ossehaas/Robot-Evolution-Lab/runs/exp2_dog/30_level_body/replay.md

# Replays of the capped plans (step 50)

Share of dogs that climbed: nominal dog (1) / randomized dogs (16). pitch err = largest pitch error of the randomized dogs [deg]. '.' = no plan.

| rise / tread | max 5 | max 10 | max 15 | free |
|---|---|---|---|---|
| 2 / 25 | . | . | . | 0% / 0% (err 90) |
| 2 / 20 | . | . | . | 0% / 0% (err 91) |
| 2 / 15 | . | . | . | 0% / 0% (err 90) |
| 2 / 12 | . | . | . | 0% / 0% (err 84) |
| 2 / 9 | . | . | . | 0% / 0% (err 87) |
| 3 / 25 | . | . | . | 0% / 0% (err 90) |
| 3 / 20 | . | . | . | 0% / 0% (err 88) |
| 3 / 15 | . | . | . | 0% / 0% (err 85) |
| 3 / 12 | . | . | . | 0% / 0% (err 85) |
| 3 / 9 | . | . | . | 0% / 0% (err 84) |
| 4 / 25 | . | . | . | 0% / 0% (err 85) |
| 4 / 20 | . | . | . | 0% / 0% (err 83) |
| 4 / 15 | . | . | . | 0% / 0% (err 93) |
| 4 / 12 | . | . | . | 0% / 0% (err 80) |
| 4 / 9 | . | . | . | 0% / 0% (err 79) |
| 5 / 25 | . | . | . | 0% / 0% (err 95) |
| 5 / 20 | . | . | . | 0% / 0% (err 94) |
| 5 / 15 | . | . | . | 0% / 0% (err 81) |

Mean over the stairs each has a plan for, randomized: max 5: 0%, max 10: 0%, max 15: 0%, free: 0%
