ossehaas/Robot-Evolution-Lab/runs/exp2_dog/30_level_body/replay_open.md

# Replays of the capped plans (step 50)

Share of dogs that climbed without a fall: nominal dog (1) / randomized dogs (16). '.' = no plan.

## open, balance margin 1.5 cm

| rise / tread | max 5 | max 10 | max 15 | free |
|---|---|---|---|---|
| 2 / 25 | 0% / 44% | 0% / 38% | 0% / 31% | 0% / 44% |
| 2 / 20 | 0% / 50% | 0% / 50% | 0% / 38% | 0% / 88% |
| 2 / 15 | 0% / 19% | 0% / 6% | 0% / 12% | 0% / 19% |
| 2 / 12 | 0% / 19% | 0% / 75% | 0% / 75% | 0% / 75% |
| 2 / 9 | 0% / 62% | 0% / 75% | 0% / 81% | 0% / 81% |
| 3 / 25 | 0% / 38% | 0% / 50% | 0% / 56% | 0% / 38% |
| 3 / 20 | 0% / 0% | 0% / 0% | 0% / 6% | 0% / 0% |
| 3 / 15 | 0% / 0% | 0% / 19% | 0% / 19% | 0% / 12% |
| 3 / 12 | 0% / 12% | 0% / 94% | 0% / 75% | 0% / 88% |
| 3 / 9 | 100% / 88% | 0% / 81% | 0% / 62% | 0% / 81% |
| 4 / 25 | 0% / 75% | 0% / 44% | 0% / 56% | 0% / 44% |
| 4 / 20 | 100% / 94% | 0% / 38% | 0% / 75% | 0% / 62% |
| 4 / 15 | . | 0% / 81% | 0% / 69% | 0% / 81% |
| 4 / 12 | . | 0% / 94% | 0% / 81% | 0% / 81% |
| 4 / 9 | . | . | 0% / 50% | 0% / 94% |
| 5 / 25 | 0% / 31% | 0% / 6% | 0% / 38% | 0% / 12% |
| 5 / 20 | 0% / 81% | 0% / 50% | 0% / 50% | 0% / 50% |
| 5 / 15 | . | . | . | 0% / 56% |

Randomized dogs that climbed, mean over the 14 stairs all four have a plan for: max 5 44%, max 10 45%, max 15 48%, free 50%

## open, balance margin 3.0 cm

| rise / tread | max 5 | max 10 | max 15 | free |
|---|---|---|---|---|
| 2 / 25 | 0% / 19% | 0% / 12% | 0% / 6% | 0% / 12% |
| 2 / 15 | 0% / 62% | 0% / 19% | 0% / 81% | 0% / 81% |
| 2 / 12 | 0% / 44% | 0% / 56% | 0% / 69% | 0% / 69% |
| 2 / 9 | 0% / 50% | 0% / 94% | 0% / 88% | 0% / 88% |
| 3 / 25 | 0% / 44% | 0% / 31% | 0% / 25% | 0% / 38% |
| 3 / 15 | . | 0% / 56% | 0% / 62% | 0% / 38% |
| 3 / 12 | 0% / 25% | 0% / 75% | 0% / 69% | 0% / 69% |
| 4 / 25 | 0% / 31% | 0% / 56% | 0% / 38% | 0% / 19% |

Randomized dogs that climbed, mean over the 7 stairs all four have a plan for: max 5 39%, max 10 49%, max 15 54%, free 54%

## feedback, balance margin 3.0 cm

| rise / tread | max 5 | max 10 | max 15 | free |
|---|---|---|---|---|
| 2 / 25 | 0% / 0% | 0% / 0% | 0% / 0% | 0% / 0% |
| 2 / 15 | 0% / 0% | 0% / 0% | 0% / 0% | 0% / 0% |
| 2 / 12 | 0% / 0% | 0% / 0% | 0% / 0% | 0% / 0% |
| 2 / 9 | 0% / 0% | 0% / 0% | 0% / 0% | 0% / 0% |
| 3 / 25 | 0% / 0% | 0% / 0% | 0% / 0% | 0% / 0% |
| 3 / 15 | . | 0% / 0% | 0% / 0% | 0% / 0% |
| 3 / 12 | 0% / 0% | 0% / 0% | 0% / 0% | 0% / 0% |
| 4 / 25 | 0% / 0% | 0% / 0% | 0% / 0% | 0% / 0% |

Randomized dogs that climbed, mean over the 7 stairs all four have a plan for: max 5 0%, max 10 0%, max 15 0%, free 0%
