ossehaas/Robot-Evolution-Lab/prototypes/puppy/images/puppy_before_after.png

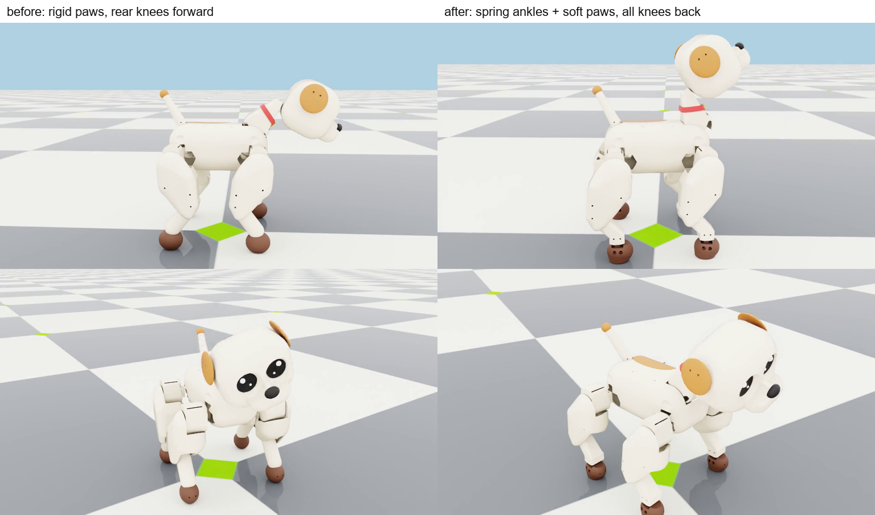
prototypes/puppy/images/puppy_before_after.png
