ossehaas/Robot-Evolution-Lab/prototypes/puppy/images/puppy_exploded.png

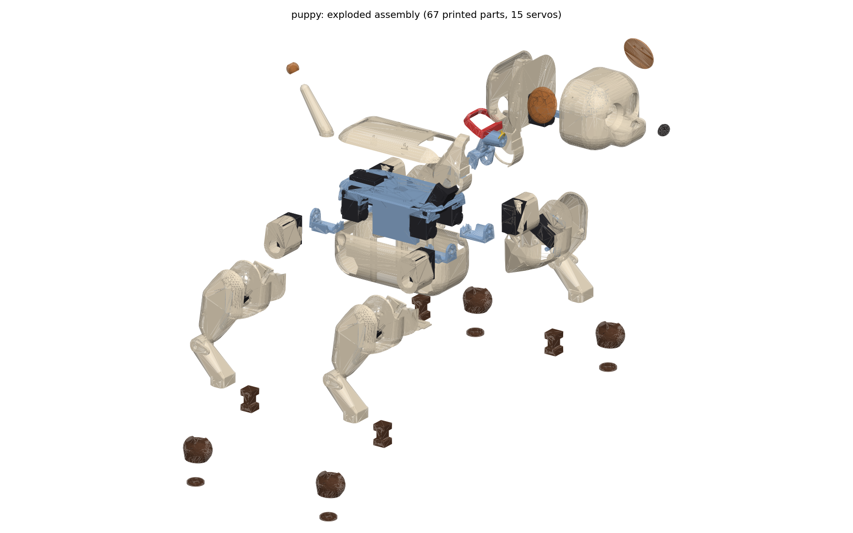
prototypes/puppy/images/puppy_exploded.png
