ossehaas/Robot-Evolution-Lab/prototypes/puppy/images/puppy_side.png

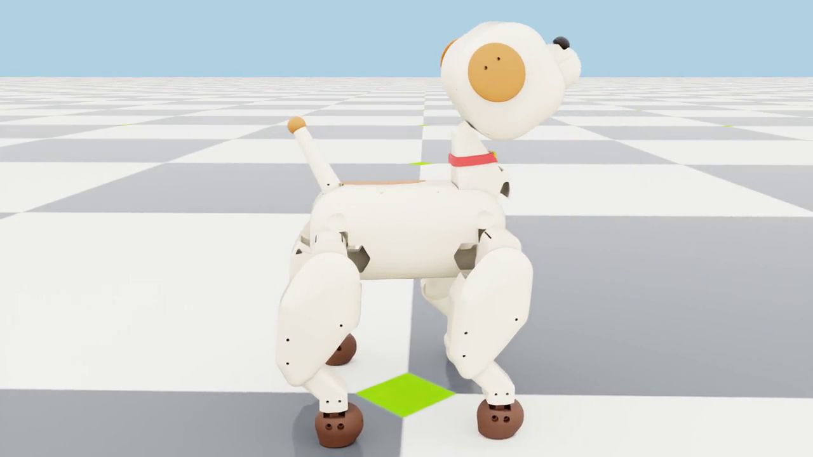
prototypes/puppy/images/puppy_side.png
