ossehaas/Robot-Evolution-Lab/prototypes/puppy/preview.png

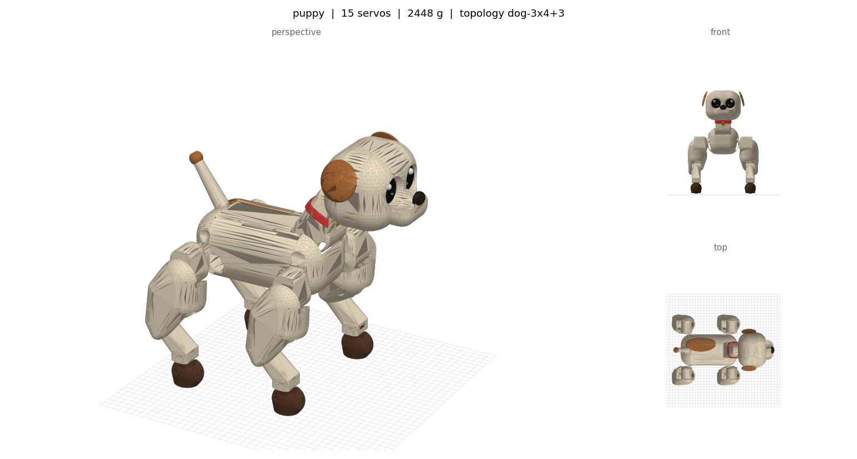
prototypes/puppy/preview.png
