ossehaas/Robot-Evolution-Lab/prototypes/puppy/print/BOM.md

# Bill of materials: puppy

Total mass (simulated): **2448 g**, of which printed parts ~1185 g.
Servos: 15 x Feetech STS3215 (12 V); rest height of the chassis centre: 191 mm.

## Printed parts

| Part | Material | Mass (g) | Size on the bed (mm) | File | Notes |
|---|---|---|---|---|---|
| head | PLA | 109.1 | 125 x 105 x 101 | `stl/head.stl` | face + snout, eye openings; print standing on the back rim (face up) |
| head_back | PLA | 35.1 | 115 x 95 x 19 | `stl/head_back.stl` | back of the head; print on its rim |
| head_mount | PLA | 32.9 | 119 x 99 x 4 | `stl/head_mount.stl` | plate between head and head back: carries the tilt servo and the eye frame; print flat |
| eye_frame | PLA | 12.9 | 108 x 44 x 65 | `stl/eye_frame.stl` | holds the two round displays; print on the front face |
| nose | PLA | 1.8 | 24 x 18 x 11 | `stl/nose.stl` | black PLA, print on the flat back, glue into its pocket |
| ear_L | TPU | 7.6 | 52 x 55 x 7 | `stl/ear_L.stl` | TPU 95A, print on the flat back |
| ear_R | TPU | 7.6 | 52 x 55 x 7 | `stl/ear_R.stl` | TPU 95A, print on the flat back |
| neck_yoke | PLA | 16.7 | 45 x 68 x 56 | `stl/neck_yoke.stl` | U-bracket on both neck horns + stem to the head-tilt horn; print on the stem plate |
| collar | TPU | 6.2 | 44 x 59 x 9 | `stl/collar.stl` | TPU ring, stretch over the neck into its groove |
| collar_tag | PLA | 0.5 | 14 x 16 x 8 | `stl/collar_tag.stl` | yellow PLA tag, glue to the collar |
| tail | PLA | 10.1 | 58 x 22 x 71 | `stl/tail.stl` | print standing on the base disc |
| tail_tip | PLA | 2.0 | 19 x 19 x 14 | `stl/tail_tip.stl` | print on the flat, glue onto the tail peg |
| neck_L | PLA | 11.9 | 55 x 94 x 27 | `stl/neck_L.stl` | neck shell half; print on the split face |
| neck_R | PLA | 11.2 | 55 x 90 x 27 | `stl/neck_R.stl` | neck shell half; print on the split face |
| deck | PLA | 107.0 | 187 x 98 x 73 | `stl/deck.stl` | structural core: servo saddles, battery bay, tail shelf; print upside down (top face on the bed) |
| neck_mount | PLA | 3.0 | 31 x 48 x 16 | `stl/neck_mount.stl` | holds the neck servo on the deck; print on its base |
| cap | PLA | 46.1 | 188 x 100 x 19 | `stl/cap.stl` | the back; print on its rim (no supports, the roof bridges) |
| bowl | PLA | 121.5 | 200 x 110 x 76 | `stl/bowl.stl` | belly and flanks; print upside down on its rim |
| belly_hatch | PLA | 9.6 | 96 x 37 x 4 | `stl/belly_hatch.stl` | battery door; print flat, outside down |
| yoke_front_L | PLA | 7.9 | 45 x 33 x 27 | `stl/yoke_front_L.stl` | U-bracket on both abduction horns; print standing on the bridge |
| shoulder_front_L | PLA | 27.8 | 38 x 58 x 48 | `stl/shoulder_front_L.stl` | pad + hip bracket + tongue; print on the flat outboard rim, no supports |
| thigh_front_L | PLA | 26.6 | 80 x 110 x 35 | `stl/thigh_front_L.stl` | structural thigh: hip hub, knee servo pocket, knee fork; print on the flat outboard face |
| thigh_cover_out_front_L | PLA | 24.4 | 77 x 123 x 19 | `stl/thigh_cover_out_front_L.stl` | outer thigh cover over crank and pushrod; print on its rim |
| thigh_cover_in_front_L | PLA | 14.9 | 67 x 70 x 14 | `stl/thigh_cover_in_front_L.stl` | inner thigh cover over the knee servo connectors; print on its rim |
| crank_front_L | PLA | 2.2 | 34 x 21 x 4 | `stl/crank_front_L.stl` | knee crank on the knee servo horn |
| pushrod_front_L | PLA | 2.9 | 20 x 61 x 5 | `stl/pushrod_front_L.stl` | knee pushrod, 683ZZ bearing pressed into each eye |
| knee_spacer_front_L | PLA | 0.2 | 6 x 6 x 8 | `stl/knee_spacer_front_L.stl` | spacer tube on the knee axle |
| shin_front_L | PLA | 23.2 | 65 x 68 x 31 | `stl/shin_front_L.stl` | shin with knee boss and lever; print on the flat lever face |
| ankle_spring_front_L | TPU | 11.7 | 20 x 34 x 20 | `stl/ankle_spring_front_L.stl` | TPU 95A, 100 % infill (solid); print lying on its side; blade 7.78 x 14.3 mm = 1.50 N*m/rad (tune: README) |
| paw_front_L | TPU | 13.7 | 47 x 38 x 33 | `stl/paw_front_L.stl` | TPU 95A, 3 walls, 15 % infill; print standing on its rim (sole opening down) |
| sole_front_L | TPU | 2.5 | 26 x 26 x 8 | `stl/sole_front_L.stl` | TPU 95A, 100 % infill (solid); print flat, arms on the bed; arms 4.23 mm = 10.0 N/mm; snaps into the paw |
| yoke_front_R | PLA | 7.9 | 45 x 33 x 27 | `stl/yoke_front_R.stl` | U-bracket on both abduction horns; print standing on the bridge |
| shoulder_front_R | PLA | 27.8 | 38 x 58 x 48 | `stl/shoulder_front_R.stl` | pad + hip bracket + tongue; print on the flat outboard rim, no supports |
| thigh_front_R | PLA | 26.6 | 80 x 110 x 35 | `stl/thigh_front_R.stl` | structural thigh: hip hub, knee servo pocket, knee fork; print on the flat outboard face |
| thigh_cover_out_front_R | PLA | 24.4 | 77 x 123 x 19 | `stl/thigh_cover_out_front_R.stl` | outer thigh cover over crank and pushrod; print on its rim |
| thigh_cover_in_front_R | PLA | 14.9 | 67 x 70 x 14 | `stl/thigh_cover_in_front_R.stl` | inner thigh cover over the knee servo connectors; print on its rim |
| crank_front_R | PLA | 2.2 | 34 x 21 x 4 | `stl/crank_front_R.stl` | knee crank on the knee servo horn |
| pushrod_front_R | PLA | 2.9 | 20 x 61 x 5 | `stl/pushrod_front_R.stl` | knee pushrod, 683ZZ bearing pressed into each eye |
| knee_spacer_front_R | PLA | 0.2 | 6 x 6 x 8 | `stl/knee_spacer_front_R.stl` | spacer tube on the knee axle |
| shin_front_R | PLA | 23.2 | 65 x 68 x 31 | `stl/shin_front_R.stl` | shin with knee boss and lever; print on the flat lever face |
| ankle_spring_front_R | TPU | 11.7 | 20 x 34 x 20 | `stl/ankle_spring_front_R.stl` | TPU 95A, 100 % infill (solid); print lying on its side; blade 7.78 x 14.3 mm = 1.50 N*m/rad (tune: README) |
| paw_front_R | TPU | 13.7 | 47 x 38 x 33 | `stl/paw_front_R.stl` | TPU 95A, 3 walls, 15 % infill; print standing on its rim (sole opening down) |
| sole_front_R | TPU | 2.5 | 26 x 26 x 8 | `stl/sole_front_R.stl` | TPU 95A, 100 % infill (solid); print flat, arms on the bed; arms 4.23 mm = 10.0 N/mm; snaps into the paw |
| yoke_rear_L | PLA | 7.9 | 45 x 33 x 27 | `stl/yoke_rear_L.stl` | U-bracket on both abduction horns; print standing on the bridge |
| shoulder_rear_L | PLA | 27.8 | 38 x 58 x 48 | `stl/shoulder_rear_L.stl` | pad + hip bracket + tongue; print on the flat outboard rim, no supports |
| thigh_rear_L | PLA | 26.6 | 80 x 110 x 35 | `stl/thigh_rear_L.stl` | structural thigh: hip hub, knee servo pocket, knee fork; print on the flat outboard face |
| thigh_cover_out_rear_L | PLA | 24.4 | 77 x 123 x 19 | `stl/thigh_cover_out_rear_L.stl` | outer thigh cover over crank and pushrod; print on its rim |
| thigh_cover_in_rear_L | PLA | 14.9 | 67 x 70 x 14 | `stl/thigh_cover_in_rear_L.stl` | inner thigh cover over the knee servo connectors; print on its rim |
| crank_rear_L | PLA | 2.2 | 34 x 21 x 4 | `stl/crank_rear_L.stl` | knee crank on the knee servo horn |
| pushrod_rear_L | PLA | 2.9 | 20 x 61 x 5 | `stl/pushrod_rear_L.stl` | knee pushrod, 683ZZ bearing pressed into each eye |
| knee_spacer_rear_L | PLA | 0.2 | 6 x 6 x 8 | `stl/knee_spacer_rear_L.stl` | spacer tube on the knee axle |
| shin_rear_L | PLA | 23.2 | 65 x 68 x 31 | `stl/shin_rear_L.stl` | shin with knee boss and lever; print on the flat lever face |
| ankle_spring_rear_L | TPU | 11.7 | 20 x 34 x 20 | `stl/ankle_spring_rear_L.stl` | TPU 95A, 100 % infill (solid); print lying on its side; blade 7.78 x 14.3 mm = 1.50 N*m/rad (tune: README) |
| paw_rear_L | TPU | 13.7 | 47 x 38 x 33 | `stl/paw_rear_L.stl` | TPU 95A, 3 walls, 15 % infill; print standing on its rim (sole opening down) |
| sole_rear_L | TPU | 2.5 | 26 x 26 x 8 | `stl/sole_rear_L.stl` | TPU 95A, 100 % infill (solid); print flat, arms on the bed; arms 4.23 mm = 10.0 N/mm; snaps into the paw |
| yoke_rear_R | PLA | 7.9 | 45 x 33 x 27 | `stl/yoke_rear_R.stl` | U-bracket on both abduction horns; print standing on the bridge |
| shoulder_rear_R | PLA | 27.8 | 38 x 58 x 48 | `stl/shoulder_rear_R.stl` | pad + hip bracket + tongue; print on the flat outboard rim, no supports |
| thigh_rear_R | PLA | 26.6 | 80 x 110 x 35 | `stl/thigh_rear_R.stl` | structural thigh: hip hub, knee servo pocket, knee fork; print on the flat outboard face |
| thigh_cover_out_rear_R | PLA | 24.4 | 77 x 123 x 19 | `stl/thigh_cover_out_rear_R.stl` | outer thigh cover over crank and pushrod; print on its rim |
| thigh_cover_in_rear_R | PLA | 14.9 | 67 x 70 x 14 | `stl/thigh_cover_in_rear_R.stl` | inner thigh cover over the knee servo connectors; print on its rim |
| crank_rear_R | PLA | 2.2 | 34 x 21 x 4 | `stl/crank_rear_R.stl` | knee crank on the knee servo horn |
| pushrod_rear_R | PLA | 2.9 | 20 x 61 x 5 | `stl/pushrod_rear_R.stl` | knee pushrod, 683ZZ bearing pressed into each eye |
| knee_spacer_rear_R | PLA | 0.2 | 6 x 6 x 8 | `stl/knee_spacer_rear_R.stl` | spacer tube on the knee axle |
| shin_rear_R | PLA | 23.2 | 65 x 68 x 31 | `stl/shin_rear_R.stl` | shin with knee boss and lever; print on the flat lever face |
| ankle_spring_rear_R | TPU | 11.7 | 20 x 34 x 20 | `stl/ankle_spring_rear_R.stl` | TPU 95A, 100 % infill (solid); print lying on its side; blade 7.78 x 14.3 mm = 1.50 N*m/rad (tune: README) |
| paw_rear_R | TPU | 13.7 | 47 x 38 x 33 | `stl/paw_rear_R.stl` | TPU 95A, 3 walls, 15 % infill; print standing on its rim (sole opening down) |
| sole_rear_R | TPU | 2.5 | 26 x 26 x 8 | `stl/sole_rear_R.stl` | TPU 95A, 100 % infill (solid); print flat, arms on the bed; arms 4.23 mm = 10.0 N/mm; snaps into the paw |

Filament: PLA ~1052 g, TPU ~133 g (plus ~15 % for purge and brims).

## Purchased parts

| Item | Qty |
|---|---|
| Feetech STS3215 (12 V) serial bus servo (with horn + idler horn; see servo_map.json for ids) | 15 |
| Bus servo adapter (Feetech FE-URT-1 or Waveshare) | 1 |
| ESP32-S3 SuperMini | 1 |
| MPU6050 IMU | 1 |
| LiPo 3S 1500 mAh (12 V servos), XT30 plug | 1 |
| 5 V 3 A buck converter | 1 |
| GC9A01 1.28 in round display (eye) | 2 |
| Bus servo extension leads 200-300 mm (5264 3-pin), daisy chains + head and tail | 6 |
| Mini rocker switch KCD11 (10 x 15 mm cutout), 10 A | 1 |
| Inline blade fuse holder + 7.5 A fuse | 1 |
| USB-C panel-mount extension (for the ESP32), 2 x M3 mounting holes 28 mm apart | 1 |
| Hook-and-loop strap 20 mm (battery) | 1 |
| Silicone wire 18 AWG red/black, 0.5 m each (battery, switch, fuse, bus power) | 1 |
| Dupont jumper wires 20 cm (displays share SCK/MOSI/DC/RST, own CS; IMU on I2C) | 30 |
| 683ZZ ball bearing (3 x 7 x 3 mm) | 16 |
| M2.5 nylon standoff + screw set | 8 |
| M2x8 screw + nut (display / board) | 4 |
| M2x8 self-tapping screw (pan head) | 68 |
| M3 heat-set insert (M3 x 5 x 4.0 mm) | 39 |
| M3 heat-set insert, short (M3 x 3 x 4.2 mm) | 8 |
| M3 knurled thumb screw (M3x10) | 1 |
| M3 nyloc nut | 16 |
| M3 washer | 16 |
| M3x10 countersunk screw | 4 |
| M3x12 countersunk screw | 4 |
| M3x20 countersunk screw | 8 |
| M3x20 socket head screw | 4 |
| M3x30 socket head screw | 20 |
| M3x45 socket head screw | 4 |
| M3x6 socket head screw | 80 |
| M3x8 button head screw | 8 |
| M3x8 socket head screw | 10 |

### Where the screws, inserts and bearings go

| Item | Used for |
|---|---|
| 683ZZ ball bearing (3 x 7 x 3 mm) | 2x pushrod eyes (L0); 2x knee boss (L0); 2x pushrod eyes (R0); 2x knee boss (R0); 2x pushrod eyes (L1); 2x knee boss (L1); 2x pushrod eyes (R1); 2x knee boss (R1) |
| M2.5 nylon standoff + screw set | 8x boards on the deck |
| M2x8 screw + nut (display / board) | 4x displays to eye frame (or hot glue) |
| M2x8 self-tapping screw (pan head) | 4x tilt servo to head mount; 4x neck servo to neck mount; 16x abduction servos to deck saddles; 4x tail servo to deck shelf; 4x hip servo to shoulder bracket (L0); 4x knee servo to thigh (L0); 2x inner thigh cover to knee servo (L0); 4x hip servo to shoulder bracket (R0); 4x knee servo to thigh (R0); 2x inner thigh cover to knee servo (R0); 4x hip servo to shoulder bracket (L1); 4x knee servo to thigh (L1); 2x inner thigh cover to knee servo (L1); 4x hip servo to shoulder bracket (R1); 4x knee servo to thigh (R1); 2x inner thigh cover to knee servo (R1) |
| M3 heat-set insert (M3 x 5 x 4.0 mm) | 4x face columns; 2x eye frame legs; 2x neck yoke (shell screws); 4x cap columns; 1x hatch thumb screw; 2x deck (neck mount); 2x yoke flange (shoulder screws) (L0); 2x ankle spring socket (inboard cheek) (L0); 2x outer thigh cover (L0); 2x yoke flange (shoulder screws) (R0); 2x ankle spring socket (inboard cheek) (R0); 2x outer thigh cover (R0); 2x yoke flange (shoulder screws) (L1); 2x ankle spring socket (inboard cheek) (L1); 2x outer thigh cover (L1); 2x yoke flange (shoulder screws) (R1); 2x ankle spring socket (inboard cheek) (R1); 2x outer thigh cover (R1) |
| M3 heat-set insert, short (M3 x 3 x 4.2 mm) | 1x crank pin (L0); 1x knee lever pin (L0); 1x crank pin (R0); 1x knee lever pin (R0); 1x crank pin (L1); 1x knee lever pin (L1); 1x crank pin (R1); 1x knee lever pin (R1) |
| M3 knurled thumb screw (M3x10) | 1x belly hatch |
| M3 nyloc nut | 4x ears; 1x knee axle (L0); 2x ankle spring to paw (in the inboard hex recesses) (L0); 1x knee axle (R0); 2x ankle spring to paw (in the inboard hex recesses) (R0); 1x knee axle (L1); 2x ankle spring to paw (in the inboard hex recesses) (L1); 1x knee axle (R1); 2x ankle spring to paw (in the inboard hex recesses) (R1) |
| M3 washer | 4x pushrod pins (L0); 4x pushrod pins (R0); 4x pushrod pins (L1); 4x pushrod pins (R1) |
| M3x10 countersunk screw | 2x eye frame to head mount; 2x neck shell halves to the yoke (under the collar) |
| M3x12 countersunk screw | 4x ears |
| M3x20 countersunk screw | 2x outer thigh cover (L0); 2x outer thigh cover (R0); 2x outer thigh cover (L1); 2x outer thigh cover (R1) |
| M3x20 socket head screw | 4x belly: bowl + deck + cap (long screwdriver, >= 80 mm) |
| M3x30 socket head screw | 4x head back + mount + face; 2x ankle spring to shin (from outboard) (L0); 2x ankle spring to paw (through the paw) (L0); 2x ankle spring to shin (from outboard) (R0); 2x ankle spring to paw (through the paw) (R0); 2x ankle spring to shin (from outboard) (L1); 2x ankle spring to paw (through the paw) (L1); 2x ankle spring to shin (from outboard) (R1); 2x ankle spring to paw (through the paw) (R1) |
| M3x45 socket head screw | 1x knee axle (L0); 1x knee axle (R0); 1x knee axle (L1); 1x knee axle (R1) |
| M3x6 socket head screw | 8x neck yoke to both neck-servo horns; 4x neck yoke to the tilt horn; 4x tail to tail horn; 8x yoke to both abduction horns (L0); 4x thigh hub to hip horn (L0); 4x crank to knee horn (L0); 8x yoke to both abduction horns (R0); 4x thigh hub to hip horn (R0); 4x crank to knee horn (R0); 8x yoke to both abduction horns (L1); 4x thigh hub to hip horn (L1); 4x crank to knee horn (L1); 8x yoke to both abduction horns (R1); 4x thigh hub to hip horn (R1); 4x crank to knee horn (R1) |
| M3x8 button head screw | 2x pushrod pins (L0); 2x pushrod pins (R0); 2x pushrod pins (L1); 2x pushrod pins (R1) |
| M3x8 socket head screw | 2x neck mount to deck; 2x shoulder tongue to yoke (L0); 2x shoulder tongue to yoke (R0); 2x shoulder tongue to yoke (L1); 2x shoulder tongue to yoke (R1) |

## Notes

- Every STL is already laid flat in its print orientation (the face that goes on the bed is at z = 0); all parts print without supports. Check the first layer of the large shells in your slicer.
- PLA: 0.2 mm layers, 3 perimeters, 5 top/bottom layers, 15 % gyroid. The part masses in the table assume exactly that.
- TPU 95A (Polymaker PolyFlex TPU95; ankle springs, sole discs, paws, ears, collar) prints in its own jobs through Elegoo's TPU adapter (it cannot share a job with the CANVAS PLA): 225 C nozzle, 35-45 C textured PEI, fan on, 20-30 mm/s (Polymaker: 210-230 C, bed 25-60 C, 30-50 mm/s), 0.2 mm layers, short slow retraction (~1 mm: long feed path), filament dried (70 C, 8 h).
- Ankle springs and sole discs are springs: print them SOLID (100 % infill, 4 walls) exactly as laid out (springs on their side, soles arms-down); their stiffness was computed for solid TPU. Paws, ears and collar: 3 walls, 15 % infill.
- Servo case screws: M2 self-tapping into the 1.6 mm case holes (the screws that come with the servo fit if they are >= 8 mm long). Horn screws: M3 into the aluminium horns' 2.5 mm holes (tap M3 if they are not threaded).
- Heat-set inserts go in after printing (soldering iron at ~220 C). Holes are 4.0 mm for M3 x 5 x 4.0 inserts.
- Knee pushrods: press a 683ZZ bearing (3 x 7 x 3) into each eye; crank and lever pins are M3 button head screws into short heat-set inserts. Set the servo zero so that crank and lever are parallel at the rest pose.
- `servo_map.json` lists the bus id, joint, direction sign and limits of every servo for the firmware.
