ossehaas/Robot-Evolution-Lab/prototypes/puppy/images/puppy_parts.png

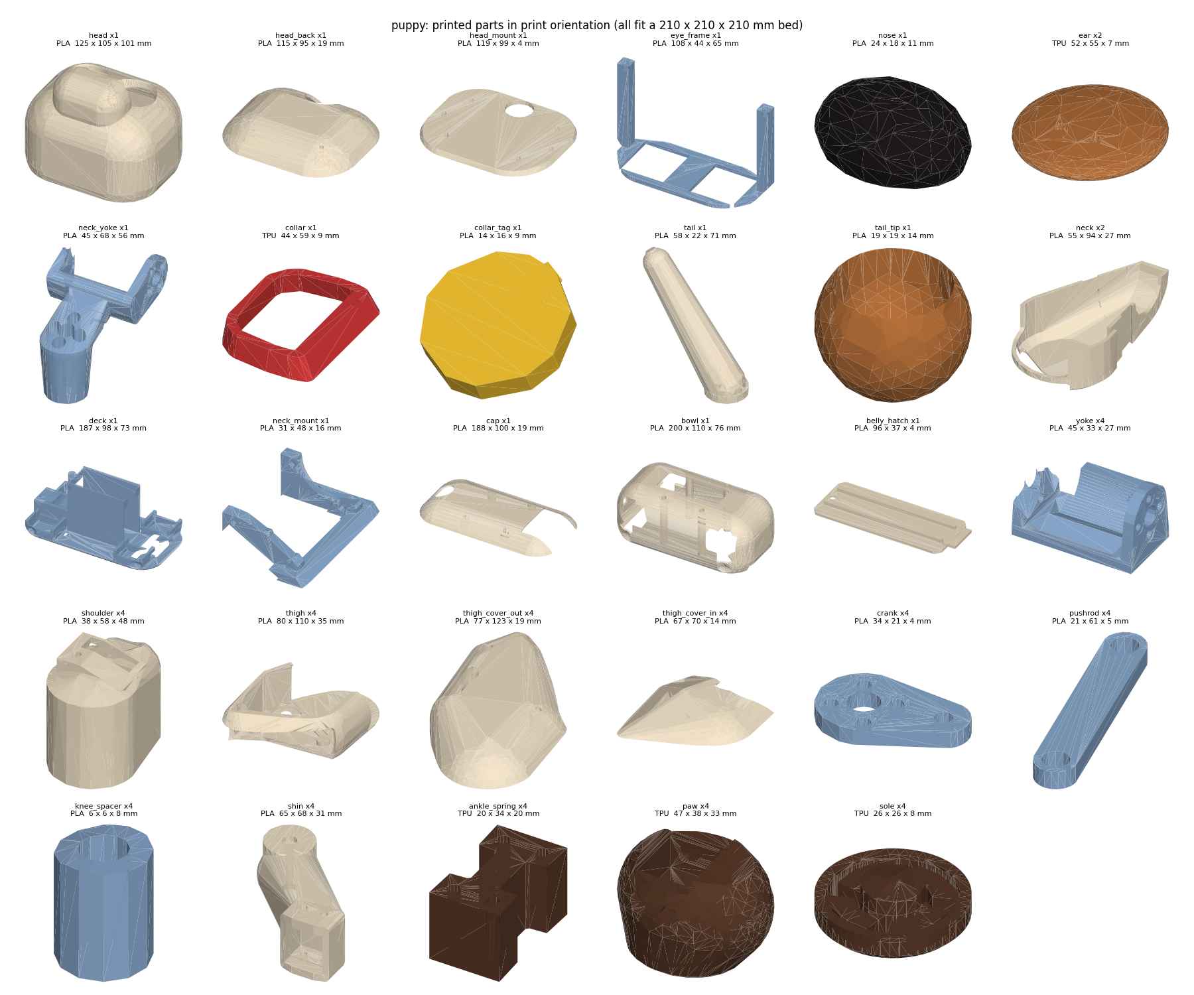
prototypes/puppy/images/puppy_parts.png
