ossehaas/Robot-Evolution-Lab/prototypes/puppy/print/stl/deck.stl

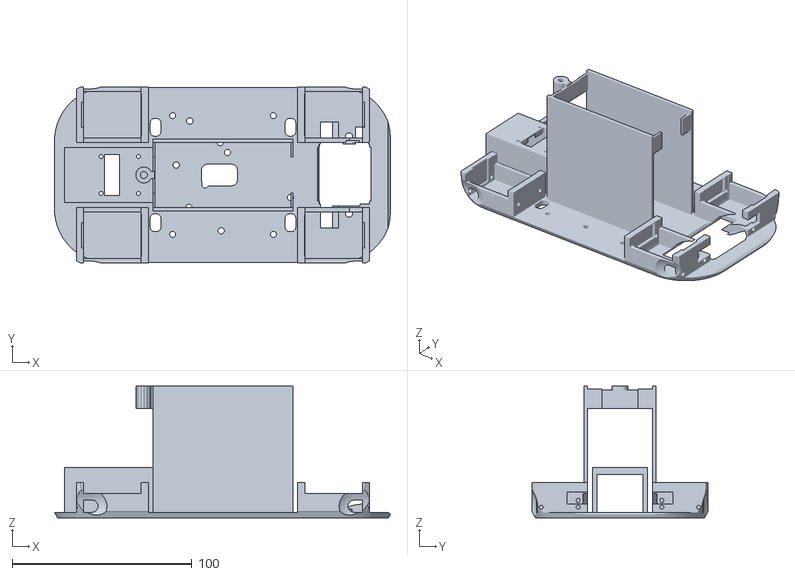
[picture p8: CAD file, 2026-10-25]
prototypes/puppy/print/stl/deck.stl
186.8 x 97.8 x 73.1
