ossehaas/Robot-Evolution-Lab/prototypes/puppy/urdf/meshes/head_color0.stl

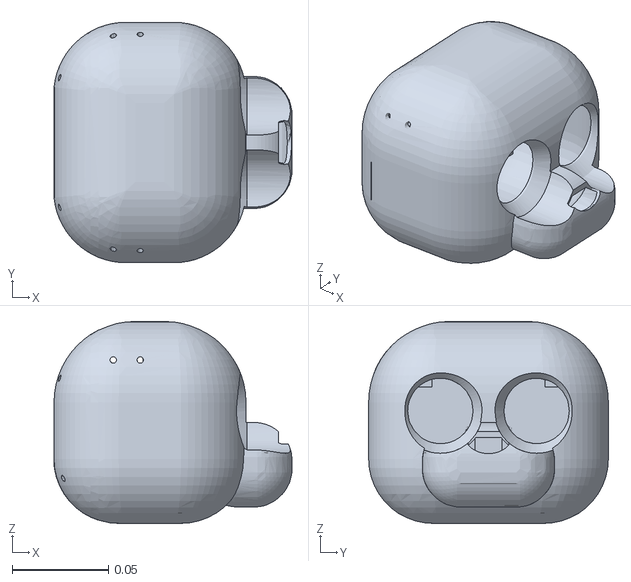
[picture p9: CAD file, 2026-10-25]
prototypes/puppy/urdf/meshes/head_color0.stl
0.124 x 0.125 x 0.105
