ossehaas/Robot-Evolution-Lab/prototypes/puppy/print/stl/yoke_rear_R.stl

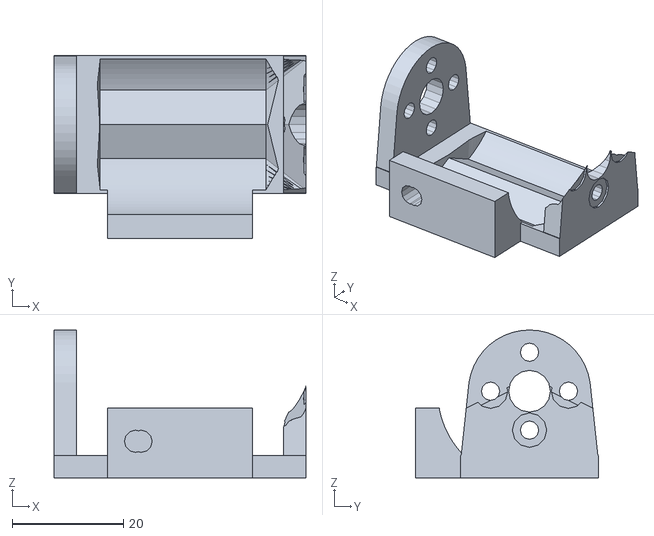
[picture p10: CAD file, 2026-10-25]
prototypes/puppy/print/stl/yoke_rear_R.stl
45.3 x 32.9 x 26.6
