ossehaas/Robot-Evolution-Lab/prototypes/puppy/urdf/meshes/L0_s0_color0.stl

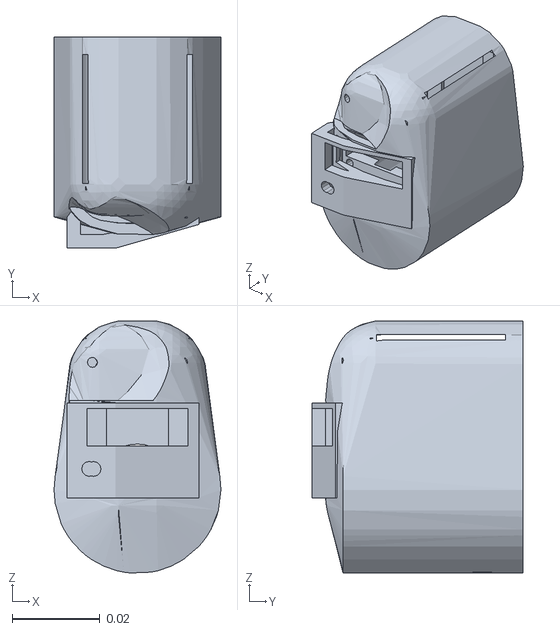
[picture p11: CAD file, 2026-10-25]
prototypes/puppy/urdf/meshes/L0_s0_color0.stl
0.038 x 0.0481 x 0.0574
