ossehaas/Robot-Evolution-Lab/prototypes/puppy/urdf/meshes/tail_color0.stl

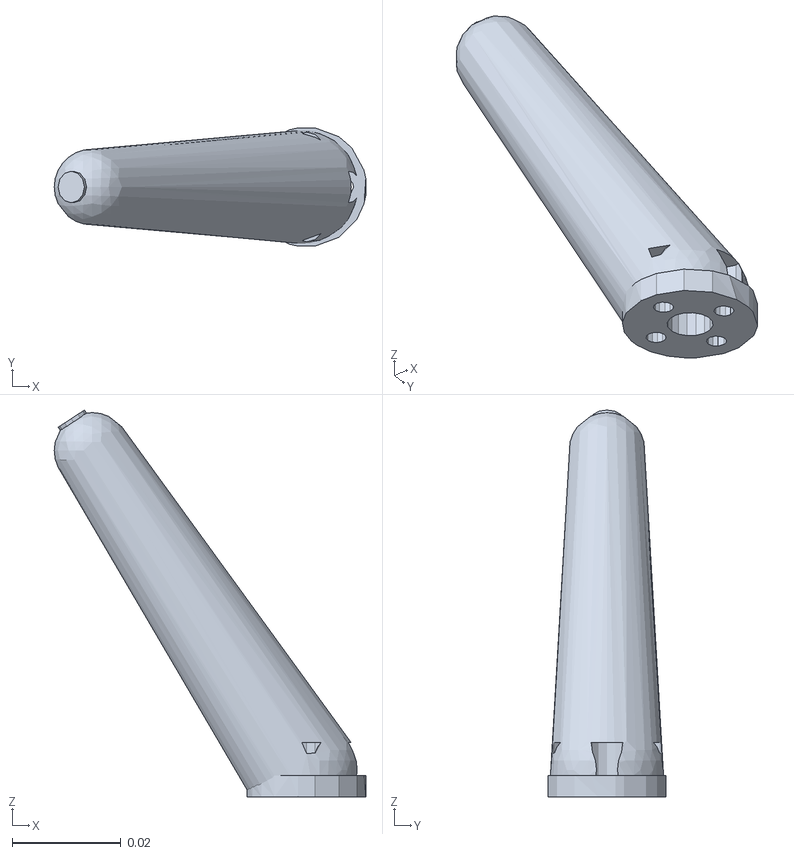
[picture p12: CAD file, 2026-10-25]
prototypes/puppy/urdf/meshes/tail_color0.stl
0.0574 x 0.0218 x 0.0713
