ossehaas/Robot-Evolution-Lab/prototypes/puppy/print/stl/shoulder_rear_R.stl

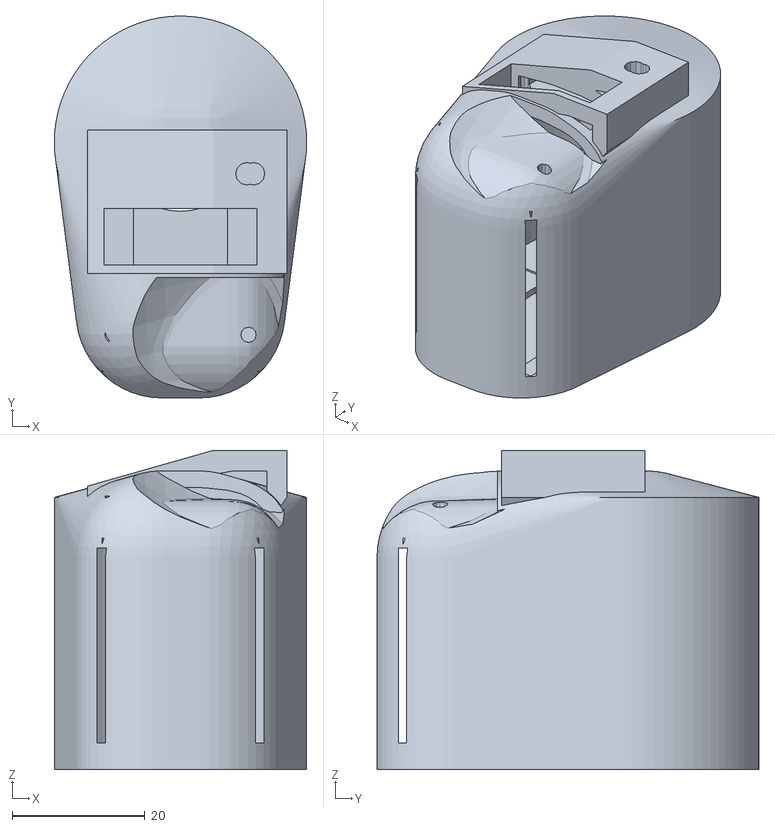
[picture p13: CAD file, 2026-10-25]
prototypes/puppy/print/stl/shoulder_rear_R.stl
38.0 x 57.5 x 48.1
