ossehaas/Robot-Evolution-Lab/prototypes/puppy/urdf/meshes/R0_s2_color2.stl

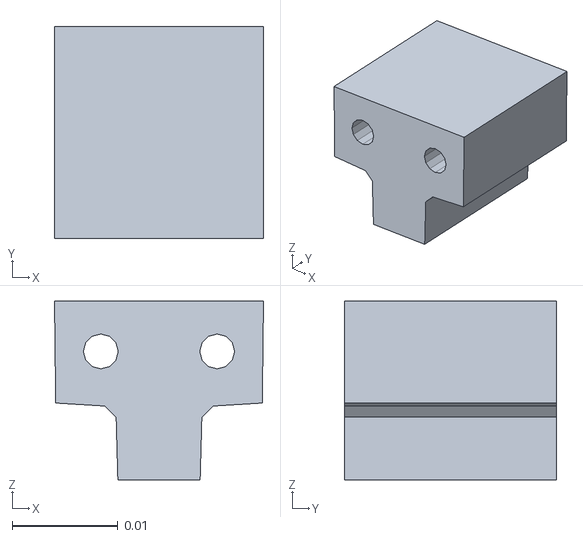
[picture p14: CAD file, 2026-10-25]
prototypes/puppy/urdf/meshes/R0_s2_color2.stl
0.0198 x 0.02 x 0.0169
