ossehaas/Robot-Evolution-Lab/prototypes/puppy/print/stl/knee_spacer_rear_R.stl

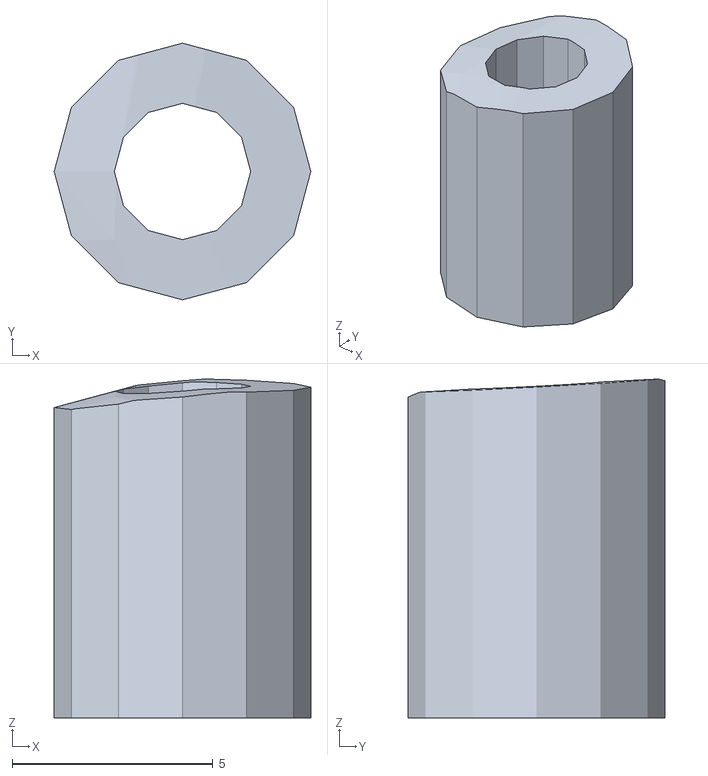
[picture p15: CAD file, 2026-10-25]
prototypes/puppy/print/stl/knee_spacer_rear_R.stl
6.40 x 6.40 x 8.45
