ossehaas/Robot-Evolution-Lab/prototypes/puppy/urdf/meshes/R0_s1_color0.stl

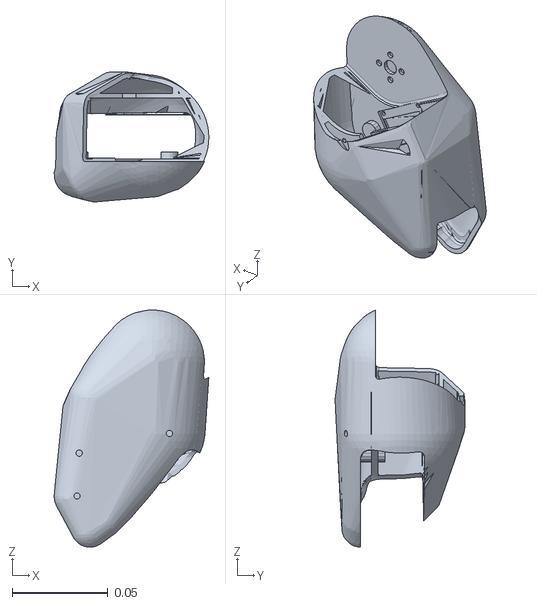
[picture p16: CAD file, 2026-10-25]
prototypes/puppy/urdf/meshes/R0_s1_color0.stl
0.0807 x 0.0677 x 0.124
