ossehaas/Robot-Evolution-Lab/prototypes/puppy/print/stl/thigh_front_R.stl

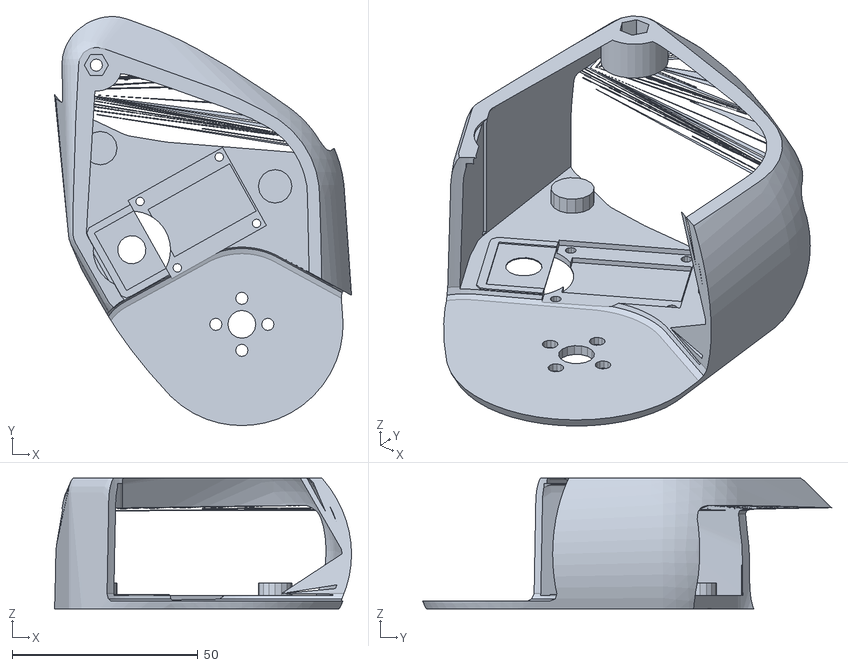
[picture p17: CAD file, 2026-10-25]
prototypes/puppy/print/stl/thigh_front_R.stl
80.0 x 110.1 x 35.2
