ossehaas/Robot-Evolution-Lab/prototypes/puppy/urdf/meshes/tail_color1.stl

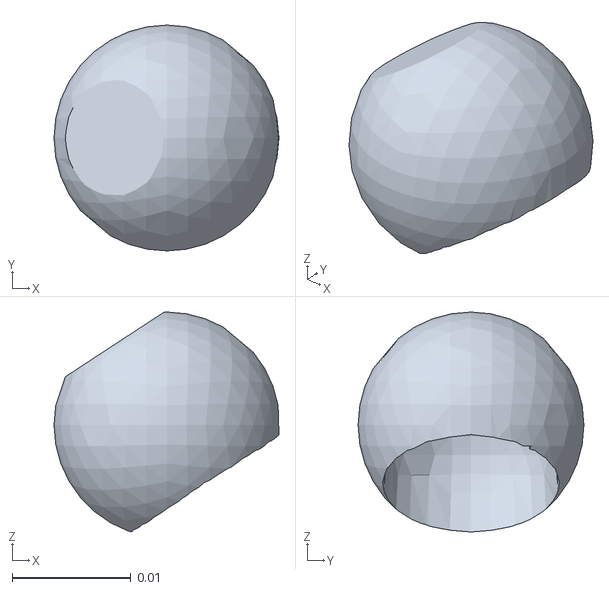
[picture p18: CAD file, 2026-10-25]
prototypes/puppy/urdf/meshes/tail_color1.stl
0.0189 x 0.019 x 0.0185
