ossehaas/Robot-Evolution-Lab/prototypes/puppy/print/stl/paw_rear_L.stl

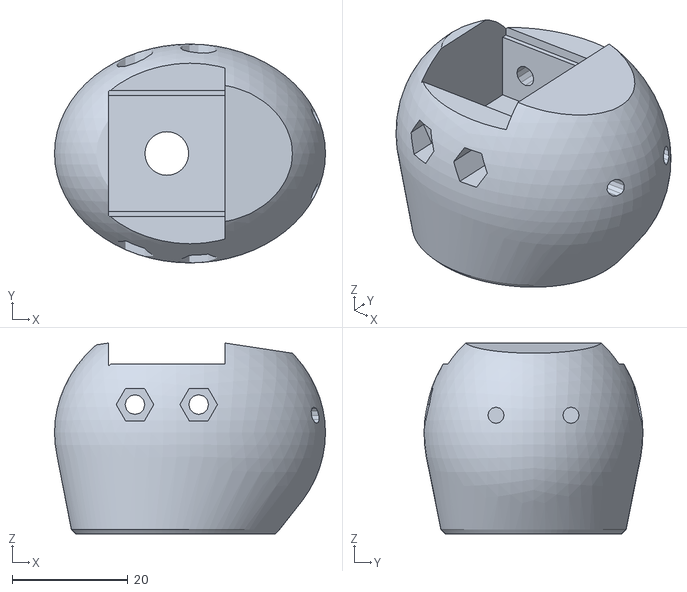
[picture p19: CAD file, 2026-10-25]
prototypes/puppy/print/stl/paw_rear_L.stl
46.8 x 37.8 x 33.0
