ossehaas/Robot-Evolution-Lab/prototypes/puppy/urdf/meshes/neck_color0.stl

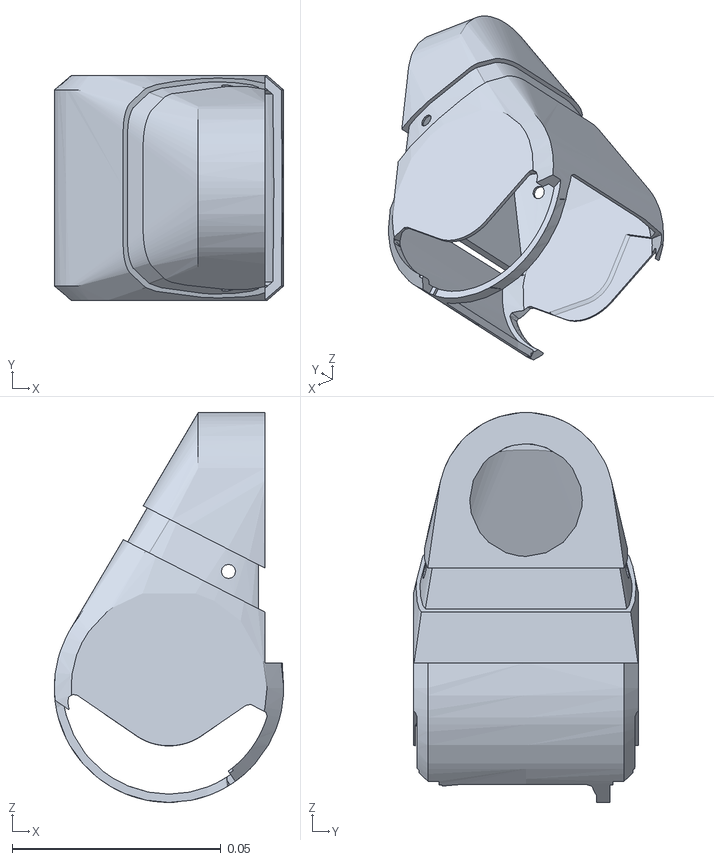
[picture p20: CAD file, 2026-10-25]
prototypes/puppy/urdf/meshes/neck_color0.stl
0.055 x 0.054 x 0.0935
