ossehaas/Robot-Evolution-Lab/prototypes/puppy/urdf/meshes/L0_s2_color0.stl

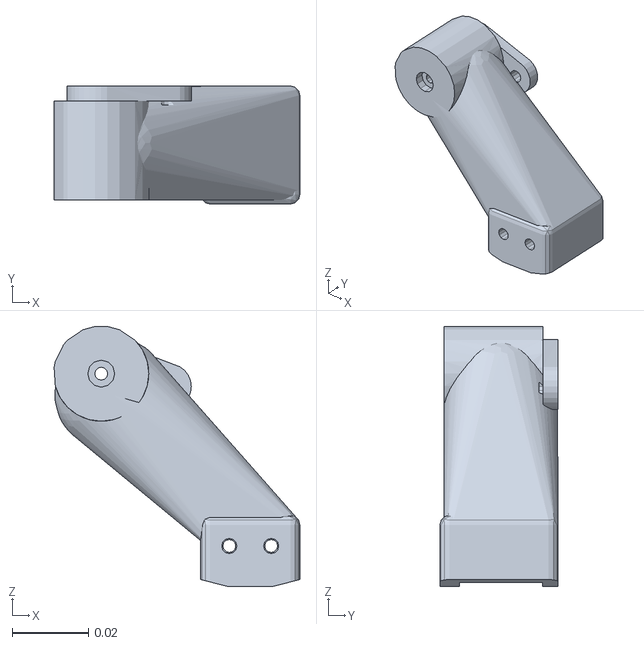
[picture p21: CAD file, 2026-10-25]
prototypes/puppy/urdf/meshes/L0_s2_color0.stl
0.0646 x 0.0311 x 0.0683
