ossehaas/Robot-Evolution-Lab/prototypes/puppy/print/stl/thigh_cover_out_front_L.stl

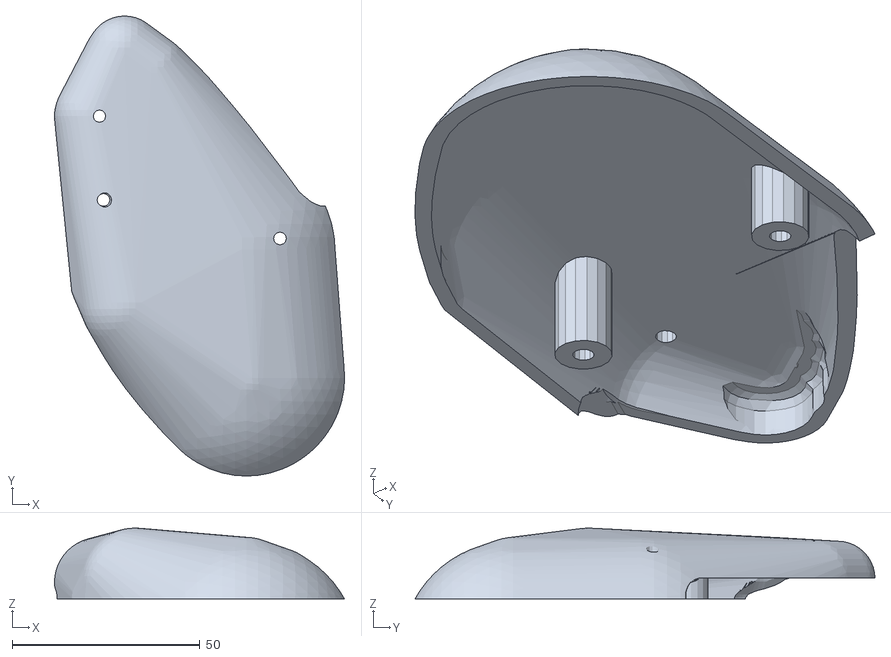
[picture p22: CAD file, 2026-10-25]
prototypes/puppy/print/stl/thigh_cover_out_front_L.stl
77.3 x 122.6 x 18.9
