ossehaas/Robot-Evolution-Lab/prototypes/puppy/print/stl/ankle_spring_rear_R.stl

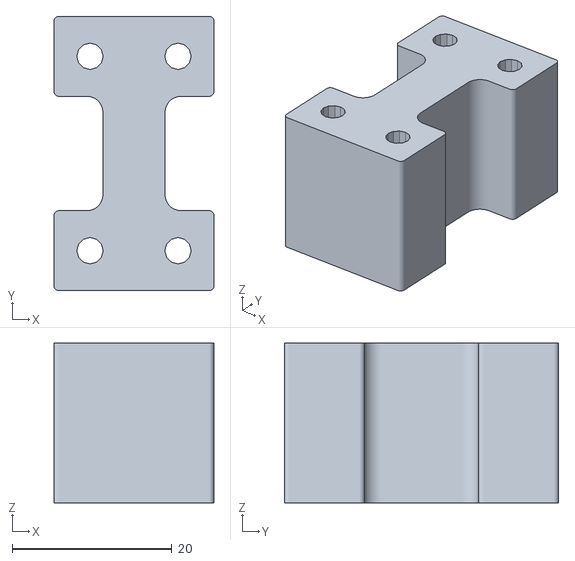
[picture p23: CAD file, 2026-10-25]
prototypes/puppy/print/stl/ankle_spring_rear_R.stl
20.0 x 34.3 x 20.0
