ossehaas/Robot-Evolution-Lab/prototypes/puppy/urdf/meshes/L1_s3_color2.stl

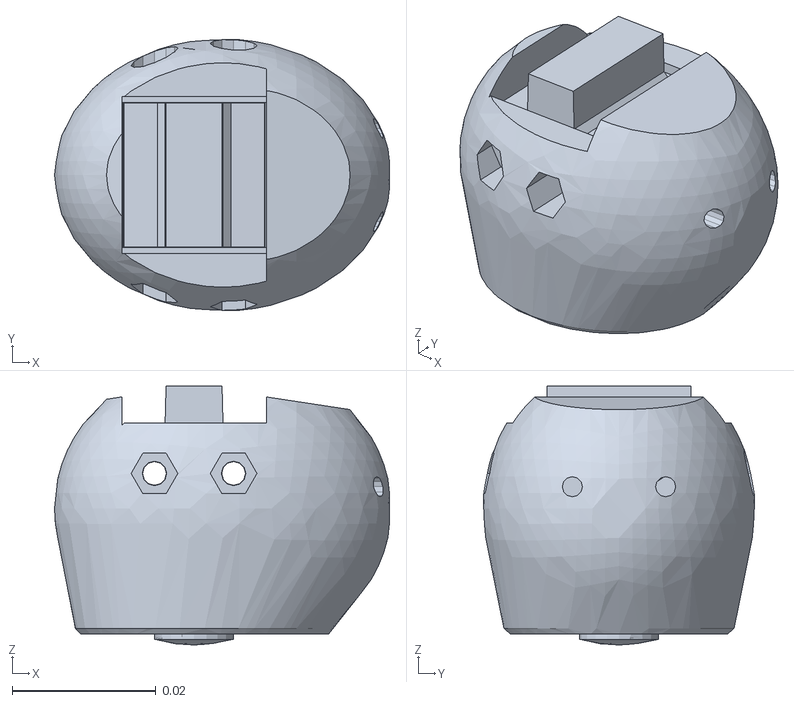
[picture p24: CAD file, 2026-10-25]
prototypes/puppy/urdf/meshes/L1_s3_color2.stl
0.0466 x 0.0376 x 0.036
