ossehaas/Robot-Evolution-Lab/prototypes/puppy/print/stl/tail_tip.stl

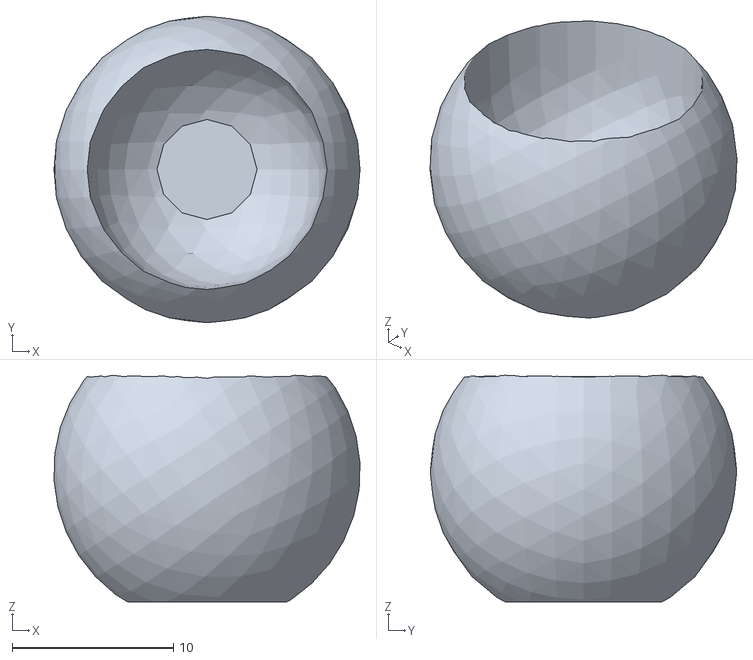
[picture p25: CAD file, 2026-10-25]
prototypes/puppy/print/stl/tail_tip.stl
19.0 x 19.0 x 14.0
