ossehaas/Robot-Evolution-Lab/prototypes/puppy/print/stl/pushrod_front_R.stl

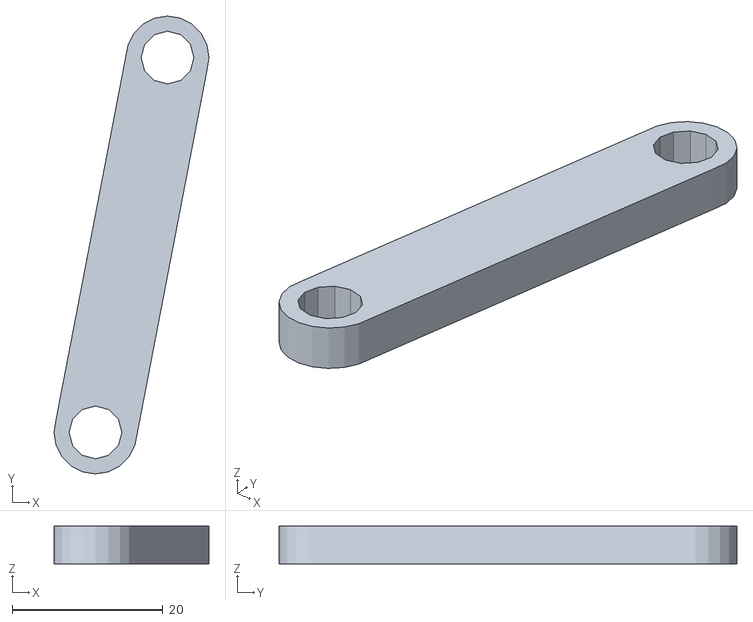
[picture p26: CAD file, 2026-10-25]
prototypes/puppy/print/stl/pushrod_front_R.stl
20.5 x 60.7 x 5.00
