ossehaas/Robot-Evolution-Lab/prototypes/puppy/urdf/meshes/chassis_color0.stl

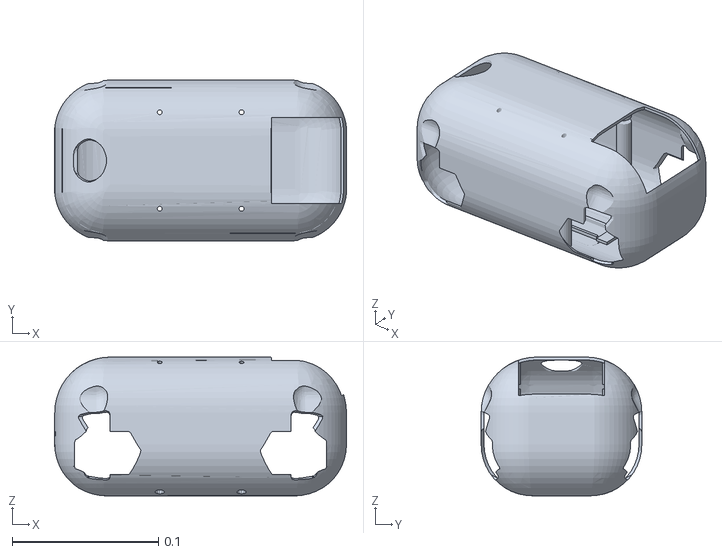
[picture p27: CAD file, 2026-10-25]
prototypes/puppy/urdf/meshes/chassis_color0.stl
0.2 x 0.11 x 0.095
