ossehaas/Robot-Evolution-Lab/prototypes/puppy/print/stl/ear_L.stl

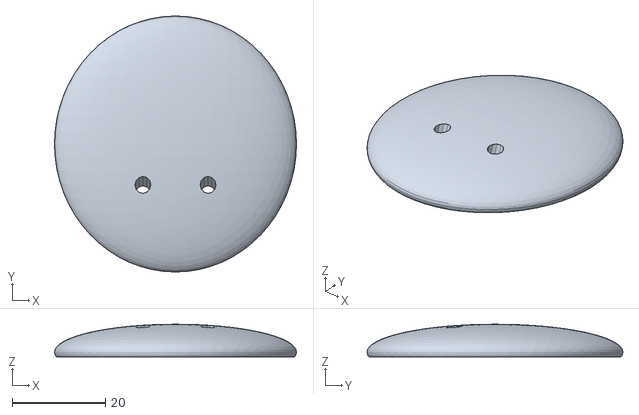
[picture p28: CAD file, 2026-10-25]
prototypes/puppy/print/stl/ear_L.stl
52.0 x 55.0 x 7.00
