ossehaas/Robot-Evolution-Lab/prototypes/puppy/urdf/meshes/head_color5.stl

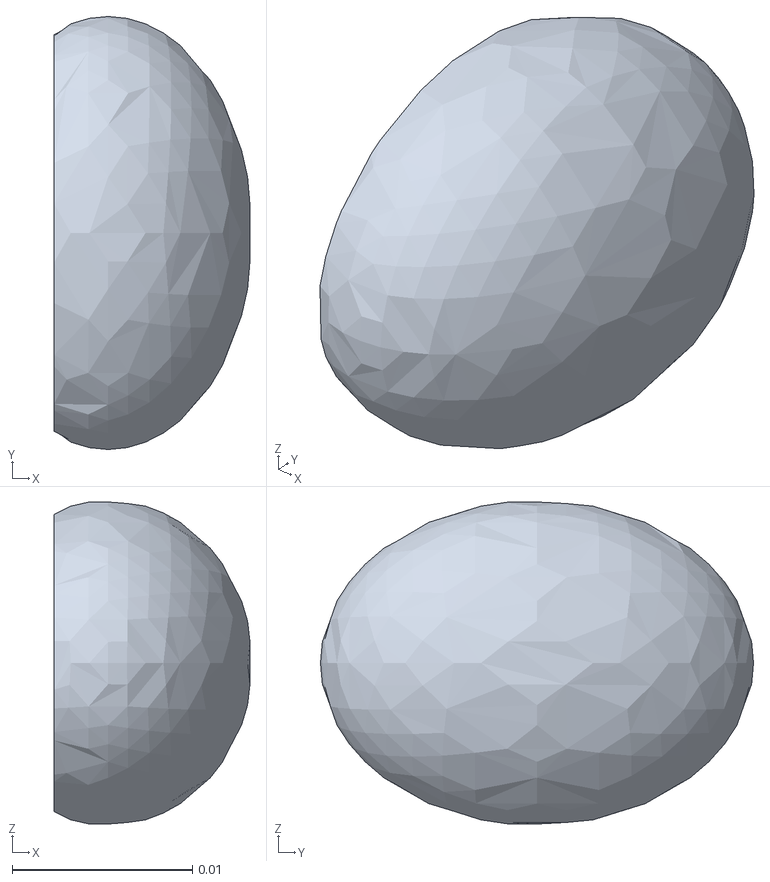
[picture p29: CAD file, 2026-10-25]
prototypes/puppy/urdf/meshes/head_color5.stl
0.0109 x 0.024 x 0.0178
