ossehaas/Robot-Evolution-Lab/prototypes/puppy/print/stl/collar_tag.stl

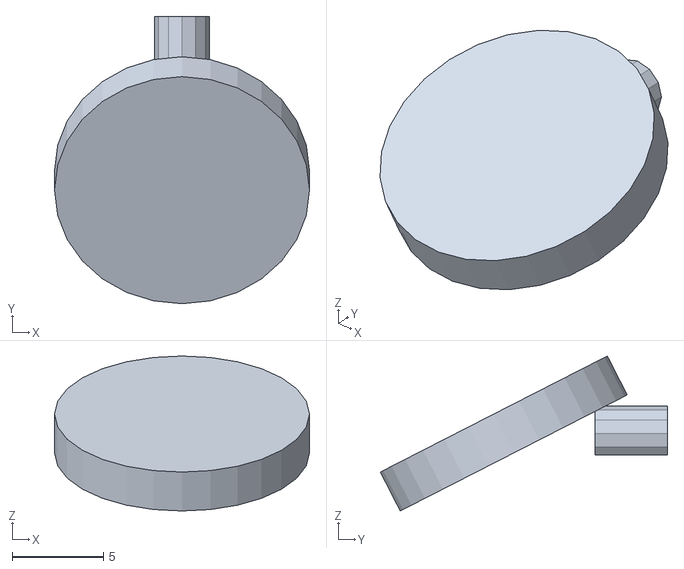
[picture p30: CAD file, 2026-10-25]
prototypes/puppy/print/stl/collar_tag.stl
14.0 x 15.8 x 8.51
