ossehaas/Robot-Evolution-Lab/prototypes/puppy/urdf/meshes/head_color7.stl

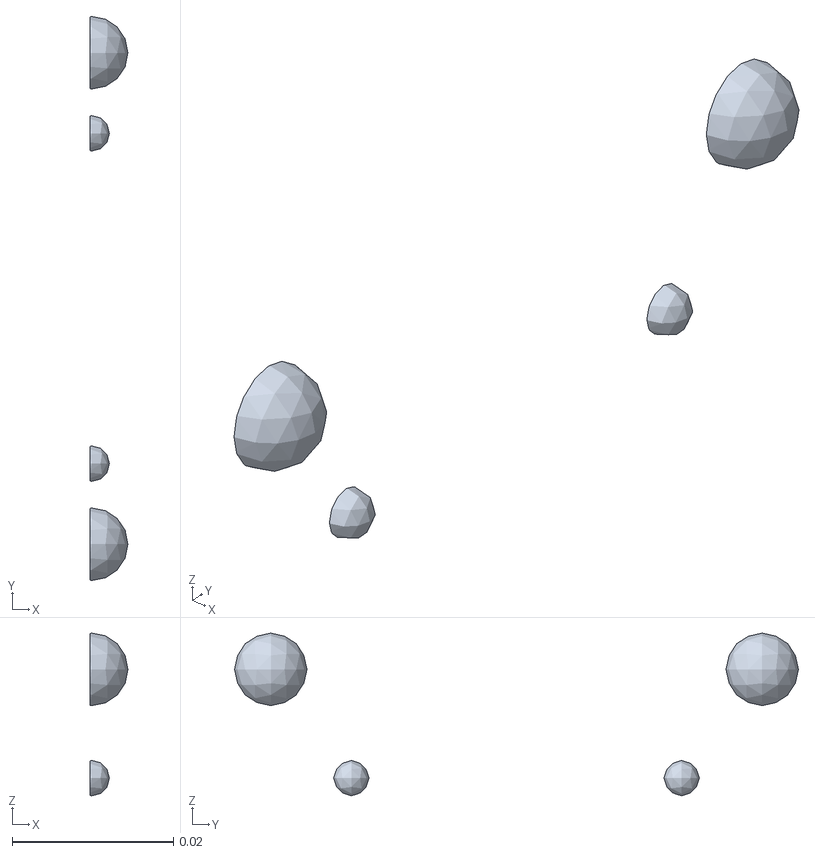
[picture p31: CAD file, 2026-10-25]
prototypes/puppy/urdf/meshes/head_color7.stl
0.0047 x 0.07 x 0.0202
