ossehaas/Robot-Evolution-Lab/prototypes/puppy/urdf/meshes/neck_color4.stl

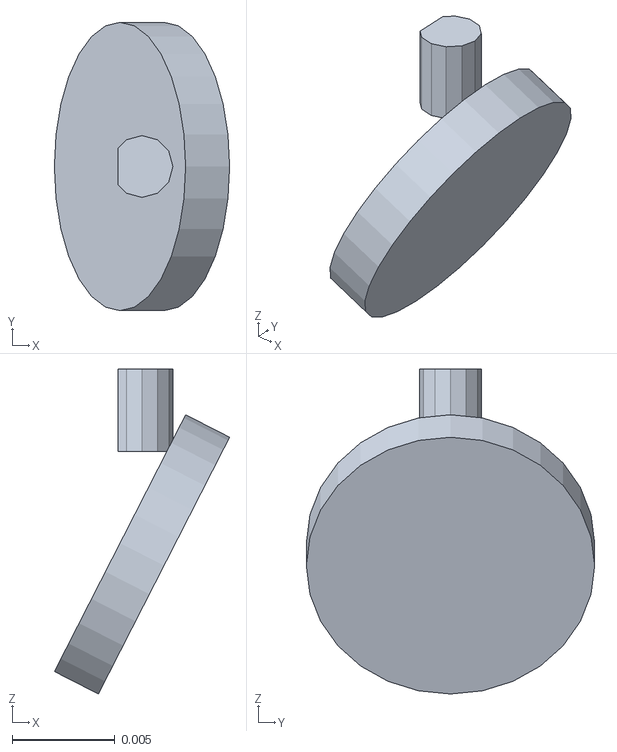
[picture p32: CAD file, 2026-10-25]
prototypes/puppy/urdf/meshes/neck_color4.stl
0.00851 x 0.014 x 0.0158
