ossehaas/Robot-Evolution-Lab/prototypes/puppy/print/stl/cap.stl

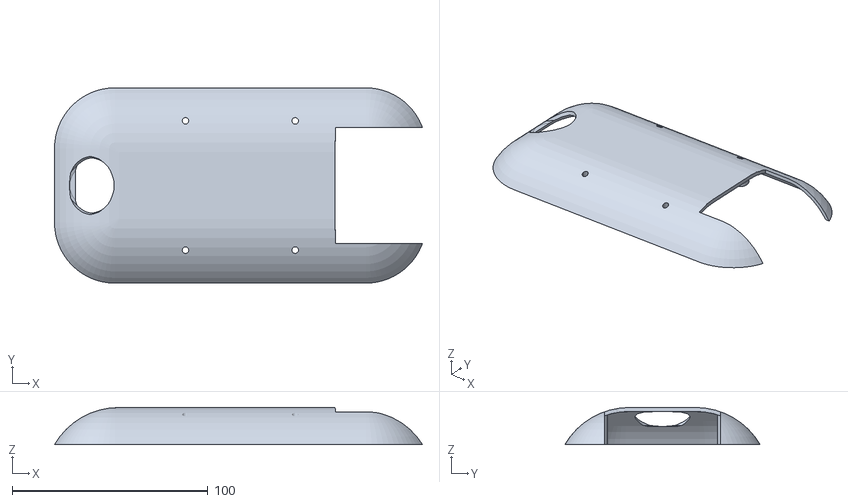
[picture p33: CAD file, 2026-10-25]
prototypes/puppy/print/stl/cap.stl
187.8 x 99.7 x 18.9
