ossehaas/Robot-Evolution-Lab/prototypes/puppy/print/stl/sole_front_L.stl

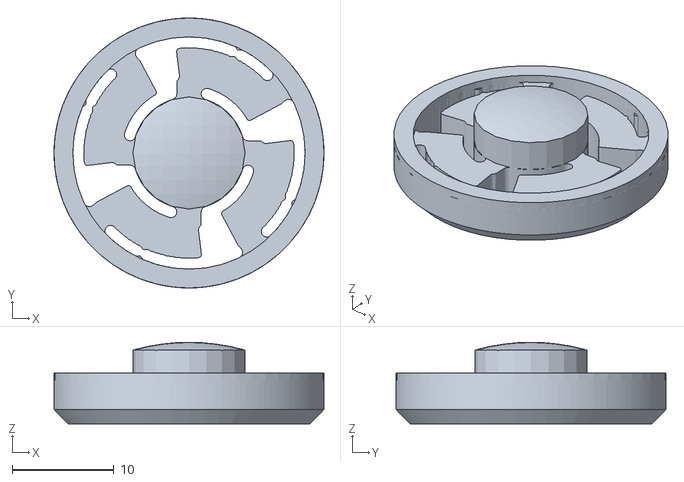
[picture p34: CAD file, 2026-10-25]
prototypes/puppy/print/stl/sole_front_L.stl
26.5 x 26.5 x 8.00
