ossehaas/Robot-Evolution-Lab/prototypes/puppy/urdf/meshes/neck_color3.stl

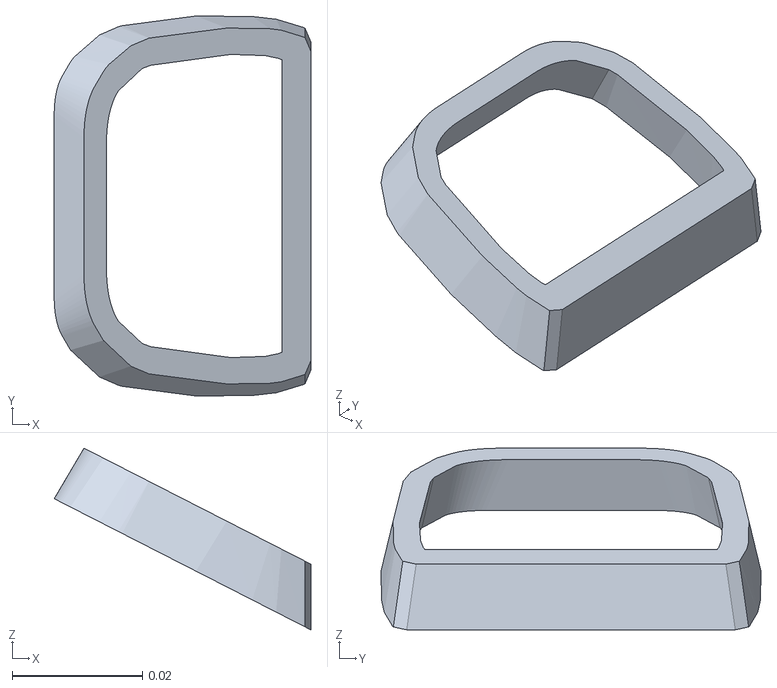
[picture p35: CAD file, 2026-10-25]
prototypes/puppy/urdf/meshes/neck_color3.stl
0.0395 x 0.0584 x 0.0279
