ossehaas/Robot-Evolution-Lab/prototypes/puppy/print/stl/crank_rear_R.stl

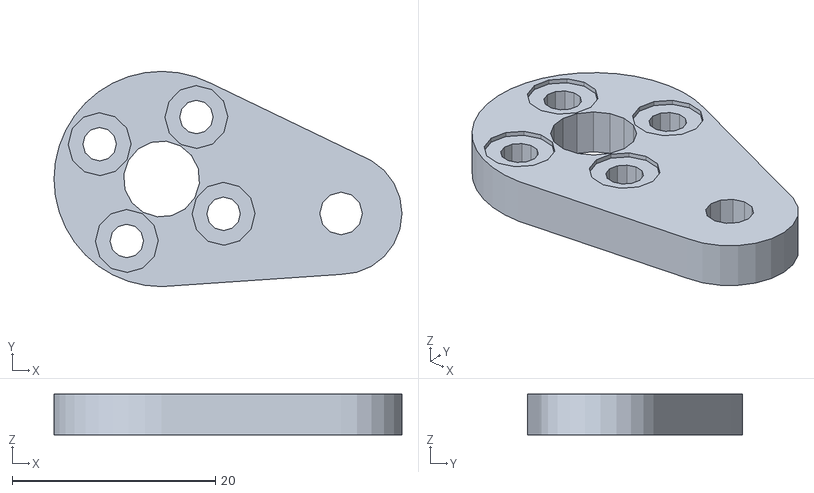
[picture p36: CAD file, 2026-10-25]
prototypes/puppy/print/stl/crank_rear_R.stl
34.3 x 21.2 x 4.00
