ossehaas/Robot-Evolution-Lab/prototypes/puppy/urdf/meshes/head_color1.stl

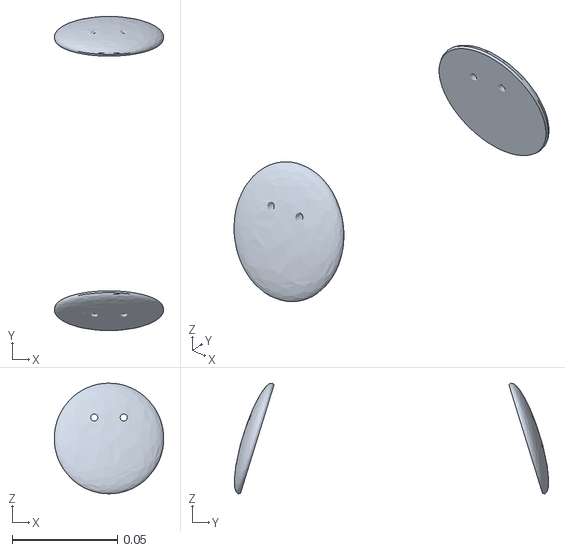
[picture p37: CAD file, 2026-10-25]
prototypes/puppy/urdf/meshes/head_color1.stl
0.052 x 0.149 x 0.0525
