ossehaas/Robot-Evolution-Lab/prototypes/puppy/print/stl/thigh_cover_in_front_R.stl

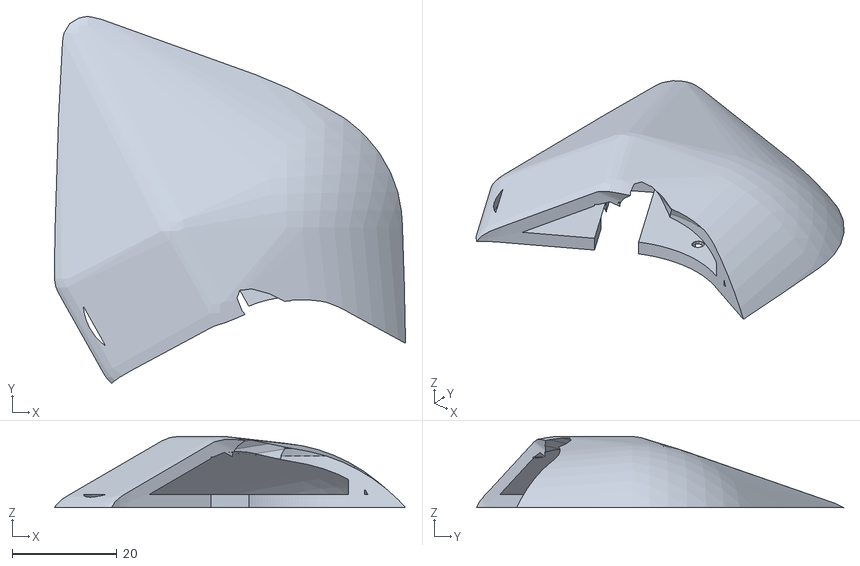
[picture p38: CAD file, 2026-10-25]
prototypes/puppy/print/stl/thigh_cover_in_front_R.stl
67.0 x 70.0 x 13.6
