ossehaas/Robot-Evolution-Lab/prototypes/puppy/print/stl/shin_rear_R.stl

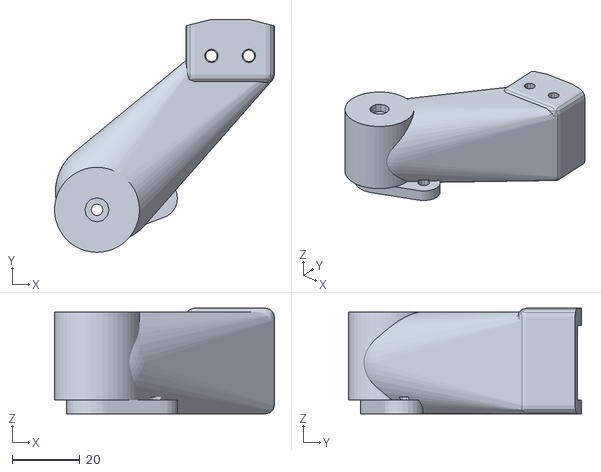
[picture p39: CAD file, 2026-10-25]
prototypes/puppy/print/stl/shin_rear_R.stl
64.7 x 68.4 x 31.1
