ossehaas/Robot-Evolution-Lab/prototypes/puppy/urdf/meshes/head_color6.stl

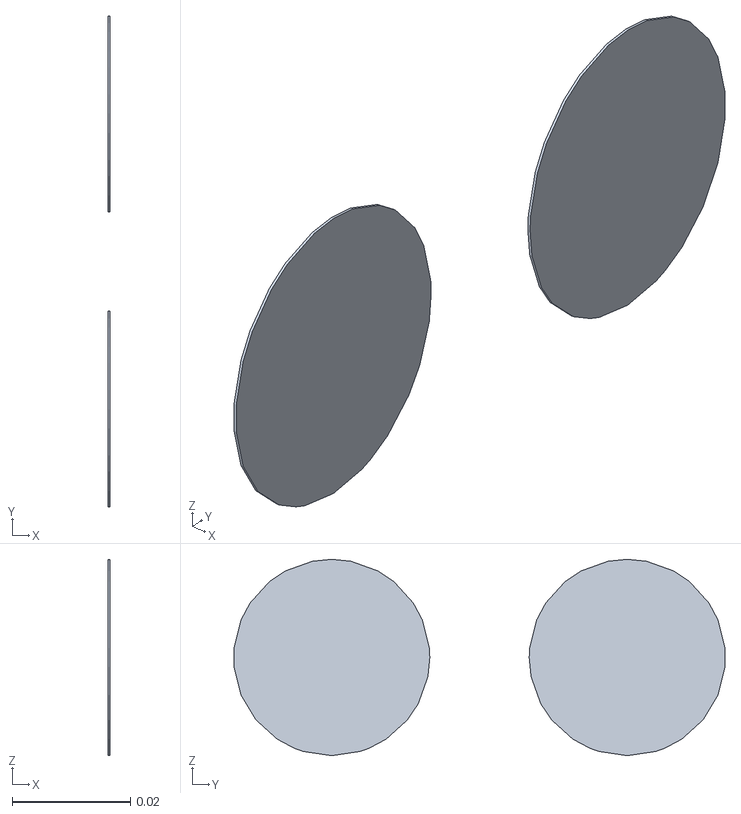
[picture p40: CAD file, 2026-10-25]
prototypes/puppy/urdf/meshes/head_color6.stl
0.0003 x 0.083 x 0.0332
