ossehaas/Robot-Evolution-Lab/prototypes/puppy/print/stl/nose.stl

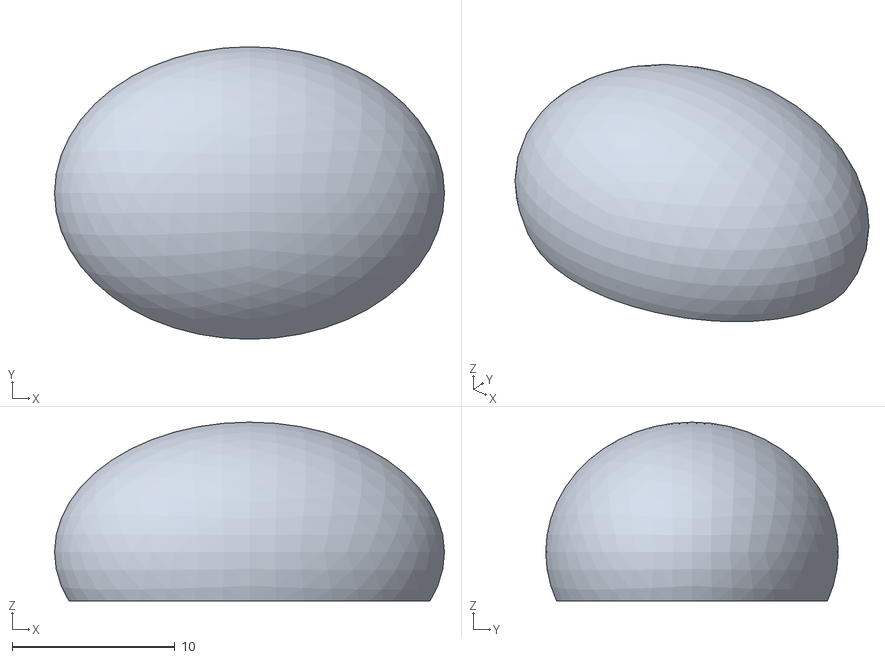
[picture p41: CAD file, 2026-10-25]
prototypes/puppy/print/stl/nose.stl
24.0 x 18.0 x 11.0
