ossehaas/Robot-Evolution-Lab/prototypes/puppy/urdf/meshes/chassis_color1.stl

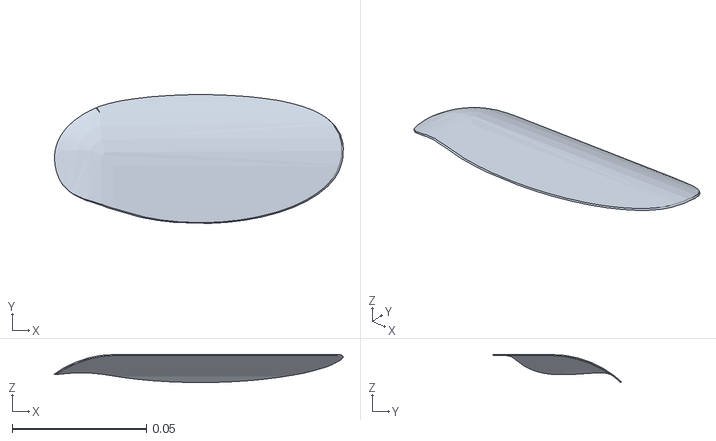
[picture p42: CAD file, 2026-10-25]
prototypes/puppy/urdf/meshes/chassis_color1.stl
0.107 x 0.0479 x 0.0104
