ossehaas/Robot-Evolution-Lab/prototypes/puppy/print/stl/neck_mount.stl

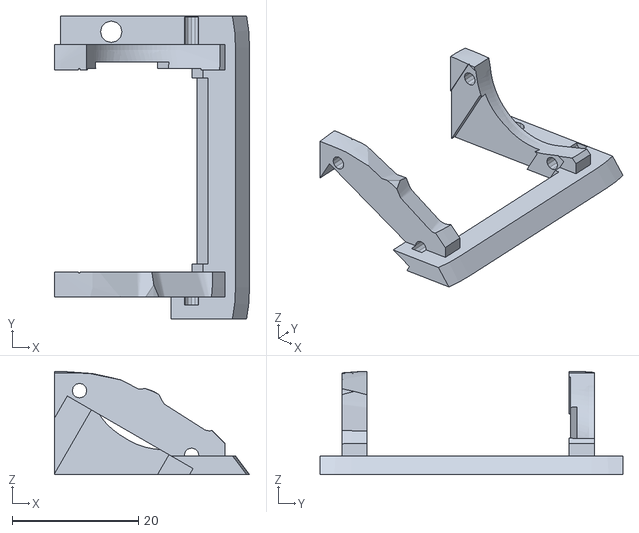
[picture p43: CAD file, 2026-10-25]
prototypes/puppy/print/stl/neck_mount.stl
30.9 x 48.0 x 16.4
