ossehaas/Robot-Evolution-Lab/prototypes/puppy/print/stl/collar.stl

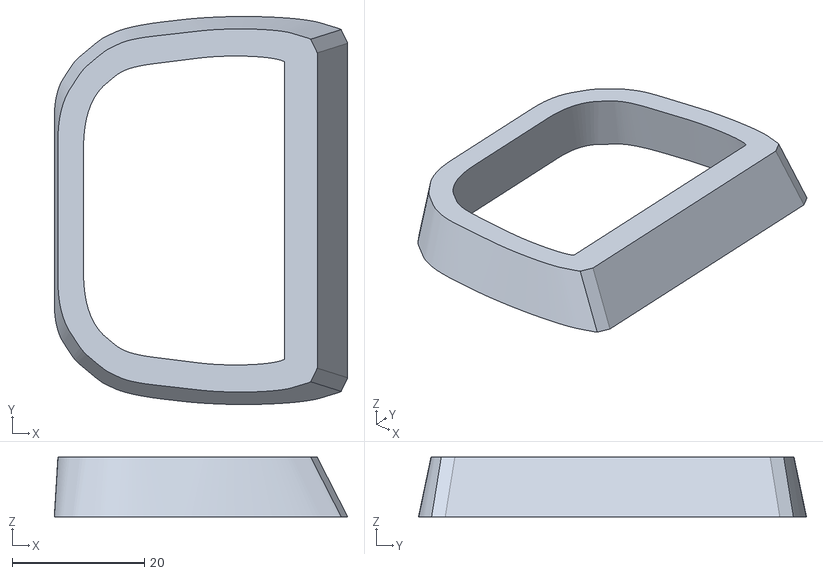
[picture p44: CAD file, 2026-10-25]
prototypes/puppy/print/stl/collar.stl
44.3 x 58.6 x 9.00
