ossehaas/Robot-Evolution-Lab/prototypes/puppy/print/stl/eye_frame.stl

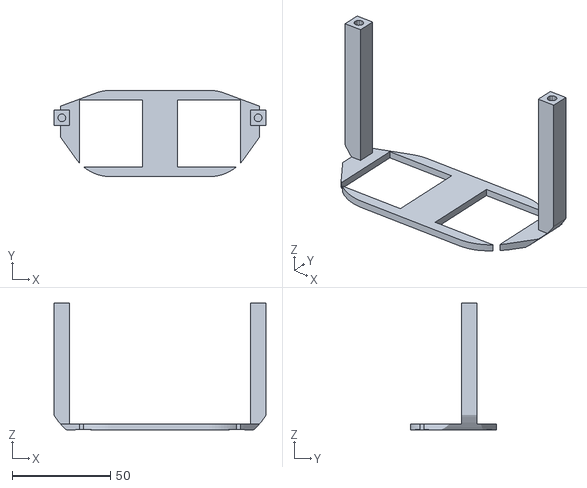
[picture p45: CAD file, 2026-10-25]
prototypes/puppy/print/stl/eye_frame.stl
108.0 x 44.0 x 64.6
