ossehaas/Robot-Evolution-Lab/prototypes/puppy/print/stl/head_mount.stl

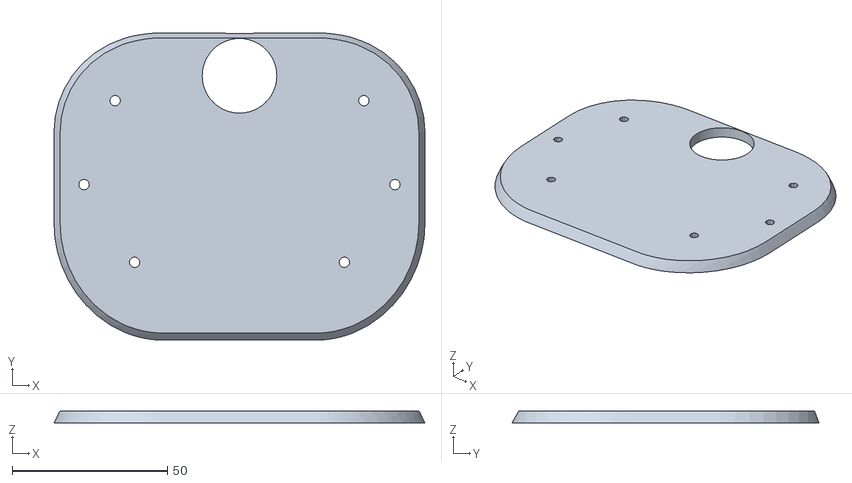
[picture p46: CAD file, 2026-10-25]
prototypes/puppy/print/stl/head_mount.stl
119.3 x 98.8 x 4.00
