ossehaas/Robot-Evolution-Lab/prototypes/puppy/print/stl/bowl.stl

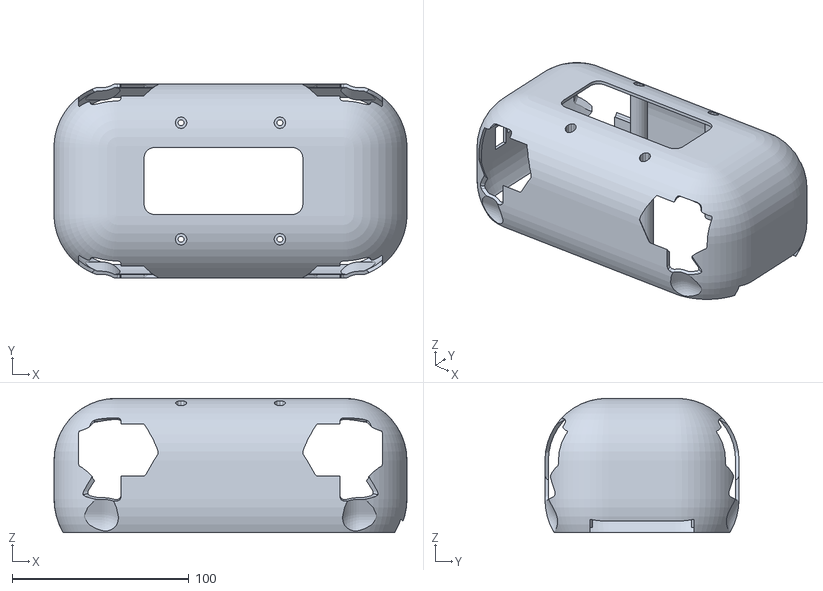
[picture p47: CAD file, 2026-10-25]
prototypes/puppy/print/stl/bowl.stl
200.0 x 110.0 x 76.1
