ossehaas/Robot-Evolution-Lab/prototypes/puppy/print/stl/neck_L.stl

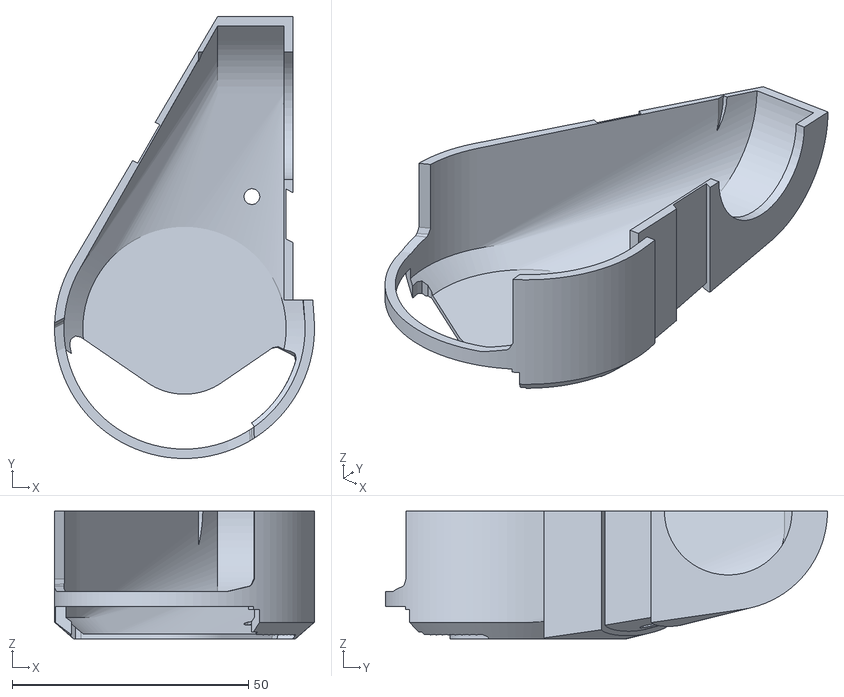
[picture p48: CAD file, 2026-10-25]
prototypes/puppy/print/stl/neck_L.stl
55.0 x 93.5 x 27.0
