ossehaas/Robot-Evolution-Lab/prototypes/puppy/print/stl/neck_yoke.stl

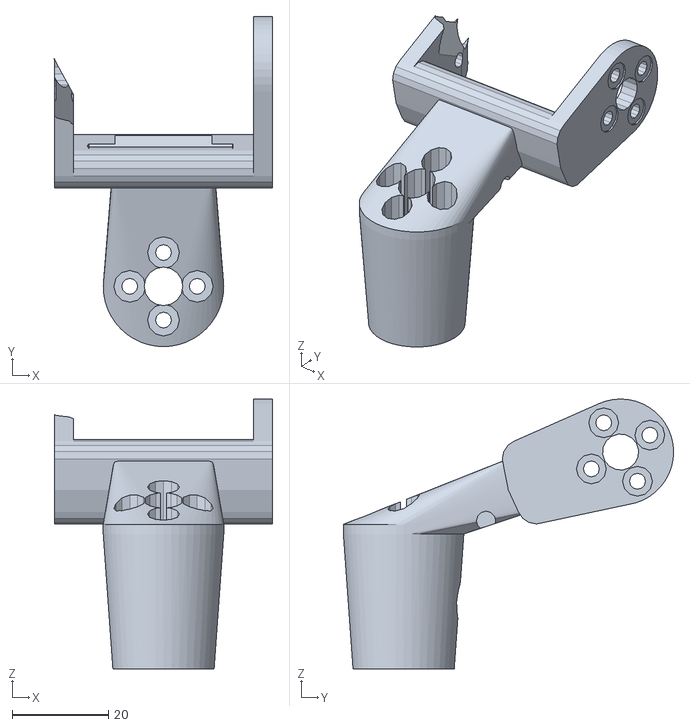
[picture p49: CAD file, 2026-10-25]
prototypes/puppy/print/stl/neck_yoke.stl
45.3 x 68.5 x 56.0
