ossehaas/Robot-Evolution-Lab/prototypes/puppy/print/stl/belly_hatch.stl

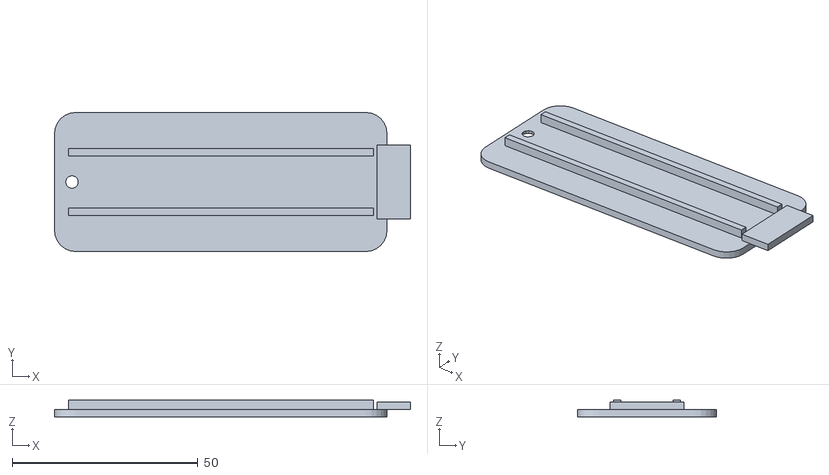
[picture p50: CAD file, 2026-10-25]
prototypes/puppy/print/stl/belly_hatch.stl
95.7 x 37.4 x 4.50
