ossehaas/Robot-Evolution-Lab/prototypes/puppy/print/stl/head_back.stl

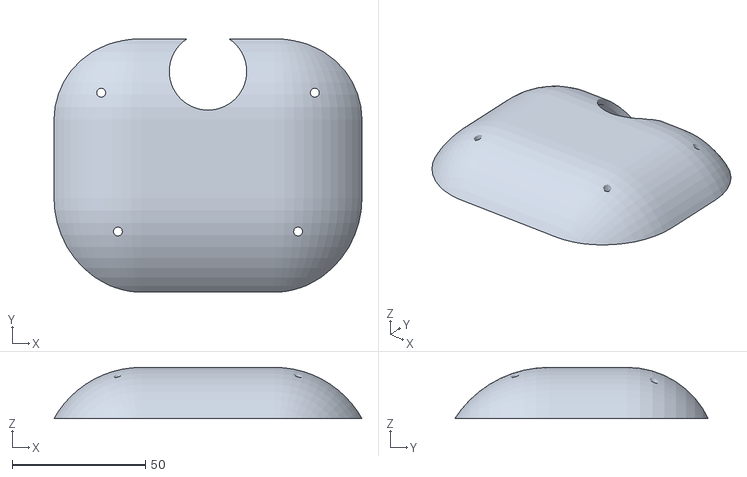
[picture p51: CAD file, 2026-10-25]
prototypes/puppy/print/stl/head_back.stl
115.4 x 95.0 x 19.2
