ossehaas/Robot-Evolution-Lab/prototypes/puppy/print/stl/neck_R.stl

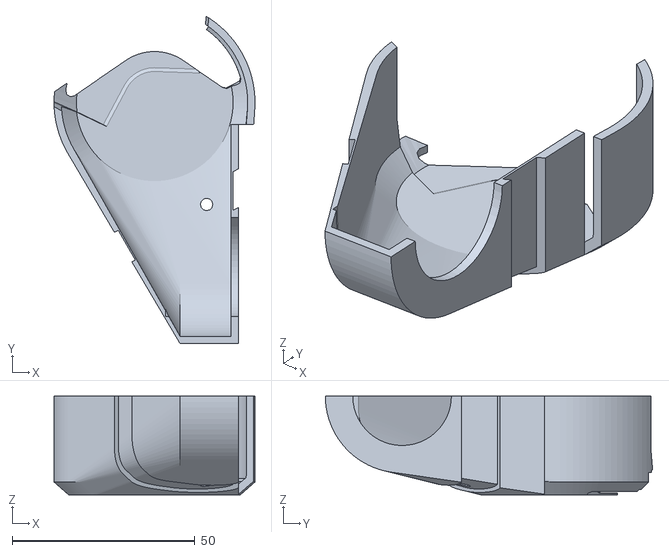
[picture p52: CAD file, 2026-10-25]
prototypes/puppy/print/stl/neck_R.stl
55.0 x 89.6 x 27.0
