ossehaas/Robot-Evolution-Lab/prototypes/puppy/print/stl/tail.stl

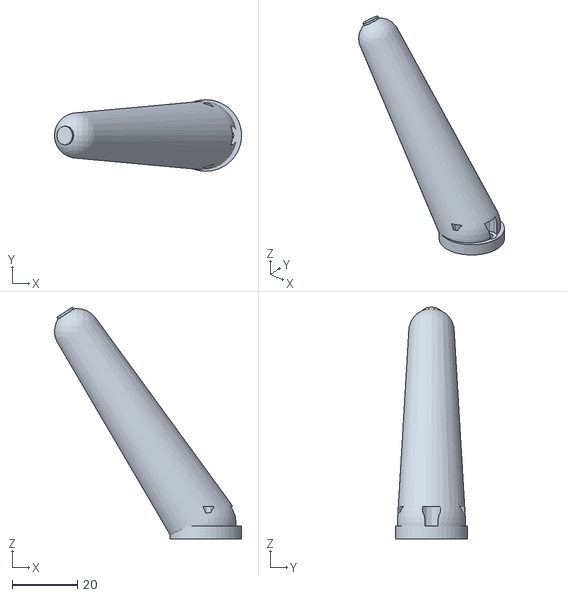
[picture p53: CAD file, 2026-10-25]
prototypes/puppy/print/stl/tail.stl
57.5 x 22.0 x 71.3
