ossehaas/Robot-Evolution-Lab/prototypes/puppy/print/stl/head.stl

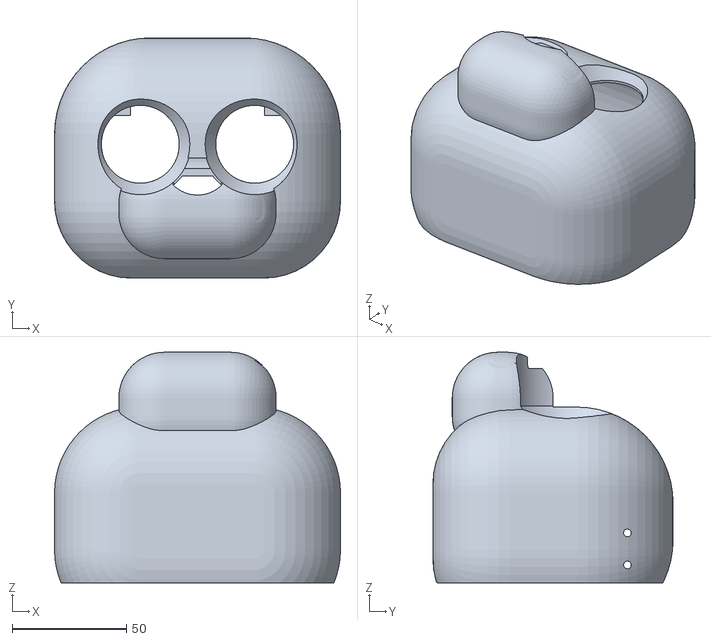
[picture p54: CAD file, 2026-10-25]
prototypes/puppy/print/stl/head.stl
125.0 x 105.0 x 100.8
