ossehaas/Robot-Evolution-Lab/(list of files, cad)

Other CAD files:
prototypes/puppy/print/stl/yoke_rear_L.stl
prototypes/puppy/print/stl/yoke_front_L.stl
prototypes/puppy/urdf/meshes/L0_s1_color0.stl
prototypes/puppy/print/stl/ankle_spring_rear_L.stl
prototypes/puppy/urdf/meshes/L0_s2_color2.stl
prototypes/puppy/print/stl/knee_spacer_front_L.stl
prototypes/puppy/urdf/meshes/R1_s0_color0.stl
prototypes/puppy/urdf/meshes/R0_s0_color0.stl
prototypes/puppy/print/stl/paw_front_R.stl
prototypes/puppy/urdf/meshes/L1_s0_color0.stl
prototypes/puppy/print/stl/knee_spacer_front_R.stl
prototypes/puppy/print/stl/paw_front_L.stl
prototypes/puppy/urdf/meshes/L1_s2_color2.stl
prototypes/puppy/print/stl/ankle_spring_front_L.stl
prototypes/puppy/urdf/meshes/R0_s2_color0.stl
prototypes/puppy/print/stl/thigh_rear_R.stl
prototypes/puppy/urdf/meshes/R1_s1_color0.stl
prototypes/puppy/urdf/meshes/L1_s1_color0.stl
prototypes/puppy/print/stl/sole_front_R.stl
prototypes/puppy/print/stl/knee_spacer_rear_L.stl
prototypes/puppy/urdf/meshes/R0_s3_color2.stl
prototypes/puppy/urdf/meshes/L0_s3_color2.stl
prototypes/puppy/print/stl/thigh_cover_in_rear_R.stl
prototypes/puppy/urdf/meshes/R1_s3_color2.stl
prototypes/puppy/urdf/meshes/L1_s2_color0.stl
prototypes/puppy/print/stl/thigh_cover_out_rear_R.stl
prototypes/puppy/urdf/meshes/R1_s2_color0.stl
prototypes/puppy/print/stl/shin_rear_L.stl
prototypes/puppy/print/stl/thigh_cover_in_front_L.stl
prototypes/puppy/print/stl/paw_rear_R.stl
prototypes/puppy/print/stl/pushrod_rear_R.stl
prototypes/puppy/print/stl/shoulder_front_L.stl
prototypes/puppy/print/stl/crank_front_L.stl
prototypes/puppy/print/stl/sole_rear_R.stl
prototypes/puppy/print/stl/thigh_cover_in_rear_L.stl
prototypes/puppy/print/stl/pushrod_front_L.stl
prototypes/puppy/print/stl/thigh_front_L.stl
prototypes/puppy/print/stl/yoke_front_R.stl
prototypes/puppy/print/stl/ear_R.stl
prototypes/puppy/print/stl/shoulder_front_R.stl
prototypes/puppy/print/stl/crank_rear_L.stl
prototypes/puppy/print/stl/thigh_rear_L.stl
prototypes/puppy/print/stl/shoulder_rear_L.stl
prototypes/puppy/print/stl/thigh_cover_out_rear_L.stl
prototypes/puppy/print/stl/pushrod_rear_L.stl
prototypes/puppy/print/stl/crank_front_R.stl
prototypes/puppy/print/stl/shin_front_R.stl
prototypes/puppy/print/stl/thigh_cover_out_front_R.stl
prototypes/puppy/print/stl/shin_front_L.stl
