ossehaas/Robot-Evolution-Lab/runs/exp2_dog/19_stairs_proof/results.md

# Physically possible, then learned (step 41)

## The proof: is there a slow, statically stable crawl? (tools/dog/stairs_plan.py)

x = a plan exists (proven possible: every pose checked for reach within 95 % of the joint range, collisions, balance >= 1.5 cm inside the support, torque <= 80 %); w = found only by the wider search; F = only with the full joint range and 5 mm swing clearance; . = no plan; - = not tried (a lower rise had no plan)

up:

| rise | tread 25 cm | tread 20 cm | tread 15 cm | tread 12 cm | tread 9 cm |
|---|---|---|---|---|---|
| 1 cm | x | x | x | x | x |
| 2 cm | x | x | x | x | x |
| 3 cm | x | x | x | x | x |
| 4 cm | x | x | x | x | x |
| 5 cm | x | x | w | x | x |
| 6 cm | F | . | . | . | . |
| 7 cm | . | - | - | - | - |

down:

| rise | tread 25 cm | tread 20 cm | tread 15 cm | tread 12 cm | tread 9 cm |
|---|---|---|---|---|---|
| 1 cm | x | x | x | x | x |
| 2 cm | x | x | x | x | x |
| 3 cm | x | x | x | x | x |
| 4 cm | x | x | x | x | . |
| 5 cm | x | x | . | . | - |
| 6 cm | . | . | - | - | - |

## The proof in physics: plan replay, nominal

| plan | climbed | fell | largest height / pitch error | seconds |
|---|---|---|---|---|
| down_r1_t9 | 100 % | 0 % | 1.0 cm / 6.5 deg | 59.8 |
| down_r2_t9 | 100 % | 0 % | 1.0 cm / 8.3 deg | 59.8 |
| down_r3_t9 | 0 % | 100 % | 14.8 cm / 89.1 deg | 55.1 |
| down_r1_t12 | 0 % | 100 % | 3.7 cm / 73.1 deg | 73.7 |
| down_r2_t12 | 0 % | 100 % | 6.7 cm / 78.7 deg | 74.2 |
| down_r3_t12 | 0 % | 100 % | 11.9 cm / 103.5 deg | 69.3 |
| down_r4_t12 | 0 % | 100 % | 8.2 cm / 83.2 deg | 65.0 |
| down_r1_t15 | 0 % | 100 % | 3.9 cm / 79.7 deg | 99.1 |
| down_r2_t15 | 0 % | 100 % | 8.8 cm / 94.9 deg | 82.7 |
| down_r3_t15 | 0 % | 100 % | 14.8 cm / 99.6 deg | 91.7 |
| down_r4_t15 | 100 % | 0 % | 1.1 cm / 15.9 deg | 79.0 |
| down_r1_t20 | 0 % | 100 % | 9.1 cm / 69.2 deg | 115.7 |
| down_r2_t20 | 0 % | 100 % | 7.8 cm / 100.0 deg | 116.0 |
| down_r3_t20 | 0 % | 100 % | 8.2 cm / 84.4 deg | 108.8 |
| down_r4_t20 | 0 % | 100 % | 15.1 cm / 100.0 deg | 109.8 |
| down_r5_t20 | 0 % | 100 % | 21.9 cm / 101.5 deg | 106.5 |
| down_r1_t25 | 0 % | 100 % | 6.0 cm / 81.7 deg | 140.9 |
| down_r2_t25 | 0 % | 100 % | 2.7 cm / 98.3 deg | 141.1 |
| down_r3_t25 | 0 % | 100 % | 10.5 cm / 84.9 deg | 144.6 |
| down_r4_t25 | 0 % | 100 % | 16.9 cm / 104.3 deg | 140.6 |
| down_r5_t25 | 0 % | 100 % | 11.5 cm / 90.0 deg | 137.4 |
| up_r1_t9 | 0 % | 0 % | 3.4 cm / 13.2 deg | 65.2 |
| up_r2_t9 | 0 % | 100 % | 13.6 cm / 86.2 deg | 65.4 |
| up_r3_t9 | 0 % | 100 % | 20.4 cm / 50.0 deg | 68.7 |
| up_r4_t9 | 0 % | 100 % | 25.1 cm / 70.3 deg | 60.7 |
| up_r5_t9 | 0 % | 100 % | 26.6 cm / 70.5 deg | 64.7 |
| up_r1_t12 | 0 % | 100 % | 9.9 cm / 87.9 deg | 73.6 |
| up_r2_t12 | 0 % | 100 % | 16.3 cm / 66.1 deg | 74.0 |
| up_r3_t12 | 0 % | 100 % | 10.0 cm / 74.4 deg | 74.3 |
| up_r4_t12 | 0 % | 100 % | 26.5 cm / 59.0 deg | 77.7 |
| up_r5_t12 | 0 % | 100 % | 31.3 cm / 76.6 deg | 76.7 |
| up_r1_t15 | 0 % | 100 % | 10.2 cm / 78.2 deg | 90.5 |
| up_r2_t15 | 0 % | 100 % | 12.1 cm / 78.8 deg | 90.4 |
| up_r3_t15 | 0 % | 100 % | 13.7 cm / 67.2 deg | 93.6 |
| up_r4_t15 | 0 % | 100 % | 14.9 cm / 74.6 deg | 91.7 |
| up_r5_t15 | 0 % | 100 % | 25.9 cm / 85.7 deg | 90.7 |
| up_r1_t20 | 0 % | 100 % | 6.4 cm / 77.9 deg | 109.9 |
| up_r2_t20 | 0 % | 100 % | 11.1 cm / 74.5 deg | 110.1 |
| up_r3_t20 | 0 % | 100 % | 20.3 cm / 80.8 deg | 110.6 |
| up_r4_t20 | 0 % | 100 % | 26.4 cm / 84.9 deg | 111.4 |
| up_r5_t20 | 0 % | 100 % | 30.9 cm / 77.7 deg | 109.1 |
| up_r1_t25 | 0 % | 100 % | 8.6 cm / 99.9 deg | 140.8 |
| up_r2_t25 | 0 % | 100 % | 10.2 cm / 73.5 deg | 138.5 |
| up_r3_t25 | 0 % | 100 % | 14.6 cm / 76.7 deg | 136.1 |
| up_r4_t25 | 0 % | 100 % | 26.3 cm / 90.0 deg | 142.1 |
| up_r5_t25 | 0 % | 100 % | 30.9 cm / 89.4 deg | 137.1 |

## The proof in physics: plan replay, randomized (4 dogs per plan)

| plan | climbed | fell | largest height / pitch error | seconds |
|---|---|---|---|---|
| down_r1_t9 | 0 % | 100 % | 6.3 cm / 89.9 deg | 59.8 |
| down_r2_t9 | 0 % | 100 % | 9.7 cm / 100.0 deg | 59.8 |
| down_r3_t9 | 25 % | 75 % | 16.5 cm / 105.0 deg | 55.1 |
| down_r1_t12 | 50 % | 50 % | 3.8 cm / 94.9 deg | 73.7 |
| down_r2_t12 | 0 % | 100 % | 10.6 cm / 78.6 deg | 74.2 |
| down_r3_t12 | 0 % | 100 % | 14.6 cm / 98.3 deg | 69.3 |
| down_r4_t12 | 0 % | 100 % | 17.7 cm / 104.9 deg | 65.0 |
| down_r1_t15 | 0 % | 100 % | 7.2 cm / 94.9 deg | 99.1 |
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
| up_r2_t15 | 0 % | 100 % | 15.2 cm / 80.6 deg | 90.4 |
| up_r3_t15 | 0 % | 100 % | 20.2 cm / 79.8 deg | 93.6 |
| up_r4_t15 | 0 % | 100 % | 26.5 cm / 77.5 deg | 91.7 |
| up_r5_t15 | 0 % | 100 % | 31.3 cm / 78.4 deg | 90.7 |
| up_r1_t20 | 0 % | 100 % | 9.4 cm / 77.4 deg | 109.9 |
| up_r2_t20 | 0 % | 100 % | 14.4 cm / 74.6 deg | 110.1 |
| up_r3_t20 | 0 % | 100 % | 20.3 cm / 83.1 deg | 110.6 |
| up_r4_t20 | 0 % | 100 % | 26.4 cm / 87.0 deg | 111.4 |
| up_r5_t20 | 0 % | 100 % | 30.6 cm / 63.2 deg | 109.1 |
| up_r1_t25 | 0 % | 100 % | 7.9 cm / 66.3 deg | 140.8 |
| up_r2_t25 | 0 % | 100 % | 15.0 cm / 93.5 deg | 138.5 |
| up_r3_t25 | 0 % | 100 % | 19.4 cm / 53.4 deg | 136.1 |
| up_r4_t25 | 0 % | 100 % | 26.3 cm / 90.0 deg | 142.1 |
| up_r5_t25 | 0 % | 100 % | 30.9 cm / 92.2 deg | 137.1 |

## What the dogs do: stairs goal test (clean = reached without any fall, 40 runs per cell)

Limits: highest rise [cm] up to which every rise is done clean by >= 90 %; mean clean share over all cells.

| dog | up, treads 25 / 20 / 15 / 12 / 9 | down, treads 25 / 20 / 15 / 12 / 9 | mean clean |
|---|---|---|---|
| bc_s2 | 2 / 2 / 2 / 3 / 2 | 2 / 2 / 2 / 1 / 1 | 0.292 |
| free_s2 | 5 / 4 / 4 / 3 / 2 | 3 / 3 / 2 / 1 / 1 | 0.378 |
| cont_s1 | 5 / 4 / 4 / 3 / 2 | 3 / 2 / 2 / 1 / 1 | 0.373 |
| rsi_s1 | 5 / 3 / 4 / 3 / 3 | 2 / 2 / 2 / 1 / 1 | 0.366 |
| rsi_s2 | 4 / 4 / 4 / 4 / 3 | 2 / 2 / 2 / 1 / 1 | 0.370 |
| rsi_terms_s1 | 4 / 2 / 3 / 3 / 2 | 2 / 2 / 2 / 1 / 1 | 0.328 |
| rsi_terms_s2 | 4 / 4 / 4 / 3 / 2 | 3 / 2 / 2 / 1 / 1 | 0.327 |

Clean share where a plan exists (physically possible) vs where none was found:

| dog | up, possible | up, no plan | down, possible | down, no plan |
|---|---|---|---|---|
| bc_s2 | 76 % (25) | 0 % (25) | 49 % (21) | 0 % (29) |
| free_s2 | 84 % (25) | 4 % (25) | 73 % (21) | 2 % (29) |
| cont_s1 | 85 % (25) | 3 % (25) | 70 % (21) | 2 % (29) |
| rsi_s1 | 85 % (25) | 3 % (25) | 67 % (21) | 2 % (29) |
| rsi_s2 | 85 % (25) | 5 % (25) | 67 % (21) | 1 % (29) |
| rsi_terms_s1 | 80 % (25) | 3 % (25) | 56 % (21) | 1 % (29) |
| rsi_terms_s2 | 82 % (25) | 3 % (25) | 54 % (21) | 0 % (29) |

Per cell, clean % (up / down), for the possible cells:

up:

| dog | r1 t9 | r2 t9 | r3 t9 | r4 t9 | r5 t9 | r1 t12 | r2 t12 | r3 t12 | r4 t12 | r5 t12 | r1 t15 | r2 t15 | r3 t15 | r4 t15 | r5 t15 | r1 t20 | r2 t20 | r3 t20 | r4 t20 | r5 t20 | r1 t25 | r2 t25 | r3 t25 | r4 t25 | r5 t25 |
|---|---|---|---|---|---|---|---|---|---|---|---|---|---|---|---|---|---|---|---|---|---|---|---|---|---|
| bc_s2 | 100 | 100 | 68 | 22 | 0 | 100 | 98 | 95 | 60 | 5 | 100 | 98 | 88 | 75 | 57 | 100 | 100 | 82 | 60 | 62 | 100 | 100 | 78 | 72 | 68 |
| free_s2 | 100 | 100 | 85 | 5 | 0 | 100 | 100 | 100 | 80 | 0 | 100 | 100 | 100 | 98 | 68 | 100 | 100 | 100 | 100 | 78 | 100 | 100 | 100 | 98 | 98 |
| cont_s1 | 100 | 100 | 90 | 2 | 0 | 100 | 100 | 100 | 80 | 0 | 100 | 100 | 100 | 100 | 72 | 100 | 100 | 100 | 100 | 80 | 100 | 100 | 98 | 98 | 100 |
| rsi_s1 | 100 | 100 | 95 | 0 | 0 | 100 | 100 | 100 | 90 | 0 | 100 | 100 | 100 | 100 | 65 | 100 | 100 | 100 | 90 | 90 | 100 | 100 | 100 | 100 | 98 |
| rsi_s2 | 100 | 100 | 95 | 8 | 0 | 100 | 100 | 98 | 98 | 0 | 100 | 100 | 100 | 98 | 60 | 100 | 100 | 100 | 95 | 88 | 100 | 100 | 100 | 100 | 90 |
| rsi_terms_s1 | 100 | 100 | 88 | 0 | 0 | 100 | 100 | 95 | 70 | 0 | 100 | 100 | 100 | 85 | 52 | 100 | 100 | 88 | 85 | 72 | 100 | 100 | 95 | 92 | 90 |
| rsi_terms_s2 | 100 | 100 | 88 | 2 | 0 | 100 | 100 | 92 | 75 | 2 | 100 | 100 | 92 | 92 | 55 | 100 | 100 | 100 | 98 | 72 | 100 | 100 | 100 | 100 | 75 |

down:

| dog | r1 t9 | r2 t9 | r3 t9 | r1 t12 | r2 t12 | r3 t12 | r4 t12 | r1 t15 | r2 t15 | r3 t15 | r4 t15 | r1 t20 | r2 t20 | r3 t20 | r4 t20 | r5 t20 | r1 t25 | r2 t25 | r3 t25 | r4 t25 | r5 t25 |
|---|---|---|---|---|---|---|---|---|---|---|---|---|---|---|---|---|---|---|---|---|---|
| bc_s2 | 100 | 5 | 0 | 100 | 38 | 2 | 0 | 100 | 95 | 12 | 0 | 100 | 100 | 38 | 12 | 0 | 100 | 100 | 88 | 28 | 10 |
| free_s2 | 100 | 38 | 18 | 100 | 82 | 52 | 8 | 100 | 100 | 70 | 40 | 100 | 98 | 92 | 52 | 35 | 100 | 100 | 98 | 75 | 75 |
| cont_s1 | 100 | 45 | 20 | 100 | 82 | 38 | 10 | 100 | 100 | 38 | 35 | 100 | 100 | 80 | 65 | 30 | 100 | 100 | 98 | 70 | 68 |
| rsi_s1 | 100 | 22 | 8 | 100 | 88 | 35 | 2 | 100 | 100 | 40 | 28 | 100 | 100 | 85 | 57 | 18 | 100 | 100 | 90 | 68 | 60 |
| rsi_s2 | 100 | 45 | 18 | 100 | 57 | 40 | 5 | 100 | 92 | 55 | 30 | 100 | 100 | 70 | 60 | 15 | 100 | 100 | 90 | 78 | 55 |
| rsi_terms_s1 | 100 | 10 | 5 | 100 | 60 | 5 | 0 | 100 | 98 | 20 | 5 | 100 | 98 | 60 | 28 | 8 | 100 | 100 | 90 | 55 | 40 |
| rsi_terms_s2 | 100 | 18 | 0 | 100 | 57 | 10 | 5 | 100 | 98 | 12 | 0 | 100 | 100 | 70 | 15 | 0 | 100 | 100 | 92 | 40 | 22 |

## Nothing forgotten? Walking (falls, walk score), shoves, getting up

| dog | forward | course | stairs straight | power |
|---|---|---|---|---|
| free_s2 | 1.0 % (0.46) | 0.7 % (0.43) | 1.8 % (0.45) | 12.9 W |
| cont_s1 | 1.3 % (0.45) | 1.0 % (0.44) | 1.6 % (0.44) | 12.7 W |
| rsi_s1 | 0.9 % (0.45) | 0.6 % (0.43) | 2.5 % (0.44) | 12.8 W |
| rsi_s2 | 1.0 % (0.44) | 0.6 % (0.43) | 1.7 % (0.44) | 12.6 W |
| rsi_terms_s1 | 0.4 % (0.45) | 0.3 % (0.43) | 1.6 % (0.44) | 12.6 W |
| rsi_terms_s2 | 1.1 % (0.45) | 0.6 % (0.43) | 1.3 % (0.44) | 12.8 W |

One shove while walking (stays up / gets up / stays down):

| dog | 0.3 m/s | 0.5 m/s | 0.7 m/s | 0.9 m/s | 1.1 m/s | 1.3 m/s | 1.5 m/s |
|---|---|---|---|---|---|---|---|
| free_s2 | 99 / 1 / 0 % | 77 / 23 / 0 % | 69 / 31 / 0 % | 64 / 36 / 0 % | 39 / 61 / 0 % | 20 / 80 / 0 % | 2 / 97 / 1 % |
| cont_s1 | 99 / 1 / 0 % | 83 / 17 / 0 % | 76 / 24 / 0 % | 57 / 42 / 0 % | 42 / 58 / 0 % | 13 / 83 / 4 % | 0 / 94 / 6 % |
| rsi_s1 | 99 / 1 / 0 % | 82 / 18 / 0 % | 66 / 34 / 0 % | 52 / 48 / 0 % | 37 / 62 / 1 % | 10 / 84 / 6 % | 0 / 93 / 7 % |
| rsi_s2 | 100 / 0 / 0 % | 82 / 18 / 0 % | 70 / 30 / 0 % | 64 / 36 / 0 % | 34 / 66 / 0 % | 7 / 93 / 0 % | 0 / 94 / 6 % |
| rsi_terms_s1 | 99 / 1 / 0 % | 73 / 27 / 0 % | 62 / 38 / 0 % | 53 / 47 / 0 % | 34 / 62 / 3 % | 4 / 90 / 6 % | 0 / 92 / 8 % |
| rsi_terms_s2 | 99 / 1 / 0 % | 69 / 31 / 0 % | 60 / 40 / 0 % | 67 / 33 / 0 % | 36 / 64 / 0 % | 10 / 88 / 1 % | 0 / 92 / 8 % |

Getting up within 8 s:

| dog | standing | dropped upright | on its side | on its back |
|---|---|---|---|---|
| free_s2 | 100 % | 100 % | 100 % | 100 % |
| cont_s1 | 100 % | 100 % | 100 % | 100 % |
| rsi_s1 | 100 % | 100 % | 100 % | 100 % |
| rsi_s2 | 100 % | 100 % | 100 % | 100 % |
| rsi_terms_s1 | 100 % | 100 % | 100 % | 100 % |
| rsi_terms_s2 | 100 % | 100 % | 100 % | 100 % |

Best per variant (mean clean share): {"rsi": ["rsi_s2", 0.37], "rsi_terms": ["rsi_terms_s1", 0.328], "cont": ["cont_s1", 0.373], "start free_s2": 0.378}

Videos: `videos/compare_down_r3_t9.mp4`, `videos/compare_down_r4_t15.mp4`, `videos/compare_up_r5_t15.mp4`, `videos/compare_up_r5_t9.mp4`, `videos/replay_down_r4_t15.mp4`, `videos/replay_up_r3_t15.mp4`, `videos/replay_up_r4_t9.mp4`, `videos/replay_up_r5_t15.mp4`
