ossehaas/Robot-Evolution-Lab/runs/exp2_dog/28_part_tests/paw_geometry.md

Paw geometry, runs\exp2_dog\26_ring_base\genome_ring.json: 2.45 kg, sole 10.0 N/mm, ankle 1.5 N*m/rad, limit 23 deg; a trotting paw carries 12.0 N

Tilt [deg] where the housing touches the floor, at sole compression 0 / 0.6 / 1.2 / 1.8 mm (- = the base is already down):

| variant | toe down | heel down | side | arm strain at 18 N | at the stop |
|---|---|---|---|---|---|
| now (P 1.5) | 4.8 / 2.9 / 1.0 / - | 5.8 / 3.5 / 1.1 / - | 6.1 / 3.6 / 1.2 / - | 14% | 12% (15 N) |
| P 3 | 10.1 / 7.9 / 5.8 / 3.9 | 12.6 / 9.7 / 7.1 / 4.6 | 13.1 / 10.2 / 7.4 / 4.8 | 14% | 23% (30 N) |
| P 4.5 | 15.8 / 13.4 / 11.2 / 9.0 | 20.1 / 17.1 / 14.0 / 11.2 | 21.0 / 17.9 / 14.7 / 11.6 | 14% | 35% (45 N) |
| bevel | 6.9 / 4.0 / 1.3 / - | 6.9 / 4.0 / 1.3 / - | 6.9 / 4.0 / 1.3 / - | 14% | 12% (15 N) |
| P 3 + bevel | 15.4 / 11.8 / 8.5 / 5.4 | 15.4 / 11.8 / 8.5 / 5.4 | 15.4 / 11.8 / 8.5 / 5.4 | 14% | 23% (30 N) |
| P 4.5 + bevel | 24.7 / 21.1 / 17.3 / 13.5 | 24.7 / 21.1 / 17.3 / 13.5 | 24.7 / 21.1 / 17.3 / 13.5 | 14% | 35% (45 N) |
| simulator's colliders, now | 5.1 / 3.1 / 1.0 / - | 6.2 / 3.7 / 1.3 / - | 6.4 / 3.9 / 1.3 / - | 14% | 12% (15 N) |

Shin rotation [deg, + = toe up] with the paw dx mm ahead of its rest place, body level:

| leg | -60 | -40 | -20 | 20 | 40 | 60 |
|---|---|---|---|---|---|---|
| front | -30.4 | -18.2 | -8.3 | 6.5 | 10.9 | 12.2 |
| rear | -30.4 | -18.2 | -8.3 | 6.5 | 10.9 | 12.2 |

Share of a trotting paw's load on the base edge (static estimate, sole at 1.2 mm), front leg:

| variant | -60 | -40 | -20 | 20 | 40 | 60 |
|---|---|---|---|---|---|---|
| now (P 1.5) | 100% | 100% | 85% | 75% | 100% | 100% |
| P 3 | 100% | 100% | 29% | 0% | 53% | 71% |
| P 4.5 | 100% | 82% | 0% | 0% | 0% | 0% |
| bevel | 100% | 100% | 82% | 72% | 100% | 100% |
| P 3 + bevel | 100% | 100% | 0% | 0% | 33% | 51% |
| P 4.5 + bevel | 100% | 10% | 0% | 0% | 0% | 0% |
| simulator's colliders, now | 100% | 100% | 85% | 72% | 100% | 100% |
