ossehaas/Robot-Evolution-Lab/runs/exp2_dog/28_part_tests/stand.md

Stance (the shin sweeps +11 -> -18 deg under load), at 6 / 12 / 18 N: work through the ankle [mJ], ankle vault [mm], share of the normal force on the housing, x travel [mm]

| design | work | vault | on the housing | x |
|---|---|---|---|---|
| old ball | 9 / 17 / 28 | 0.7 / 0.9 / 1.0 | 0% / 0% / 0% | 18 / 19 / 21 |
| now | 23 / 38 / 53 | 1.8 / 1.4 / 1.2 | 62% / 54% / 48% | 11 / 7 / 5 |
| P 3 | 16 / 23 / 27 | 0.7 / 0.9 / 1.1 | 28% / 29% / 30% | 14 / 12 / 11 |
| P 4.5 | 12 / 23 / 29 | 0.7 / 0.8 / 0.8 | 9% / 11% / 15% | 17 / 17 / 16 |
| P 3 + bevel | 11 / 16 / 17 | 0.5 / 0.6 / 0.9 | 17% / 25% / 30% | 17 / 15 / 14 |
| P 4.5 + bevel | 13 / 27 / 34 | 1.2 / 1.0 / 0.7 | 0% / 5% / 12% | 18 / 21 / 20 |

Pulled over the floor at 12 N, shin tilt -20 / -10 / 0 / 10 / 20 deg: peak pull (force / load), friction while sliding, share on the housing

| design | peak pull | friction | on the housing |
|---|---|---|---|
| old ball | 0.97 / 0.96 / 0.97 / 0.97 / 1.00 | 0.85 / 0.85 / 0.85 / 0.85 / 0.85 | 0% / 0% / 0% / 0% / 0% |
| now | 1.00 / 1.70 / 1.46 / 0.87 / 0.96 | 0.86 / 0.83 / 0.85 / 0.85 / 0.85 | 12% / 51% / 100% / 100% / 100% |
| P 3 | 1.01 / 1.07 / 0.90 / 0.87 / 0.93 | 0.85 / 0.85 / 0.85 / 0.85 / 0.85 | 0% / 14% / 91% / 100% / 100% |
| P 4.5 | 0.96 / 1.01 / 0.93 / 0.91 / 0.92 | 0.85 / 0.85 / 0.85 / 0.85 / 0.85 | 0% / 0% / 49% / 100% / 100% |
| P 3 + bevel | 0.96 / 0.97 / 1.03 / 1.77 / 2.22 | 0.85 / 0.85 / 0.85 / 0.85 / 1.08 | 0% / 8% / 100% / 100% / 100% |
| P 4.5 + bevel | 0.97 / 1.01 / 0.92 / 1.00 / 2.28 | 0.85 / 0.85 / 0.85 / 0.85 / 1.11 | 0% / 0% / 44% / 100% / 100% |

Peak pull at shin tilt 0, load 6 / 12 / 18 N (above the friction: the paw tips and its edge digs in):

| design | peak pull |
|---|---|
| old ball | 1.05 / 0.97 / 0.95 |
| now | 2.10 / 1.46 / 0.86 |
| P 3 | 1.03 / 0.90 / 0.91 |
| P 4.5 | 1.03 / 0.93 / 0.89 |
| P 3 + bevel | 1.03 / 1.03 / 0.89 |
| P 4.5 + bevel | 1.03 / 0.92 / 0.94 |

Step edge (4 cm riser, 18 cases: 5 / 15 / 30 mm below the edge, shin -10 / 0 / 10 deg, pushed with 6 / 12 N, lift at most 30 N):

| design | got over | lift per N of push: mean over the climb, median case | peak, median case | peak, worst case | not over |
|---|---|---|---|---|---|
| old ball | 18 of 18 | 0.15 | 0.54 | 1.06 | - |
| now | 18 of 18 | 0.29 | 1.08 | 1.30 | - |
| P 3 | 18 of 18 | 0.30 | 1.06 | 1.21 | - |
| P 4.5 | 18 of 18 | 0.31 | 1.04 | 1.17 | - |
| P 3 + bevel | 18 of 18 | 0.29 | 1.15 | 1.36 | - |
| P 4.5 + bevel | 18 of 18 | 0.26 | 1.13 | 1.38 | - |

The same climb in two phases, sole 30 mm below the edge, shin 0, pushed with 6 / 12 N: lift per N of push while the paw is against the vertical face (sole 4-10 mm above its start), and the peak over the last 6 mm (what passes the edge last)

| design | against the face | last 6 mm |
|---|---|---|
| old ball | 0.91 / 0.90 | -0.01 / -0.02 |
| now | 0.40 / 0.39 | 1.06 / 1.13 |
| P 3 | 0.40 / 0.39 | 1.06 / 1.03 |
| P 4.5 | 0.40 / 0.39 | 1.08 / 1.08 |
| P 3 + bevel | 0.40 / 0.39 | 1.25 / 1.19 |
| P 4.5 + bevel | 0.40 / 0.39 | 1.27 / 1.29 |

Drop 3 / 6 cm with 0.6 kg: peak force over 15 ms [N], peak on the housing, lowest point of the z slider (0 = sole just touching) [mm], rebound [mm]

| design | peak | on the housing | lowest | rebound |
|---|---|---|---|---|
| old ball | 40 / 46 | 0 / 0 | -2.5 / -1.8 | 2.0 / 1.3 |
| now | 39 / 49 | 46 / 16 | -1.5 / -1.5 | 0.9 / 0.9 |
| P 3 | 40 / 46 | 0 / 0 | -2.5 / -1.8 | 2.0 / 1.3 |
| P 4.5 | 40 / 46 | 0 / 0 | -2.5 / -1.8 | 2.0 / 1.3 |
| P 3 + bevel | 40 / 46 | 0 / 0 | -2.5 / -1.8 | 2.0 / 1.3 |
| P 4.5 + bevel | 40 / 46 | 0 / 0 | -2.5 / -1.8 | 2.0 / 1.3 |
