ossehaas/Robot-Evolution-Lab/runs/exp2_dog/28_part_tests/smoke/stand.md

Stance (the shin sweeps +11 -> -18 deg under load), at 6 / 12 / 18 N: work through the ankle [mJ], ankle vault [mm], share of the normal force on the housing, x travel [mm]

| design | work | vault | on the housing | x |
|---|---|---|---|---|
| now | 23 / 38 / 53 | 1.8 / 1.4 / 1.2 | 62% / 54% / 48% | 11 / 7 / 5 |

Pulled over the floor at 12 N, shin tilt -20 / -10 / 0 / 10 / 20 deg: grip (peak force / load), friction while sliding, share on the housing

| design | grip | friction | on the housing |
|---|---|---|---|
| now | 1.00 / 1.70 / 1.46 / 0.87 / 0.96 | 0.86 / 0.83 / 0.85 / 0.85 / 0.85 | 12% / 51% / 100% / 100% / 100% |

Grip at shin tilt 0, load 6 / 12 / 18 N:

| design | grip |
|---|---|
| now | 2.10 / 1.46 / 0.86 |

Step edge (4 cm riser, 18 cases: 5 / 15 / 30 mm below the edge, shin -10 / 0 / 10 deg, pushed with 6 / 12 N, lift at most 30 N):

| design | got over | lift force per N of push, median | worst | not over |
|---|---|---|---|---|
| now | 18 of 18 | 1.08 | 1.30 | - |

Drop 3 / 6 cm with 0.6 kg: peak force over 15 ms [N], peak on the housing, lowest point of the z slider (0 = sole just touching) [mm], rebound [mm]

| design | peak | on the housing | lowest | rebound |
|---|---|---|---|---|
| now | 39 / 49 | 46 / 16 | -1.5 / -1.5 | 0.9 / 0.9 |
