ossehaas/Robot-Evolution-Lab/runs/exp2_dog/20_balance_and_style/results.md

# Balance first, then the descent (step 42)

## Why the dogs refuse to go down (reward terms per second, per phase of the first descent)

free_s2: reached the bottom r2 t25 100 %, r3 t9 0 %, r3 t12 35 %, r4 t12 3 %, r4 t15 23 %

| term | landing | edge | stairs | refusing |
|---|---|---|---|---|
| track_lin | +3.60 | +2.03 | +2.28 | +0.20 |
| track_ang | +1.04 | +0.72 | +1.04 | +0.70 |
| progress | +0.70 | +0.38 | +1.35 | +0.01 |
| stand_still | -0.12 | +0.00 | +0.00 | +0.00 |
| upright | -0.02 | -0.05 | -0.13 | -0.02 |
| trot | +2.97 | +3.00 | +3.00 | +3.00 |
| leg_clash | -0.00 | -0.01 | -0.01 | -0.04 |
| energy | -0.15 | -0.15 | -0.16 | -0.17 |
| roll_pitch_rate | -0.04 | -0.04 | -0.07 | -0.02 |
| base_height | +0.22 | +0.22 | +0.17 | +0.22 |
| abduction_pose | -0.09 | -0.08 | -0.13 | -0.05 |
| feet_air_time | +0.24 | +0.24 | +0.02 | +0.25 |
| vertical | -0.01 | -0.01 | -0.01 | -0.01 |
| foot_clearance | +1.03 | +1.03 | +0.92 | +0.98 |
| action_rate | -0.07 | -0.07 | -0.10 | -0.09 |
| joint_limit | +0.00 | +0.00 | -0.00 | +0.00 |
| action_limit | +0.00 | +0.00 | -0.00 | +0.00 |
| gu_upright | +0.00 | +0.00 | +0.00 | +0.00 |
| gu_height | +0.00 | +0.00 | +0.00 | +0.00 |
| gu_rise | +0.00 | +0.00 | -0.00 | +0.00 |
| fall | +0.00 | +0.00 | -0.01 | +0.00 |
| sg_goal | +0.00 | +0.00 | +0.00 | +0.00 |
| sg_hard | +0.00 | +0.00 | +0.00 | +0.00 |
| undesired_contact | +0.00 | +0.00 | -0.00 | +0.00 |
| flight | +0.00 | -0.00 | -0.00 | +0.00 |
| seconds | 1451.1 | 2635.2 | 858.2 | 82.7 |

rsi_s2: reached the bottom r2 t25 100 %, r3 t9 2 %, r3 t12 20 %, r4 t12 5 %, r4 t15 18 %

| term | landing | edge | stairs | refusing |
|---|---|---|---|---|
| track_lin | +3.73 | +2.33 | +2.32 | +0.33 |
| progress | +0.66 | +0.35 | +1.33 | +0.02 |
| track_ang | +0.93 | +0.66 | +1.03 | +0.71 |
| stand_still | -0.10 | +0.00 | +0.00 | +0.00 |
| feet_air_time | +0.29 | +0.23 | -0.04 | +0.35 |
| upright | -0.02 | -0.06 | -0.14 | -0.02 |
| trot | +2.97 | +3.00 | +3.00 | +3.00 |
| foot_clearance | +1.06 | +1.05 | +0.93 | +0.98 |
| energy | -0.14 | -0.15 | -0.16 | -0.18 |
| roll_pitch_rate | -0.04 | -0.04 | -0.07 | -0.03 |
| vertical | -0.01 | -0.01 | -0.01 | -0.01 |
| abduction_pose | -0.08 | -0.08 | -0.10 | -0.06 |
| fall | -0.00 | +0.00 | -0.01 | +0.00 |
| action_rate | -0.07 | -0.07 | -0.10 | -0.10 |
| joint_limit | -0.00 | +0.00 | -0.00 | +0.00 |
| action_limit | +0.00 | +0.00 | -0.00 | +0.00 |
| gu_upright | +0.00 | +0.00 | +0.00 | +0.00 |
| gu_height | +0.00 | +0.00 | +0.00 | +0.00 |
| gu_rise | -0.00 | +0.00 | -0.00 | +0.00 |
| sg_goal | +0.00 | +0.00 | +0.00 | +0.00 |
| sg_hard | +0.00 | +0.00 | +0.00 | +0.00 |
| base_height | +0.22 | +0.22 | +0.17 | +0.22 |
| undesired_contact | +0.00 | +0.00 | -0.00 | +0.00 |
| leg_clash | -0.00 | -0.00 | -0.01 | -0.01 |
| flight | +0.00 | -0.00 | -0.00 | +0.00 |
| seconds | 1616.9 | 2567.8 | 869.7 | 75.7 |

cont_s1: reached the bottom r2 t25 100 %, r3 t9 3 %, r3 t12 30 %, r4 t12 3 %, r4 t15 18 %

| term | landing | edge | stairs | refusing |
|---|---|---|---|---|
| track_lin | +3.75 | +2.38 | +2.22 | +0.41 |
| progress | +0.89 | +0.31 | +1.46 | +0.01 |
| track_ang | +0.96 | +0.67 | +1.14 | +0.73 |
| stand_still | -0.14 | +0.00 | -0.00 | +0.00 |
| foot_clearance | +1.04 | +1.10 | +0.94 | +0.98 |
| upright | -0.02 | -0.06 | -0.13 | -0.02 |
| trot | +2.96 | +3.00 | +3.00 | +3.00 |
| base_height | +0.22 | +0.23 | +0.17 | +0.22 |
| action_rate | -0.07 | -0.07 | -0.11 | -0.10 |
| feet_air_time | +0.19 | +0.19 | +0.00 | +0.24 |
| energy | -0.14 | -0.14 | -0.17 | -0.18 |
| abduction_pose | -0.08 | -0.08 | -0.13 | -0.07 |
| leg_clash | -0.00 | -0.01 | -0.01 | -0.02 |
| roll_pitch_rate | -0.04 | -0.04 | -0.07 | -0.04 |
| vertical | -0.01 | -0.01 | -0.01 | -0.01 |
| joint_limit | -0.00 | -0.00 | -0.00 | +0.00 |
| action_limit | +0.00 | +0.00 | -0.00 | +0.00 |
| gu_upright | +0.00 | +0.00 | +0.00 | +0.00 |
| gu_height | +0.00 | +0.00 | +0.00 | +0.00 |
| gu_rise | +0.00 | +0.00 | -0.00 | +0.00 |
| fall | +0.00 | +0.00 | -0.01 | +0.00 |
| sg_goal | +0.00 | +0.00 | +0.00 | +0.00 |
| sg_hard | +0.00 | +0.00 | +0.00 | +0.00 |
| undesired_contact | +0.00 | -0.00 | -0.00 | +0.00 |
| flight | -0.00 | -0.00 | -0.00 | -0.00 |
| seconds | 1150.1 | 3064.8 | 780.4 | 77.9 |

desc_s1: reached the bottom r2 t25 100 %, r3 t9 0 %, r3 t12 25 %, r4 t12 0 %, r4 t15 10 %

| term | landing | edge | stairs | refusing |
|---|---|---|---|---|
| track_lin | +3.66 | +1.91 | +2.54 | +0.23 |
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
| sg_hard | +0.00 | +0.00 | +0.00 | +0.00 |
| undesired_contact | -0.00 | -0.00 | -0.00 | +0.00 |
| flight | -0.00 | -0.00 | -0.00 | +0.00 |
| seconds | 1349.6 | 3224.6 | 583.4 | 122.6 |

margin_s2: reached the bottom r2 t25 100 %, r3 t9 7 %, r3 t12 20 %, r4 t12 3 %, r4 t15 27 %

| term | landing | edge | stairs | refusing |
|---|---|---|---|---|
| track_lin | +3.46 | +2.53 | +2.26 | +0.57 |
| progress | +1.26 | +0.36 | +1.29 | +0.02 |
| sg_margin | -0.63 | +0.26 | -0.46 | +0.07 |
| track_ang | +1.26 | +0.69 | +1.04 | +0.77 |
| stand_still | -0.20 | +0.00 | +0.00 | +0.00 |
| foot_clearance | +0.94 | +1.10 | +0.97 | +1.08 |
| upright | -0.02 | -0.08 | -0.14 | -0.05 |
| trot | +2.94 | +3.00 | +3.00 | +3.00 |
| feet_air_time | +0.20 | +0.16 | -0.02 | +0.22 |
| action_rate | -0.08 | -0.06 | -0.10 | -0.09 |
| abduction_pose | -0.06 | -0.08 | -0.13 | -0.08 |
| energy | -0.15 | -0.14 | -0.16 | -0.17 |
| base_height | +0.22 | +0.23 | +0.17 | +0.23 |
| roll_pitch_rate | -0.05 | -0.04 | -0.06 | -0.04 |
| fall | +0.00 | -0.00 | +0.00 | +0.00 |
| leg_clash | -0.01 | -0.01 | -0.01 | -0.02 |
| joint_limit | +0.00 | -0.00 | -0.00 | +0.00 |
| action_limit | +0.00 | +0.00 | -0.00 | +0.00 |
| gu_upright | +0.00 | +0.00 | +0.00 | +0.00 |
| gu_height | +0.00 | +0.00 | +0.00 | +0.00 |
| gu_rise | +0.00 | +0.00 | +0.00 | +0.00 |
| sg_goal | +0.00 | +0.00 | +0.00 | +0.00 |
| sg_hard | +0.00 | +0.00 | +0.00 | +0.00 |
| undesired_contact | +0.00 | -0.00 | -0.00 | +0.00 |
| flight | -0.00 | -0.00 | -0.00 | +0.00 |
| vertical | -0.01 | -0.01 | -0.01 | -0.01 |
| seconds | 793.2 | 3246.7 | 978.8 | 68.0 |

## The tilting plateau: share standing for 12 s (fell / slid), per tilt and downhill direction

On paper (tools/dog/tilt_limits.py): the standing pose tips at 20 deg facing downhill, 28 nose up, 29 sideways; with the best posture (body back / crouched) beyond 45 deg, where the paws slide (mu 1.0).

free_s2 (servos holding the pose):

| tilt | nose down | diagonal | sideways | nose up |
|---|---|---|---|---|
| 0 deg | 100 % (0/0) | 100 % (0/0) | 100 % (0/0) | 100 % (0/0) |
| 5 deg | 100 % (0/0) | 100 % (0/0) | 100 % (0/0) | 100 % (0/0) |
| 10 deg | 100 % (0/0) | 100 % (0/0) | 100 % (0/0) | 100 % (0/0) |
| 15 deg | 60 % (40/0) | 100 % (0/0) | 100 % (0/0) | 100 % (0/0) |
| 20 deg | 0 % (100/0) | 50 % (50/0) | 100 % (0/0) | 70 % (30/0) |
| 25 deg | 0 % (100/0) | 0 % (100/0) | 60 % (40/0) | 0 % (100/0) |
| 30 deg | 0 % (100/0) | 0 % (100/0) | 0 % (100/0) | 0 % (100/0) |
| 35 deg | 0 % (100/0) | 0 % (100/0) | 0 % (100/0) | 0 % (100/0) |
| 40 deg | 0 % (100/0) | 0 % (100/0) | 0 % (100/0) | 0 % (100/0) |
| 45 deg | 0 % (100/0) | 0 % (100/0) | 0 % (100/0) | 0 % (100/0) |

Standing still on the flat: 0.00 W, summed joint speed 0.020 rad/s

bc_s2:

| tilt | nose down | diagonal | sideways | nose up |
|---|---|---|---|---|
| 0 deg | 0 % (0/100) | 10 % (0/90) | 10 % (0/90) | 10 % (0/90) |
| 5 deg | 0 % (0/100) | 60 % (0/40) | 30 % (0/70) | 0 % (0/100) |
| 10 deg | 40 % (0/60) | 30 % (0/70) | 0 % (0/100) | 0 % (0/100) |
| 15 deg | 30 % (0/70) | 30 % (0/70) | 10 % (0/90) | 0 % (0/100) |
| 20 deg | 0 % (60/40) | 0 % (0/100) | 0 % (0/100) | 0 % (0/100) |
| 25 deg | 0 % (100/0) | 0 % (100/0) | 0 % (70/30) | 0 % (100/0) |
| 30 deg | 0 % (100/0) | 0 % (100/0) | 0 % (100/0) | 0 % (100/0) |
| 35 deg | 0 % (100/0) | 0 % (100/0) | 0 % (100/0) | 0 % (100/0) |
| 40 deg | 0 % (100/0) | 0 % (100/0) | 0 % (100/0) | 0 % (100/0) |
| 45 deg | 0 % (100/0) | 0 % (100/0) | 0 % (100/0) | 0 % (100/0) |

Standing still on the flat: 1.93 W, summed joint speed 3.500 rad/s

free_s2:

| tilt | nose down | diagonal | sideways | nose up |
|---|---|---|---|---|
| 0 deg | 10 % (0/90) | 0 % (0/100) | 0 % (0/100) | 0 % (0/100) |
| 5 deg | 0 % (0/100) | 10 % (0/90) | 30 % (0/70) | 0 % (0/100) |
| 10 deg | 60 % (0/40) | 90 % (0/10) | 0 % (0/100) | 0 % (0/100) |
| 15 deg | 60 % (0/40) | 0 % (0/100) | 50 % (0/50) | 0 % (0/100) |
| 20 deg | 0 % (0/100) | 40 % (0/60) | 100 % (0/0) | 0 % (0/100) |
| 25 deg | 0 % (90/10) | 0 % (100/0) | 0 % (100/0) | 0 % (50/50) |
| 30 deg | 0 % (100/0) | 0 % (100/0) | 0 % (100/0) | 0 % (100/0) |
| 35 deg | 0 % (100/0) | 0 % (100/0) | 0 % (100/0) | 0 % (100/0) |
| 40 deg | 0 % (100/0) | 0 % (100/0) | 0 % (100/0) | 0 % (100/0) |
| 45 deg | 0 % (100/0) | 0 % (100/0) | 0 % (100/0) | 0 % (100/0) |

Standing still on the flat: 1.98 W, summed joint speed 3.760 rad/s

desc_s1:

| tilt | nose down | diagonal | sideways | nose up |
|---|---|---|---|---|
| 0 deg | 10 % (0/90) | 0 % (0/100) | 0 % (0/100) | 10 % (0/90) |
| 5 deg | 0 % (0/100) | 0 % (0/100) | 10 % (0/90) | 0 % (0/100) |
| 10 deg | 70 % (0/30) | 10 % (0/90) | 0 % (0/100) | 0 % (0/100) |
| 15 deg | 0 % (0/100) | 40 % (0/60) | 0 % (0/100) | 0 % (0/100) |
| 20 deg | 0 % (50/50) | 0 % (0/100) | 10 % (0/90) | 0 % (0/100) |
| 25 deg | 0 % (100/0) | 0 % (100/0) | 0 % (100/0) | 10 % (60/30) |
| 30 deg | 0 % (100/0) | 0 % (100/0) | 0 % (100/0) | 0 % (90/10) |
| 35 deg | 0 % (100/0) | 0 % (100/0) | 0 % (100/0) | 0 % (100/0) |
| 40 deg | 0 % (100/0) | 0 % (100/0) | 0 % (100/0) | 0 % (100/0) |
| 45 deg | 0 % (100/0) | 0 % (100/0) | 0 % (100/0) | 0 % (100/0) |

Standing still on the flat: 1.48 W, summed joint speed 3.434 rad/s

margin_s1:

| tilt | nose down | diagonal | sideways | nose up |
|---|---|---|---|---|
| 0 deg | 10 % (0/90) | 20 % (0/80) | 10 % (0/90) | 30 % (0/70) |
| 5 deg | 0 % (0/100) | 30 % (0/70) | 10 % (0/90) | 0 % (0/100) |
| 10 deg | 100 % (0/0) | 20 % (0/80) | 0 % (0/100) | 0 % (0/100) |
| 15 deg | 50 % (0/50) | 30 % (0/70) | 0 % (0/100) | 0 % (0/100) |
| 20 deg | 10 % (20/70) | 0 % (0/100) | 100 % (0/0) | 0 % (10/90) |
| 25 deg | 0 % (100/0) | 0 % (100/0) | 0 % (100/0) | 0 % (50/50) |
| 30 deg | 0 % (100/0) | 0 % (100/0) | 0 % (100/0) | 0 % (100/0) |
| 35 deg | 0 % (100/0) | 0 % (100/0) | 0 % (100/0) | 0 % (100/0) |
| 40 deg | 0 % (100/0) | 0 % (100/0) | 0 % (100/0) | 0 % (100/0) |
| 45 deg | 0 % (100/0) | 0 % (100/0) | 0 % (100/0) | 0 % (100/0) |

Standing still on the flat: 1.99 W, summed joint speed 3.594 rad/s

desc_s2:

| tilt | nose down | diagonal | sideways | nose up |
|---|---|---|---|---|
| 0 deg | 40 % (0/60) | 10 % (0/90) | 10 % (0/90) | 0 % (0/100) |
| 5 deg | 0 % (0/100) | 0 % (0/100) | 30 % (0/70) | 0 % (0/100) |
| 10 deg | 90 % (0/10) | 20 % (0/80) | 0 % (0/100) | 0 % (0/100) |
| 15 deg | 10 % (0/90) | 100 % (0/0) | 0 % (0/100) | 0 % (0/100) |
| 20 deg | 0 % (50/50) | 20 % (0/80) | 100 % (0/0) | 0 % (0/100) |
| 25 deg | 0 % (90/10) | 0 % (100/0) | 0 % (100/0) | 0 % (70/30) |
| 30 deg | 0 % (100/0) | 0 % (100/0) | 0 % (100/0) | 0 % (100/0) |
| 35 deg | 0 % (100/0) | 0 % (100/0) | 0 % (100/0) | 0 % (100/0) |
| 40 deg | 0 % (100/0) | 0 % (100/0) | 0 % (100/0) | 0 % (100/0) |
| 45 deg | 0 % (100/0) | 0 % (100/0) | 0 % (100/0) | 0 % (100/0) |

Standing still on the flat: 2.02 W, summed joint speed 3.667 rad/s

margin_s2:

| tilt | nose down | diagonal | sideways | nose up |
|---|---|---|---|---|
| 0 deg | 0 % (0/100) | 0 % (0/100) | 0 % (0/100) | 20 % (0/80) |
| 5 deg | 0 % (0/100) | 0 % (0/100) | 20 % (0/80) | 0 % (0/100) |
| 10 deg | 90 % (0/10) | 50 % (0/50) | 0 % (0/100) | 0 % (0/100) |
| 15 deg | 60 % (0/40) | 90 % (0/10) | 0 % (0/100) | 0 % (0/100) |
| 20 deg | 0 % (40/60) | 10 % (10/80) | 80 % (10/10) | 0 % (0/100) |
| 25 deg | 0 % (100/0) | 0 % (100/0) | 0 % (100/0) | 0 % (30/70) |
| 30 deg | 0 % (100/0) | 0 % (100/0) | 0 % (100/0) | 0 % (100/0) |
| 35 deg | 0 % (100/0) | 0 % (100/0) | 0 % (100/0) | 0 % (100/0) |
| 40 deg | 0 % (100/0) | 0 % (100/0) | 0 % (100/0) | 0 % (100/0) |
| 45 deg | 0 % (100/0) | 0 % (100/0) | 0 % (100/0) | 0 % (100/0) |

Standing still on the flat: 1.90 W, summed joint speed 3.531 rad/s

## Stair plans with a 3 cm balance margin, replayed open loop (nominal)

0 of 29 plans climbed by at least one dog: 

## Stair plans with a 3 cm balance margin, replayed open loop (randomized (4 dogs per plan))

8 of 29 plans climbed by at least one dog: down_r1_t12 (100 %), down_r1_t9 (25 %), down_r2_t9 (25 %), up_r1_t12 (50 %), up_r1_t20 (25 %), up_r1_t9 (50 %), up_r2_t15 (100 %), up_r3_t15 (75 %)

## Stairs goal test (clean = reached without any fall)

| dog | up, possible | down, possible | no plan (up / down) | limits up (treads 25-9) | limits down | mean clean |
|---|---|---|---|---|---|---|
| free_s2 | 84 % | 73 % | 4 / 2 % | 5 / 4 / 4 / 3 / 2 | 3 / 3 / 2 / 1 / 1 | 0.378 |
| cont_s1 | 85 % | 70 % | 3 / 2 % | 5 / 4 / 4 / 3 / 2 | 3 / 2 / 2 / 1 / 1 | 0.373 |
| rsi_s2 | 85 % | 67 % | 5 / 1 % | 4 / 4 / 4 / 4 / 3 | 2 / 2 / 2 / 1 / 1 | 0.370 |
| desc_s1 | 82 % | 63 % | 4 / 1 % | 4 / 3 / 3 / 3 / 3 | 3 / 2 / 2 / 1 / 1 | 0.351 |
| desc_s2 | 84 % | 64 % | 4 / 0 % | 5 / 4 / 3 / 3 / 3 | 3 / 2 / 2 / 1 / 1 | 0.354 |
| margin_s1 | 82 % | 73 % | 3 / 2 % | 4 / 3 / 4 / 3 / 2 | 3 / 2 / 2 / 1 / 1 | 0.370 |
| margin_s2 | 82 % | 69 % | 3 / 2 % | 4 / 4 / 4 / 3 / 2 | 2 / 2 / 2 / 1 / 1 | 0.365 |

Descents per cell (possible ones), clean %:

| dog | r1 t9 | r2 t9 | r3 t9 | r1 t12 | r2 t12 | r3 t12 | r4 t12 | r1 t15 | r2 t15 | r3 t15 | r4 t15 | r1 t20 | r2 t20 | r3 t20 | r4 t20 | r5 t20 | r1 t25 | r2 t25 | r3 t25 | r4 t25 | r5 t25 |
|---|---|---|---|---|---|---|---|---|---|---|---|---|---|---|---|---|---|---|---|---|---|
| free_s2 | 100 | 38 | 18 | 100 | 82 | 52 | 8 | 100 | 100 | 70 | 40 | 100 | 98 | 92 | 52 | 35 | 100 | 100 | 98 | 75 | 75 |
| cont_s1 | 100 | 45 | 20 | 100 | 82 | 38 | 10 | 100 | 100 | 38 | 35 | 100 | 100 | 80 | 65 | 30 | 100 | 100 | 98 | 70 | 68 |
| rsi_s2 | 100 | 45 | 18 | 100 | 57 | 40 | 5 | 100 | 92 | 55 | 30 | 100 | 100 | 70 | 60 | 15 | 100 | 100 | 90 | 78 | 55 |
| desc_s1 | 100 | 30 | 2 | 100 | 40 | 35 | 10 | 100 | 100 | 42 | 32 | 100 | 100 | 65 | 57 | 5 | 100 | 100 | 98 | 48 | 52 |
| desc_s2 | 100 | 20 | 0 | 100 | 75 | 25 | 0 | 100 | 100 | 40 | 15 | 100 | 100 | 90 | 48 | 8 | 100 | 100 | 100 | 57 | 57 |
| margin_s1 | 100 | 48 | 25 | 100 | 80 | 35 | 28 | 100 | 100 | 52 | 45 | 100 | 100 | 88 | 68 | 28 | 100 | 100 | 100 | 70 | 72 |
| margin_s2 | 100 | 38 | 20 | 100 | 45 | 42 | 8 | 100 | 95 | 35 | 57 | 100 | 100 | 65 | 65 | 42 | 100 | 100 | 90 | 68 | 75 |

## Nothing forgotten? Walking (falls, walk score)

| dog | forward | course | stairs straight | power |
|---|---|---|---|---|
| free_s2 | 1.0 % (0.46) | 0.7 % (0.43) | 1.8 % (0.45) | 12.9 W |
| cont_s1 | 1.3 % (0.45) | 1.0 % (0.44) | 1.6 % (0.44) | 12.7 W |
| rsi_s2 | 1.0 % (0.44) | 0.6 % (0.43) | 1.7 % (0.44) | 12.6 W |
| desc_s1 | 1.0 % (0.45) | 0.8 % (0.44) | 2.1 % (0.45) | 12.7 W |
| desc_s2 | 1.1 % (0.45) | 0.9 % (0.44) | 1.6 % (0.45) | 12.7 W |
| margin_s1 | 0.9 % (0.45) | 0.6 % (0.43) | 2.2 % (0.44) | 12.5 W |
| margin_s2 | 1.2 % (0.45) | 0.2 % (0.44) | 1.5 % (0.45) | 12.7 W |

One shove while walking (stays up / gets up / stays down):

| dog | 0.3 m/s | 0.5 m/s | 0.7 m/s | 0.9 m/s | 1.1 m/s | 1.3 m/s | 1.5 m/s |
|---|---|---|---|---|---|---|---|
| free_s2 | 99 / 1 / 0 % | 77 / 23 / 0 % | 69 / 31 / 0 % | 64 / 36 / 0 % | 39 / 61 / 0 % | 20 / 80 / 0 % | 2 / 97 / 1 % |
| cont_s1 | 99 / 1 / 0 % | 83 / 17 / 0 % | 76 / 24 / 0 % | 57 / 42 / 0 % | 42 / 58 / 0 % | 13 / 83 / 4 % | 0 / 94 / 6 % |
| rsi_s2 | 100 / 0 / 0 % | 82 / 18 / 0 % | 70 / 30 / 0 % | 64 / 36 / 0 % | 34 / 66 / 0 % | 7 / 93 / 0 % | 0 / 94 / 6 % |
| desc_s1 | 100 / 0 / 0 % | 83 / 17 / 0 % | 71 / 29 / 0 % | 60 / 40 / 0 % | 40 / 58 / 2 % | 8 / 85 / 7 % | 0 / 90 / 10 % |
| desc_s2 | 100 / 0 / 0 % | 77 / 23 / 0 % | 64 / 36 / 0 % | 54 / 46 / 0 % | 34 / 66 / 1 % | 4 / 93 / 3 % | 0 / 93 / 7 % |
| margin_s1 | 100 / 0 / 0 % | 81 / 19 / 0 % | 74 / 26 / 0 % | 57 / 43 / 0 % | 30 / 68 / 1 % | 6 / 91 / 3 % | 1 / 93 / 6 % |
| margin_s2 | 100 / 0 / 0 % | 79 / 21 / 0 % | 72 / 28 / 0 % | 58 / 42 / 0 % | 28 / 70 / 2 % | 10 / 86 / 5 % | 0 / 88 / 12 % |

Getting up within 8 s:

| dog | standing | dropped upright | on its side | on its back |
|---|---|---|---|---|
| free_s2 | 100 % | 100 % | 100 % | 100 % |
| cont_s1 | 100 % | 100 % | 100 % | 100 % |
| rsi_s2 | 100 % | 100 % | 100 % | 100 % |
| desc_s1 | 100 % | 100 % | 100 % | 100 % |
| desc_s2 | 100 % | 100 % | 100 % | 100 % |
| margin_s1 | 100 % | 100 % | 100 % | 100 % |
| margin_s2 | 100 % | 100 % | 100 % | 100 % |

Best per variant: {"desc": ["desc_s2", 0.354], "margin": ["margin_s1", 0.37], "start free_s2": 0.378}

Videos: `videos/compare_down_r3_t9.mp4`, `videos/compare_down_r4_t15.mp4`, `videos/compare_up_r4_t9.mp4`, `videos/compare_up_r5_t15.mp4`, `videos/replay_down_r3_t15.mp4`, `videos/replay_up_r4_t12.mp4`
