ossehaas/Robot-Evolution-Lab/runs/exp2_dog/21_base_skills/results.md

# Base skills B1 + B2: stand still, stay balanced on a tilt (step 43)

## Pass / fail (`.documentation/base-skills.md`)

B1 on the flat: still >= 90 % of the time after 2 s, still within 2 s, moves < 2 cm in 10 s. B2 on plates up to 15 deg (nose down, diagonal) / 20 deg (sideways, nose up): never falls, still >= 80 %; after a 0.3 m/s shove no fall and still again within 3 s.

| dog | B1 still (flat) | settle | moved | power | B1 | B2 worst still | B2 falls | after shove: falls / resettle | B2 |
|---|---|---|---|---|---|---|---|---|---|
| free_s2 | 0 % | never | 8.7 cm | 1.96 W | FAIL | 0 % | 10 % | 0 % / never | FAIL |
| amp_w6m_slow_s1 | 0 % | never | 8.7 cm | 3.29 W | FAIL | 0 % | 10 % | - | FAIL |
| still_s1 | 0 % | never | 9.5 cm | 1.87 W | FAIL | 0 % | 10 % | 0 % / never | FAIL |
| tilt_s1 | 0 % | never | 4.7 cm | 0.83 W | FAIL | 0 % | 40 % | 33 % / never | FAIL |
| still_s2 | 0 % | never | 8.9 cm | 1.86 W | FAIL | 0 % | 10 % | 0 % / never | FAIL |
| tilt_s2 | 0 % | never | 11.4 cm | 0.77 W | FAIL | 0 % | 30 % | 20 % / never | FAIL |

### free_s2, standing 12 s: fell % / still % (settle s)

| tilt | nose down | diagonal | sideways | nose up |
|---|---|---|---|---|
| 0 deg | 0 / 0 % (-) | 0 / 0 % (-) | 0 / 0 % (-) | 0 / 0 % (-) |
| 5 deg | 0 / 0 % (-) | 0 / 0 % (-) | 0 / 0 % (-) | 0 / 0 % (-) |
| 10 deg | 0 / 0 % (-) | 0 / 0 % (-) | 0 / 0 % (-) | 0 / 0 % (-) |
| 15 deg | 0 / 0 % (-) | 0 / 0 % (-) | 0 / 0 % (-) | 0 / 0 % (-) |
| 20 deg | 30 / 0 % (-) | 10 / 0 % (-) | 0 / 0 % (-) | 10 / 0 % (-) |
| 25 deg | 90 / 0 % (-) | 100 / - (-) | 100 / - (-) | 30 / 0 % (-) |
| 30 deg | 100 / - (-) | 100 / - (-) | 100 / - (-) | 100 / - (-) |
| 35 deg | 100 / - (-) | 100 / - (-) | 100 / - (-) | 100 / - (-) |
| 40 deg | 100 / - (-) | 100 / - (-) | 100 / - (-) | 100 / - (-) |
| 45 deg | 100 / - (-) | 100 / - (-) | 100 / - (-) | 100 / - (-) |

### free_s2, shoved 0.3 m/s at 6 s: fell % / still % (settle s) / after the shove: fell %, resettle s

| tilt | nose down | diagonal | sideways | nose up |
|---|---|---|---|---|
| 0 deg | 0 / 0 % (-) / 0 %, - | 0 / 0 % (-) / 0 %, - | 0 / 0 % (-) / 0 %, - | 0 / 0 % (-) / 0 %, - |
| 5 deg | 0 / 0 % (-) / 0 %, - | 0 / 0 % (-) / 0 %, - | 0 / 0 % (-) / 0 %, - | 0 / 0 % (-) / 0 %, - |
| 10 deg | 0 / 0 % (-) / 0 %, - | 0 / 0 % (-) / 0 %, - | 0 / 0 % (-) / 0 %, - | 0 / 0 % (-) / 0 %, - |
| 15 deg | 0 / 0 % (-) / 0 %, - | 0 / 0 % (-) / 0 %, - | 0 / 0 % (-) / 0 %, - | 0 / 0 % (-) / 0 %, - |
| 20 deg | 10 / 0 % (-) / 0 %, - | 10 / 0 % (-) / 0 %, - | 0 / 0 % (-) / 0 %, - | 10 / 0 % (-) / 0 %, - |
| 25 deg | 100 / - (-) / -, - | 100 / - (-) / -, - | 100 / - (-) / 100 %, - | 40 / 0 % (-) / 25 %, - |
| 30 deg | 100 / - (-) / -, - | 100 / - (-) / -, - | 100 / - (-) / -, - | 100 / - (-) / -, - |
| 35 deg | 100 / - (-) / -, - | 100 / - (-) / -, - | 100 / - (-) / -, - | 100 / - (-) / -, - |
| 40 deg | 100 / - (-) / -, - | 100 / - (-) / -, - | 100 / - (-) / -, - | 100 / - (-) / -, - |
| 45 deg | 100 / - (-) / -, - | 100 / - (-) / -, - | 100 / - (-) / -, - | 100 / - (-) / -, - |

### amp_w6m_slow_s1, standing 12 s: fell % / still % (settle s)

| tilt | nose down | diagonal | sideways | nose up |
|---|---|---|---|---|
| 0 deg | 0 / 0 % (-) | 0 / 0 % (-) | 0 / 0 % (-) | 0 / 0 % (-) |
| 5 deg | 0 / 0 % (-) | 0 / 0 % (-) | 0 / 0 % (-) | 0 / 0 % (-) |
| 10 deg | 0 / 0 % (-) | 0 / 0 % (-) | 0 / 0 % (-) | 0 / 0 % (-) |
| 15 deg | 0 / 0 % (-) | 0 / 0 % (-) | 0 / 0 % (-) | 0 / 0 % (-) |
| 20 deg | 0 / 0 % (-) | 0 / 0 % (-) | 10 / 0 % (-) | 0 / 0 % (-) |
| 25 deg | 10 / 0 % (-) | 20 / 0 % (-) | 30 / 0 % (-) | 60 / 0 % (-) |
| 30 deg | 70 / 0 % (-) | 50 / 0 % (-) | 50 / 0 % (-) | 80 / 0 % (-) |
| 35 deg | 100 / - (-) | 60 / 1 % (-) | 80 / 2 % (-) | 100 / - (-) |
| 40 deg | 100 / - (-) | 100 / - (-) | 100 / - (-) | 100 / - (-) |
| 45 deg | 100 / - (-) | 100 / - (-) | 100 / - (-) | 100 / - (-) |

### free_s2 (servos holding the pose), shoved 0.3 m/s at 6 s: fell % / still % (settle s) / after the shove: fell %, resettle s

| tilt | nose down | diagonal | sideways | nose up |
|---|---|---|---|---|
| 0 deg | 0 / 98 % (0.12) / 0 %, 0.22 | 0 / 98 % (0.12) / 0 %, 0.32 | 0 / 98 % (0.12) / 0 %, 0.22 | 0 / 98 % (0.12) / 0 %, 0.22 |
| 5 deg | 0 / 98 % (0.12) / 0 %, 0.22 | 0 / 98 % (0.12) / 0 %, 0.22 | 0 / 98 % (0.12) / 0 %, 0.34 | 0 / 98 % (0.12) / 0 %, 0.22 |
| 10 deg | 10 / 97 % (0.14) / 10 %, 0.36 | 0 / 98 % (0.14) / 0 %, 0.32 | 0 / 98 % (0.12) / 0 %, 0.28 | 0 / 98 % (0.12) / 0 %, 0.24 |
| 15 deg | 90 / 97 % (0.14) / 67 %, 0.42 | 30 / 98 % (0.16) / 30 %, 0.24 | 0 / 98 % (0.14) / 0 %, 0.3 | 0 / 97 % (0.18) / 0 %, 0.34 |
| 20 deg | 100 / - (-) / -, - | 70 / 98 % (0.48) / 50 %, 0.34 | 30 / 98 % (0.16) / 30 %, 0.28 | 40 / 98 % (0.56) / 40 %, 0.26 |
| 25 deg | 100 / - (-) / -, - | 100 / - (-) / -, - | 70 / 98 % (0.12) / 57 %, 0.1 | 100 / - (-) / -, - |
| 30 deg | 100 / - (-) / -, - | 100 / - (-) / -, - | 100 / - (-) / -, - | 100 / - (-) / -, - |
| 35 deg | 100 / - (-) / -, - | 100 / - (-) / -, - | 100 / - (-) / -, - | 100 / - (-) / -, - |
| 40 deg | 100 / - (-) / -, - | 100 / - (-) / -, - | 100 / - (-) / -, - | 100 / - (-) / -, - |
| 45 deg | 100 / - (-) / -, - | 100 / - (-) / -, - | 100 / - (-) / -, - | 100 / - (-) / -, - |

### still_s1, standing 12 s: fell % / still % (settle s)

| tilt | nose down | diagonal | sideways | nose up |
|---|---|---|---|---|
| 0 deg | 0 / 0 % (-) | 0 / 0 % (-) | 0 / 0 % (-) | 0 / 0 % (-) |
| 5 deg | 0 / 0 % (-) | 0 / 0 % (-) | 0 / 0 % (-) | 0 / 0 % (-) |
| 10 deg | 0 / 0 % (-) | 0 / 0 % (-) | 0 / 0 % (-) | 0 / 0 % (-) |
| 15 deg | 0 / 0 % (-) | 0 / 0 % (-) | 0 / 0 % (-) | 0 / 0 % (-) |
| 20 deg | 30 / 0 % (-) | 30 / 0 % (-) | 10 / 0 % (-) | 10 / 0 % (-) |
| 25 deg | 100 / - (-) | 100 / - (-) | 100 / - (-) | 70 / 0 % (-) |
| 30 deg | 100 / - (-) | 100 / - (-) | 100 / - (-) | 100 / - (-) |
| 35 deg | 100 / - (-) | 100 / - (-) | 100 / - (-) | 100 / - (-) |
| 40 deg | 100 / - (-) | 100 / - (-) | 100 / - (-) | 100 / - (-) |
| 45 deg | 100 / - (-) | 100 / - (-) | 100 / - (-) | 100 / - (-) |

### still_s1, shoved 0.3 m/s at 6 s: fell % / still % (settle s) / after the shove: fell %, resettle s

| tilt | nose down | diagonal | sideways | nose up |
|---|---|---|---|---|
| 0 deg | 0 / 0 % (-) / 0 %, - | 0 / 0 % (-) / 0 %, - | 0 / 0 % (-) / 0 %, - | 0 / 0 % (-) / 0 %, - |
| 5 deg | 0 / 0 % (-) / 0 %, - | 0 / 0 % (-) / 0 %, - | 0 / 0 % (-) / 0 %, - | 0 / 0 % (-) / 0 %, - |
| 10 deg | 0 / 0 % (-) / 0 %, - | 0 / 0 % (-) / 0 %, - | 0 / 0 % (-) / 0 %, - | 0 / 0 % (-) / 0 %, - |
| 15 deg | 0 / 0 % (-) / 0 %, - | 0 / 0 % (-) / 0 %, - | 0 / 0 % (-) / 0 %, - | 0 / 0 % (-) / 0 %, - |
| 20 deg | 0 / 0 % (-) / 0 %, - | 20 / 0 % (-) / 0 %, - | 0 / 0 % (-) / 0 %, - | 20 / 0 % (-) / 0 %, - |
| 25 deg | 100 / - (-) / -, - | 100 / - (-) / -, - | 100 / - (-) / -, - | 50 / 0 % (-) / 44 %, - |
| 30 deg | 100 / - (-) / -, - | 100 / - (-) / -, - | 100 / - (-) / -, - | 100 / - (-) / -, - |
| 35 deg | 100 / - (-) / -, - | 100 / - (-) / -, - | 100 / - (-) / -, - | 100 / - (-) / -, - |
| 40 deg | 100 / - (-) / -, - | 100 / - (-) / -, - | 100 / - (-) / -, - | 100 / - (-) / -, - |
| 45 deg | 100 / - (-) / -, - | 100 / - (-) / -, - | 100 / - (-) / -, - | 100 / - (-) / -, - |

### tilt_s1, standing 12 s: fell % / still % (settle s)

| tilt | nose down | diagonal | sideways | nose up |
|---|---|---|---|---|
| 0 deg | 0 / 0 % (-) | 0 / 0 % (-) | 0 / 0 % (-) | 0 / 0 % (-) |
| 5 deg | 0 / 0 % (-) | 0 / 0 % (-) | 0 / 0 % (-) | 0 / 0 % (-) |
| 10 deg | 0 / 0 % (-) | 0 / 0 % (-) | 0 / 0 % (-) | 0 / 0 % (-) |
| 15 deg | 0 / 0 % (-) | 0 / 0 % (-) | 0 / 0 % (-) | 0 / 0 % (-) |
| 20 deg | 10 / 0 % (-) | 0 / 0 % (-) | 40 / 0 % (-) | 10 / 0 % (-) |
| 25 deg | 100 / - (-) | 100 / - (-) | 100 / - (-) | 80 / 0 % (-) |
| 30 deg | 100 / - (-) | 100 / - (-) | 100 / - (-) | 100 / - (-) |
| 35 deg | 100 / - (-) | 100 / - (-) | 100 / - (-) | 100 / - (-) |
| 40 deg | 100 / - (-) | 100 / - (-) | 100 / - (-) | 100 / - (-) |
| 45 deg | 100 / - (-) | 100 / - (-) | 100 / - (-) | 100 / - (-) |

### tilt_s1, shoved 0.3 m/s at 6 s: fell % / still % (settle s) / after the shove: fell %, resettle s

| tilt | nose down | diagonal | sideways | nose up |
|---|---|---|---|---|
| 0 deg | 0 / 0 % (-) / 0 %, - | 0 / 0 % (-) / 0 %, - | 10 / 0 % (-) / 10 %, - | 0 / 0 % (-) / 0 %, - |
| 5 deg | 0 / 0 % (-) / 0 %, - | 0 / 0 % (-) / 0 %, - | 0 / 0 % (-) / 0 %, - | 0 / 0 % (-) / 0 %, - |
| 10 deg | 0 / 0 % (-) / 0 %, - | 0 / 0 % (-) / 0 %, - | 0 / 0 % (-) / 0 %, - | 0 / 0 % (-) / 0 %, - |
| 15 deg | 0 / 0 % (-) / 0 %, - | 0 / 0 % (-) / 0 %, - | 0 / 0 % (-) / 0 %, - | 0 / 0 % (-) / 0 %, - |
| 20 deg | 0 / 0 % (-) / 0 %, - | 20 / 0 % (-) / 20 %, - | 40 / 0 % (-) / 33 %, - | 10 / 0 % (-) / 0 %, - |
| 25 deg | 100 / - (-) / 100 %, - | 100 / - (-) / -, - | 100 / - (-) / -, - | 100 / - (-) / 100 %, - |
| 30 deg | 100 / - (-) / -, - | 100 / - (-) / -, - | 100 / - (-) / -, - | 100 / - (-) / -, - |
| 35 deg | 100 / - (-) / -, - | 100 / - (-) / -, - | 100 / - (-) / -, - | 100 / - (-) / -, - |
| 40 deg | 100 / - (-) / -, - | 100 / - (-) / -, - | 100 / - (-) / -, - | 100 / - (-) / -, - |
| 45 deg | 100 / - (-) / -, - | 100 / - (-) / -, - | 100 / - (-) / -, - | 100 / - (-) / -, - |

### still_s2, standing 12 s: fell % / still % (settle s)

| tilt | nose down | diagonal | sideways | nose up |
|---|---|---|---|---|
| 0 deg | 0 / 0 % (-) | 0 / 0 % (-) | 0 / 0 % (-) | 0 / 0 % (-) |
| 5 deg | 0 / 0 % (-) | 0 / 0 % (-) | 0 / 0 % (-) | 0 / 0 % (-) |
| 10 deg | 0 / 0 % (-) | 0 / 0 % (-) | 0 / 0 % (-) | 0 / 0 % (-) |
| 15 deg | 0 / 0 % (-) | 0 / 0 % (-) | 0 / 0 % (-) | 0 / 0 % (-) |
| 20 deg | 20 / 0 % (-) | 0 / 0 % (-) | 10 / 0 % (-) | 10 / 0 % (-) |
| 25 deg | 100 / - (-) | 90 / 0 % (-) | 70 / 0 % (-) | 80 / 0 % (-) |
| 30 deg | 100 / - (-) | 100 / - (-) | 100 / - (-) | 100 / - (-) |
| 35 deg | 100 / - (-) | 100 / - (-) | 100 / - (-) | 100 / - (-) |
| 40 deg | 100 / - (-) | 100 / - (-) | 100 / - (-) | 100 / - (-) |
| 45 deg | 100 / - (-) | 100 / - (-) | 100 / - (-) | 100 / - (-) |

### still_s2, shoved 0.3 m/s at 6 s: fell % / still % (settle s) / after the shove: fell %, resettle s

| tilt | nose down | diagonal | sideways | nose up |
|---|---|---|---|---|
| 0 deg | 0 / 0 % (-) / 0 %, - | 0 / 0 % (-) / 0 %, - | 0 / 0 % (-) / 0 %, - | 0 / 0 % (-) / 0 %, - |
| 5 deg | 0 / 0 % (-) / 0 %, - | 0 / 0 % (-) / 0 %, - | 0 / 0 % (-) / 0 %, - | 0 / 0 % (-) / 0 %, - |
| 10 deg | 0 / 0 % (-) / 0 %, - | 0 / 0 % (-) / 0 %, - | 0 / 0 % (-) / 0 %, - | 0 / 0 % (-) / 0 %, - |
| 15 deg | 10 / 0 % (-) / 0 %, - | 0 / 0 % (-) / 0 %, - | 0 / 0 % (-) / 0 %, - | 0 / 0 % (-) / 0 %, - |
| 20 deg | 30 / 0 % (-) / 0 %, - | 20 / 0 % (-) / 0 %, - | 10 / 0 % (-) / 0 %, - | 10 / 0 % (-) / 0 %, - |
| 25 deg | 100 / - (-) / -, - | 100 / - (-) / 100 %, - | 100 / - (-) / 100 %, - | 90 / 0 % (-) / 86 %, - |
| 30 deg | 100 / - (-) / -, - | 100 / - (-) / -, - | 100 / - (-) / -, - | 100 / - (-) / -, - |
| 35 deg | 100 / - (-) / -, - | 100 / - (-) / -, - | 100 / - (-) / -, - | 100 / - (-) / -, - |
| 40 deg | 100 / - (-) / -, - | 100 / - (-) / -, - | 100 / - (-) / -, - | 100 / - (-) / -, - |
| 45 deg | 100 / - (-) / -, - | 100 / - (-) / -, - | 100 / - (-) / -, - | 100 / - (-) / -, - |

### tilt_s2, standing 12 s: fell % / still % (settle s)

| tilt | nose down | diagonal | sideways | nose up |
|---|---|---|---|---|
| 0 deg | 0 / 0 % (-) | 0 / 0 % (-) | 0 / 0 % (-) | 0 / 0 % (-) |
| 5 deg | 0 / 0 % (-) | 0 / 0 % (-) | 0 / 0 % (-) | 0 / 0 % (-) |
| 10 deg | 0 / 0 % (-) | 0 / 0 % (-) | 0 / 0 % (-) | 0 / 0 % (-) |
| 15 deg | 10 / 0 % (-) | 0 / 0 % (-) | 0 / 0 % (-) | 0 / 0 % (-) |
| 20 deg | 60 / 0 % (-) | 40 / 0 % (-) | 30 / 0 % (-) | 30 / 0 % (-) |
| 25 deg | 100 / - (-) | 100 / - (-) | 100 / - (-) | 60 / 0 % (-) |
| 30 deg | 100 / - (-) | 100 / - (-) | 100 / - (-) | 100 / - (-) |
| 35 deg | 100 / - (-) | 100 / - (-) | 100 / - (-) | 100 / - (-) |
| 40 deg | 100 / - (-) | 100 / - (-) | 100 / - (-) | 100 / - (-) |
| 45 deg | 100 / - (-) | 100 / - (-) | 100 / - (-) | 100 / - (-) |

### tilt_s2, shoved 0.3 m/s at 6 s: fell % / still % (settle s) / after the shove: fell %, resettle s

| tilt | nose down | diagonal | sideways | nose up |
|---|---|---|---|---|
| 0 deg | 0 / 0 % (-) / 0 %, - | 0 / 0 % (-) / 0 %, - | 0 / 0 % (-) / 0 %, - | 0 / 0 % (-) / 0 %, - |
| 5 deg | 0 / 0 % (-) / 0 %, - | 0 / 0 % (-) / 0 %, - | 0 / 0 % (-) / 0 %, - | 0 / 0 % (-) / 0 %, - |
| 10 deg | 0 / 0 % (-) / 0 %, - | 0 / 0 % (-) / 0 %, - | 0 / 0 % (-) / 0 %, - | 0 / 0 % (-) / 0 %, - |
| 15 deg | 0 / 0 % (-) / 0 %, - | 0 / 0 % (-) / 0 %, - | 0 / 0 % (-) / 0 %, - | 0 / 0 % (-) / 0 %, - |
| 20 deg | 50 / 0 % (-) / 0 %, - | 70 / 0 % (-) / 25 %, - | 60 / 0 % (-) / 20 %, - | 30 / 0 % (-) / 0 %, - |
| 25 deg | 100 / - (-) / -, - | 100 / - (-) / -, - | 100 / - (-) / -, - | 70 / 0 % (-) / 57 %, - |
| 30 deg | 100 / - (-) / -, - | 100 / - (-) / -, - | 100 / - (-) / -, - | 100 / - (-) / -, - |
| 35 deg | 100 / - (-) / -, - | 100 / - (-) / -, - | 100 / - (-) / -, - | 100 / - (-) / -, - |
| 40 deg | 100 / - (-) / -, - | 100 / - (-) / -, - | 100 / - (-) / -, - | 100 / - (-) / -, - |
| 45 deg | 100 / - (-) / -, - | 100 / - (-) / -, - | 100 / - (-) / -, - | 100 / - (-) / -, - |

## Stairs goal test (clean = reached without any fall, open sides)

| dog | mean clean | up | down | limits up (treads 25-9) | limits down |
|---|---|---|---|---|---|
| free_s2 | 0.378 | 0.439 | 0.317 | 5 / 4 / 4 / 3 / 2 | 3 / 3 / 2 / 1 / 1 |
| amp_w6m_slow_s1 | 0.289 | 0.388 | 0.191 | 3 / 2 / 4 / 2 / 2 | 2 / 2 / 2 / 1 / 1 |
| still_s1 | 0.378 | 0.433 | 0.322 | 5 / 4 / 4 / 3 / 2 | 3 / 2 / 2 / 1 / 1 |
| still_s2 | 0.359 | 0.434 | 0.283 | 5 / 4 / 4 / 3 / 3 | 3 / 3 / 2 / 1 / 1 |
| tilt_s1 | 0.351 | 0.415 | 0.286 | 4 / 3 / 4 / 3 / 2 | 3 / 2 / 2 / 1 / 1 |
| tilt_s2 | 0.352 | 0.427 | 0.276 | 5 / 4 / 4 / 3 / 3 | 3 / 2 / 2 / 1 / 1 |

## Walking (falls, walk score)

| dog | forward | course | stairs straight | power |
|---|---|---|---|---|
| free_s2 | 1.0 % (0.46) | 0.7 % (0.43) | 1.8 % (0.45) | 12.9 W |
| still_s1 | 0.8 % (0.44) | 1.2 % (0.43) | 2.1 % (0.43) | 12.9 W |
| still_s2 | 1.6 % (0.44) | 0.7 % (0.42) | 1.9 % (0.44) | 12.9 W |
| tilt_s1 | 1.3 % (0.45) | 0.7 % (0.42) | 1.8 % (0.44) | 13.3 W |
| tilt_s2 | 0.9 % (0.44) | 0.4 % (0.43) | 1.9 % (0.43) | 12.8 W |

One shove while walking (stays up / gets up / stays down):

| dog | 0.3 m/s | 0.5 m/s | 0.7 m/s | 0.9 m/s | 1.1 m/s | 1.3 m/s | 1.5 m/s |
|---|---|---|---|---|---|---|---|
| free_s2 | 99 / 1 / 0 % | 77 / 23 / 0 % | 69 / 31 / 0 % | 64 / 36 / 0 % | 39 / 61 / 0 % | 20 / 80 / 0 % | 2 / 97 / 1 % |
| still_s1 | 100 / 0 / 0 % | 80 / 20 / 0 % | 64 / 36 / 0 % | 44 / 56 / 0 % | 40 / 60 / 1 % | 23 / 75 / 2 % | 5 / 93 / 2 % |
| still_s2 | 98 / 2 / 0 % | 84 / 16 / 0 % | 68 / 32 / 0 % | 64 / 36 / 0 % | 42 / 57 / 1 % | 22 / 75 / 3 % | 3 / 92 / 5 % |
| tilt_s1 | 100 / 0 / 0 % | 76 / 24 / 0 % | 66 / 34 / 0 % | 62 / 38 / 0 % | 44 / 55 / 1 % | 23 / 75 / 1 % | 2 / 98 / 0 % |
| tilt_s2 | 99 / 1 / 0 % | 82 / 18 / 0 % | 61 / 39 / 0 % | 48 / 51 / 1 % | 30 / 64 / 6 % | 3 / 91 / 6 % | 0 / 92 / 8 % |

Getting up within 8 s:

| dog | standing | dropped upright | on its side | on its back |
|---|---|---|---|---|
| free_s2 | 100 % | 100 % | 100 % | 100 % |
| still_s1 | 100 % | 100 % | 100 % | 100 % |
| still_s2 | 100 % | 100 % | 100 % | 100 % |
| tilt_s1 | 46 % | 83 % | 100 % | 100 % |
| tilt_s2 | 31 % | 88 % | 100 % | 100 % |

Best per variant: {"still": ["still_s1", 0.0], "tilt": ["tilt_s1", 0.0], "start free_s2": 0.0}

Videos: `videos/compare_down_r4_t15.mp4`, `videos/compare_stand_flat.mp4`, `videos/compare_tilt20_nose_down.mp4`, `videos/compare_tilt25_nose_up.mp4`, `videos/compare_tilt25_sideways.mp4`
