ossehaas/Robot-Evolution-Lab/runs/exp2_dog/22_still_clock/results.md

# Base skills B1 + B2 with the gait clock stopped while standing (step 44)

## Pass / fail (`.documentation/base-skills.md`)

B1 on the flat: still >= 90 % of the time after 2 s, still within 2 s, moves < 2 cm in 10 s. B2 on plates up to 15 deg (nose down, diagonal) / 20 deg (sideways, nose up): never falls, still >= 80 %; after a 0.3 m/s shove no fall and still again within 3 s.

| dog | B1 still (flat) | settle | moved | power | B1 | B2 worst still | B2 falls | after shove: falls / resettle | B2 |
|---|---|---|---|---|---|---|---|---|---|
| free_s2 (clock runs, step 43) | 0 % | never | 8.7 cm | 1.96 W | FAIL | 0 % | 10 % | 0 % / never | FAIL |
| still_s1 (step 43) | 0 % | never | 9.5 cm | 1.87 W | FAIL | 0 % | 10 % | 0 % / never | FAIL |
| free_s2 (gait_clock_idle=hold) | 38 % | never | 0.1 cm | 0.15 W | FAIL | 0 % | 10 % | 0 % / never | FAIL |
| free_s2 (gait_clock_idle=zero) | 2 % | never | 0.9 cm | 0.25 W | FAIL | 0 % | 20 % | 0 % / never | FAIL |
| hold_s1 | 33 % | never | 0.1 cm | 0.12 W | FAIL | 0 % | 20 % | 0 % / never | FAIL |
| zero_s1 | 14 % | never | 2.6 cm | 0.32 W | FAIL | 0 % | 10 % | 0 % / never | FAIL |
| hold_s2 | 41 % | never | 0.1 cm | 0.11 W | FAIL | 0 % | 10 % | 0 % / never | FAIL |
| zero_s2 | 7 % | never | 0.5 cm | 0.30 W | FAIL | 0 % | 30 % | 0 % / never | FAIL |

### free_s2 (clock runs, step 43), standing 12 s: fell % / still % (settle s)

| tilt | nose down | diagonal | sideways | nose up |
|---|---|---|---|---|
| 0 deg | 0 / 0 % (-) | 0 / 0 % (-) | 0 / 0 % (-) | 0 / 0 % (-) |
| 5 deg | 0 / 0 % (-) | 0 / 0 % (-) | 0 / 0 % (-) | 0 / 0 % (-) |
| 10 deg | 0 / 0 % (-) | 0 / 0 % (-) | 0 / 0 % (-) | 0 / 0 % (-) |
| 15 deg | 0 / 0 % (-) | 0 / 0 % (-) | 0 / 0 % (-) | 0 / 0 % (-) |
| 20 deg | 30 / 0 % (-) | 10 / 0 % (-) | 0 / 0 % (-) | 10 / 0 % (-) |
| 25 deg | 90 / 0 % (-) | 100 / - (-) | 100 / - (-) | 30 / 0 % (-) |
| 30 deg | 100 / - (-) | 100 / - (-) | 100 / - (-) | 100 / - (-) |
| 35 deg | 100 / - (-) | 100 / - (-) | 100 / - (-) | 100 / - (-) |
| 40 deg | 100 / - (-) | 100 / - (-) | 100 / - (-) | 100 / - (-) |
| 45 deg | 100 / - (-) | 100 / - (-) | 100 / - (-) | 100 / - (-) |

### free_s2 (clock runs, step 43), shoved 0.3 m/s at 6 s: fell % / still % (settle s) / after the shove: fell %, resettle s

| tilt | nose down | diagonal | sideways | nose up |
|---|---|---|---|---|
| 0 deg | 0 / 0 % (-) / 0 %, - | 0 / 0 % (-) / 0 %, - | 0 / 0 % (-) / 0 %, - | 0 / 0 % (-) / 0 %, - |
| 5 deg | 0 / 0 % (-) / 0 %, - | 0 / 0 % (-) / 0 %, - | 0 / 0 % (-) / 0 %, - | 0 / 0 % (-) / 0 %, - |
| 10 deg | 0 / 0 % (-) / 0 %, - | 0 / 0 % (-) / 0 %, - | 0 / 0 % (-) / 0 %, - | 0 / 0 % (-) / 0 %, - |
| 15 deg | 0 / 0 % (-) / 0 %, - | 0 / 0 % (-) / 0 %, - | 0 / 0 % (-) / 0 %, - | 0 / 0 % (-) / 0 %, - |
| 20 deg | 10 / 0 % (-) / 0 %, - | 10 / 0 % (-) / 0 %, - | 0 / 0 % (-) / 0 %, - | 10 / 0 % (-) / 0 %, - |
| 25 deg | 100 / - (-) / -, - | 100 / - (-) / -, - | 100 / - (-) / 100 %, - | 40 / 0 % (-) / 25 %, - |
| 30 deg | 100 / - (-) / -, - | 100 / - (-) / -, - | 100 / - (-) / -, - | 100 / - (-) / -, - |
| 35 deg | 100 / - (-) / -, - | 100 / - (-) / -, - | 100 / - (-) / -, - | 100 / - (-) / -, - |
| 40 deg | 100 / - (-) / -, - | 100 / - (-) / -, - | 100 / - (-) / -, - | 100 / - (-) / -, - |
| 45 deg | 100 / - (-) / -, - | 100 / - (-) / -, - | 100 / - (-) / -, - | 100 / - (-) / -, - |

### still_s1 (step 43), standing 12 s: fell % / still % (settle s)

| tilt | nose down | diagonal | sideways | nose up |
|---|---|---|---|---|
| 0 deg | 0 / 0 % (-) | 0 / 0 % (-) | 0 / 0 % (-) | 0 / 0 % (-) |
| 5 deg | 0 / 0 % (-) | 0 / 0 % (-) | 0 / 0 % (-) | 0 / 0 % (-) |
| 10 deg | 0 / 0 % (-) | 0 / 0 % (-) | 0 / 0 % (-) | 0 / 0 % (-) |
| 15 deg | 0 / 0 % (-) | 0 / 0 % (-) | 0 / 0 % (-) | 0 / 0 % (-) |
| 20 deg | 30 / 0 % (-) | 30 / 0 % (-) | 10 / 0 % (-) | 10 / 0 % (-) |
| 25 deg | 100 / - (-) | 100 / - (-) | 100 / - (-) | 70 / 0 % (-) |
| 30 deg | 100 / - (-) | 100 / - (-) | 100 / - (-) | 100 / - (-) |
| 35 deg | 100 / - (-) | 100 / - (-) | 100 / - (-) | 100 / - (-) |
| 40 deg | 100 / - (-) | 100 / - (-) | 100 / - (-) | 100 / - (-) |
| 45 deg | 100 / - (-) | 100 / - (-) | 100 / - (-) | 100 / - (-) |

### still_s1 (step 43), shoved 0.3 m/s at 6 s: fell % / still % (settle s) / after the shove: fell %, resettle s

| tilt | nose down | diagonal | sideways | nose up |
|---|---|---|---|---|
| 0 deg | 0 / 0 % (-) / 0 %, - | 0 / 0 % (-) / 0 %, - | 0 / 0 % (-) / 0 %, - | 0 / 0 % (-) / 0 %, - |
| 5 deg | 0 / 0 % (-) / 0 %, - | 0 / 0 % (-) / 0 %, - | 0 / 0 % (-) / 0 %, - | 0 / 0 % (-) / 0 %, - |
| 10 deg | 0 / 0 % (-) / 0 %, - | 0 / 0 % (-) / 0 %, - | 0 / 0 % (-) / 0 %, - | 0 / 0 % (-) / 0 %, - |
| 15 deg | 0 / 0 % (-) / 0 %, - | 0 / 0 % (-) / 0 %, - | 0 / 0 % (-) / 0 %, - | 0 / 0 % (-) / 0 %, - |
| 20 deg | 0 / 0 % (-) / 0 %, - | 20 / 0 % (-) / 0 %, - | 0 / 0 % (-) / 0 %, - | 20 / 0 % (-) / 0 %, - |
| 25 deg | 100 / - (-) / -, - | 100 / - (-) / -, - | 100 / - (-) / -, - | 50 / 0 % (-) / 44 %, - |
| 30 deg | 100 / - (-) / -, - | 100 / - (-) / -, - | 100 / - (-) / -, - | 100 / - (-) / -, - |
| 35 deg | 100 / - (-) / -, - | 100 / - (-) / -, - | 100 / - (-) / -, - | 100 / - (-) / -, - |
| 40 deg | 100 / - (-) / -, - | 100 / - (-) / -, - | 100 / - (-) / -, - | 100 / - (-) / -, - |
| 45 deg | 100 / - (-) / -, - | 100 / - (-) / -, - | 100 / - (-) / -, - | 100 / - (-) / -, - |

### free_s2 (gait_clock_idle=hold), standing 12 s: fell % / still % (settle s)

| tilt | nose down | diagonal | sideways | nose up |
|---|---|---|---|---|
| 0 deg | 0 / 39 % (-) | 0 / 38 % (-) | 0 / 38 % (-) | 0 / 38 % (-) |
| 5 deg | 0 / 0 % (-) | 0 / 7 % (-) | 0 / 30 % (-) | 0 / 36 % (-) |
| 10 deg | 0 / 4 % (-) | 0 / 7 % (-) | 0 / 17 % (-) | 0 / 26 % (-) |
| 15 deg | 0 / 1 % (-) | 0 / 14 % (-) | 0 / 20 % (-) | 0 / 11 % (-) |
| 20 deg | 20 / 0 % (-) | 30 / 3 % (-) | 0 / 15 % (-) | 10 / 3 % (-) |
| 25 deg | 100 / - (-) | 100 / - (-) | 100 / - (-) | 50 / 3 % (-) |
| 30 deg | 100 / - (-) | 100 / - (-) | 100 / - (-) | 100 / - (-) |
| 35 deg | 100 / - (-) | 100 / - (-) | 100 / - (-) | 100 / - (-) |
| 40 deg | 100 / - (-) | 100 / - (-) | 100 / - (-) | 100 / - (-) |
| 45 deg | 100 / - (-) | 100 / - (-) | 100 / - (-) | 100 / - (-) |

### free_s2 (gait_clock_idle=hold), shoved 0.3 m/s at 6 s: fell % / still % (settle s) / after the shove: fell %, resettle s

| tilt | nose down | diagonal | sideways | nose up |
|---|---|---|---|---|
| 0 deg | 0 / 38 % (-) / 0 %, - | 0 / 37 % (-) / 0 %, - | 0 / 36 % (-) / 0 %, - | 0 / 34 % (-) / 0 %, - |
| 5 deg | 0 / 0 % (-) / 0 %, - | 0 / 2 % (-) / 0 %, - | 0 / 28 % (-) / 0 %, - | 0 / 36 % (-) / 0 %, - |
| 10 deg | 0 / 4 % (-) / 0 %, - | 0 / 9 % (-) / 0 %, - | 0 / 14 % (-) / 0 %, - | 0 / 28 % (-) / 0 %, - |
| 15 deg | 0 / 2 % (-) / 0 %, - | 0 / 14 % (-) / 0 %, - | 0 / 20 % (-) / 0 %, - | 0 / 10 % (-) / 0 %, - |
| 20 deg | 0 / 0 % (-) / 0 %, - | 30 / 1 % (-) / 0 %, - | 0 / 14 % (-) / 0 %, - | 20 / 1 % (-) / 0 %, - |
| 25 deg | 100 / - (-) / -, - | 90 / 1 % (-) / 0 %, - | 100 / - (-) / 100 %, - | 30 / 2 % (-) / 0 %, - |
| 30 deg | 100 / - (-) / -, - | 100 / - (-) / -, - | 100 / - (-) / -, - | 100 / - (-) / -, - |
| 35 deg | 100 / - (-) / -, - | 100 / - (-) / -, - | 100 / - (-) / -, - | 100 / - (-) / -, - |
| 40 deg | 100 / - (-) / -, - | 100 / - (-) / -, - | 100 / - (-) / -, - | 100 / - (-) / -, - |
| 45 deg | 100 / - (-) / -, - | 100 / - (-) / -, - | 100 / - (-) / -, - | 100 / - (-) / -, - |

### free_s2 (gait_clock_idle=zero), standing 12 s: fell % / still % (settle s)

| tilt | nose down | diagonal | sideways | nose up |
|---|---|---|---|---|
| 0 deg | 0 / 2 % (-) | 0 / 2 % (-) | 0 / 2 % (-) | 0 / 2 % (-) |
| 5 deg | 0 / 1 % (-) | 0 / 1 % (-) | 0 / 6 % (-) | 0 / 34 % (-) |
| 10 deg | 0 / 8 % (-) | 0 / 14 % (-) | 0 / 20 % (-) | 0 / 27 % (-) |
| 15 deg | 10 / 7 % (-) | 0 / 19 % (-) | 0 / 12 % (-) | 0 / 12 % (-) |
| 20 deg | 20 / 5 % (-) | 10 / 3 % (-) | 10 / 18 % (-) | 20 / 0 % (-) |
| 25 deg | 100 / - (-) | 100 / - (-) | 90 / 0 % (-) | 60 / 0 % (-) |
| 30 deg | 100 / - (-) | 100 / - (-) | 100 / - (-) | 100 / - (-) |
| 35 deg | 100 / - (-) | 100 / - (-) | 100 / - (-) | 100 / - (-) |
| 40 deg | 100 / - (-) | 100 / - (-) | 100 / - (-) | 100 / - (-) |
| 45 deg | 100 / - (-) | 100 / - (-) | 100 / - (-) | 100 / - (-) |

### free_s2 (gait_clock_idle=zero), shoved 0.3 m/s at 6 s: fell % / still % (settle s) / after the shove: fell %, resettle s

| tilt | nose down | diagonal | sideways | nose up |
|---|---|---|---|---|
| 0 deg | 0 / 2 % (-) / 0 %, - | 0 / 2 % (-) / 0 %, - | 0 / 2 % (-) / 0 %, - | 0 / 2 % (-) / 0 %, - |
| 5 deg | 0 / 0 % (-) / 0 %, - | 0 / 2 % (-) / 0 %, - | 0 / 13 % (-) / 0 %, - | 0 / 33 % (-) / 0 %, - |
| 10 deg | 0 / 9 % (-) / 0 %, - | 0 / 13 % (-) / 0 %, - | 0 / 22 % (-) / 0 %, - | 0 / 29 % (-) / 0 %, - |
| 15 deg | 0 / 10 % (-) / 0 %, - | 0 / 15 % (-) / 0 %, - | 0 / 14 % (-) / 0 %, - | 0 / 10 % (-) / 0 %, - |
| 20 deg | 30 / 0 % (-) / 0 %, - | 0 / 3 % (-) / 0 %, - | 0 / 16 % (-) / 0 %, - | 30 / 0 % (-) / 0 %, - |
| 25 deg | 90 / 1 % (-) / 0 %, - | 100 / - (-) / -, - | 60 / 4 % (-) / 43 %, - | 70 / 0 % (-) / 57 %, - |
| 30 deg | 100 / - (-) / -, - | 100 / - (-) / -, - | 100 / - (-) / -, - | 100 / - (-) / -, - |
| 35 deg | 100 / - (-) / -, - | 100 / - (-) / -, - | 100 / - (-) / -, - | 100 / - (-) / -, - |
| 40 deg | 100 / - (-) / -, - | 100 / - (-) / -, - | 100 / - (-) / -, - | 100 / - (-) / -, - |
| 45 deg | 100 / - (-) / -, - | 100 / - (-) / -, - | 100 / - (-) / -, - | 100 / - (-) / -, - |

### hold_s1, standing 12 s: fell % / still % (settle s)

| tilt | nose down | diagonal | sideways | nose up |
|---|---|---|---|---|
| 0 deg | 0 / 33 % (-) | 0 / 34 % (-) | 0 / 32 % (-) | 0 / 32 % (-) |
| 5 deg | 0 / 0 % (-) | 0 / 0 % (-) | 0 / 29 % (-) | 0 / 30 % (-) |
| 10 deg | 0 / 1 % (-) | 0 / 4 % (-) | 0 / 6 % (-) | 0 / 22 % (-) |
| 15 deg | 0 / 0 % (-) | 0 / 5 % (-) | 0 / 11 % (-) | 0 / 16 % (-) |
| 20 deg | 80 / 0 % (-) | 60 / 0 % (-) | 10 / 6 % (-) | 20 / 1 % (-) |
| 25 deg | 100 / - (-) | 100 / - (-) | 100 / - (-) | 30 / 0 % (-) |
| 30 deg | 100 / - (-) | 100 / - (-) | 100 / - (-) | 100 / - (-) |
| 35 deg | 100 / - (-) | 100 / - (-) | 100 / - (-) | 100 / - (-) |
| 40 deg | 100 / - (-) | 100 / - (-) | 100 / - (-) | 100 / - (-) |
| 45 deg | 100 / - (-) | 100 / - (-) | 100 / - (-) | 100 / - (-) |

### hold_s1, shoved 0.3 m/s at 6 s: fell % / still % (settle s) / after the shove: fell %, resettle s

| tilt | nose down | diagonal | sideways | nose up |
|---|---|---|---|---|
| 0 deg | 0 / 33 % (-) / 0 %, - | 0 / 32 % (-) / 0 %, - | 0 / 33 % (-) / 0 %, - | 0 / 30 % (-) / 0 %, - |
| 5 deg | 0 / 1 % (-) / 0 %, - | 0 / 0 % (-) / 0 %, - | 0 / 26 % (-) / 0 %, - | 0 / 29 % (-) / 0 %, - |
| 10 deg | 0 / 1 % (-) / 0 %, - | 0 / 5 % (-) / 0 %, - | 0 / 8 % (-) / 0 %, - | 0 / 21 % (-) / 0 %, - |
| 15 deg | 10 / 0 % (-) / 0 %, - | 0 / 5 % (-) / 0 %, - | 0 / 10 % (-) / 0 %, - | 0 / 13 % (-) / 0 %, - |
| 20 deg | 70 / 0 % (-) / 0 %, - | 90 / 0 % (-) / 67 %, - | 0 / 6 % (-) / 0 %, - | 50 / 2 % (-) / 0 %, - |
| 25 deg | 100 / - (-) / -, - | 100 / - (-) / -, - | 100 / - (-) / -, - | 30 / 0 % (-) / 0 %, - |
| 30 deg | 100 / - (-) / -, - | 100 / - (-) / -, - | 100 / - (-) / -, - | 100 / - (-) / -, - |
| 35 deg | 100 / - (-) / -, - | 100 / - (-) / -, - | 100 / - (-) / -, - | 100 / - (-) / -, - |
| 40 deg | 100 / - (-) / -, - | 100 / - (-) / -, - | 100 / - (-) / -, - | 100 / - (-) / -, - |
| 45 deg | 100 / - (-) / -, - | 100 / - (-) / -, - | 100 / - (-) / -, - | 100 / - (-) / -, - |

### zero_s1, standing 12 s: fell % / still % (settle s)

| tilt | nose down | diagonal | sideways | nose up |
|---|---|---|---|---|
| 0 deg | 0 / 12 % (-) | 0 / 11 % (-) | 0 / 18 % (-) | 0 / 13 % (-) |
| 5 deg | 0 / 11 % (-) | 0 / 21 % (-) | 0 / 55 % (-) | 0 / 26 % (-) |
| 10 deg | 0 / 18 % (-) | 0 / 25 % (-) | 0 / 26 % (-) | 0 / 23 % (-) |
| 15 deg | 0 / 6 % (-) | 0 / 8 % (-) | 0 / 24 % (-) | 0 / 12 % (-) |
| 20 deg | 40 / 0 % (-) | 10 / 0 % (-) | 0 / 11 % (-) | 10 / 0 % (-) |
| 25 deg | 100 / - (-) | 100 / - (-) | 70 / 1 % (-) | 20 / 0 % (-) |
| 30 deg | 100 / - (-) | 100 / - (-) | 100 / - (-) | 100 / - (-) |
| 35 deg | 100 / - (-) | 100 / - (-) | 100 / - (-) | 100 / - (-) |
| 40 deg | 100 / - (-) | 100 / - (-) | 100 / - (-) | 100 / - (-) |
| 45 deg | 100 / - (-) | 100 / - (-) | 100 / - (-) | 100 / - (-) |

### zero_s1, shoved 0.3 m/s at 6 s: fell % / still % (settle s) / after the shove: fell %, resettle s

| tilt | nose down | diagonal | sideways | nose up |
|---|---|---|---|---|
| 0 deg | 0 / 18 % (-) / 0 %, - | 0 / 17 % (-) / 0 %, - | 0 / 18 % (-) / 0 %, - | 0 / 17 % (-) / 0 %, - |
| 5 deg | 0 / 10 % (-) / 0 %, - | 0 / 26 % (-) / 0 %, - | 0 / 52 % (-) / 0 %, - | 0 / 27 % (-) / 0 %, - |
| 10 deg | 0 / 16 % (-) / 0 %, - | 0 / 27 % (-) / 0 %, - | 0 / 25 % (-) / 0 %, - | 0 / 23 % (-) / 0 %, - |
| 15 deg | 0 / 6 % (-) / 0 %, - | 0 / 6 % (-) / 0 %, - | 0 / 20 % (-) / 0 %, - | 0 / 12 % (-) / 0 %, - |
| 20 deg | 30 / 0 % (-) / 0 %, - | 10 / 0 % (-) / 0 %, - | 0 / 10 % (-) / 0 %, - | 20 / 0 % (-) / 0 %, - |
| 25 deg | 100 / - (-) / -, - | 100 / - (-) / -, - | 70 / 1 % (-) / 25 %, - | 50 / 1 % (-) / 0 %, - |
| 30 deg | 100 / - (-) / -, - | 100 / - (-) / -, - | 100 / - (-) / -, - | 100 / - (-) / -, - |
| 35 deg | 100 / - (-) / -, - | 100 / - (-) / -, - | 100 / - (-) / -, - | 100 / - (-) / -, - |
| 40 deg | 100 / - (-) / -, - | 100 / - (-) / -, - | 100 / - (-) / -, - | 100 / - (-) / -, - |
| 45 deg | 100 / - (-) / -, - | 100 / - (-) / -, - | 100 / - (-) / -, - | 100 / - (-) / -, - |

### hold_s2, standing 12 s: fell % / still % (settle s)

| tilt | nose down | diagonal | sideways | nose up |
|---|---|---|---|---|
| 0 deg | 0 / 42 % (-) | 0 / 43 % (-) | 0 / 39 % (-) | 0 / 42 % (-) |
| 5 deg | 0 / 0 % (-) | 0 / 0 % (-) | 0 / 42 % (-) | 0 / 34 % (-) |
| 10 deg | 0 / 12 % (-) | 0 / 3 % (-) | 0 / 10 % (-) | 0 / 24 % (-) |
| 15 deg | 0 / 0 % (-) | 0 / 5 % (-) | 0 / 12 % (-) | 0 / 12 % (-) |
| 20 deg | 50 / 0 % (-) | 60 / 0 % (-) | 10 / 6 % (-) | 10 / 2 % (-) |
| 25 deg | 100 / - (-) | 100 / - (-) | 100 / - (-) | 30 / 0 % (-) |
| 30 deg | 100 / - (-) | 100 / - (-) | 100 / - (-) | 100 / - (-) |
| 35 deg | 100 / - (-) | 100 / - (-) | 100 / - (-) | 100 / - (-) |
| 40 deg | 100 / - (-) | 100 / - (-) | 100 / - (-) | 100 / - (-) |
| 45 deg | 100 / - (-) | 100 / - (-) | 100 / - (-) | 100 / - (-) |

### hold_s2, shoved 0.3 m/s at 6 s: fell % / still % (settle s) / after the shove: fell %, resettle s

| tilt | nose down | diagonal | sideways | nose up |
|---|---|---|---|---|
| 0 deg | 0 / 39 % (-) / 0 %, - | 0 / 40 % (-) / 0 %, - | 0 / 40 % (-) / 0 %, - | 0 / 41 % (-) / 0 %, - |
| 5 deg | 0 / 1 % (-) / 0 %, - | 0 / 2 % (-) / 0 %, - | 0 / 33 % (-) / 0 %, - | 0 / 33 % (-) / 0 %, - |
| 10 deg | 0 / 11 % (-) / 0 %, - | 0 / 4 % (-) / 0 %, - | 0 / 10 % (-) / 0 %, - | 0 / 22 % (-) / 0 %, - |
| 15 deg | 0 / 0 % (-) / 0 %, - | 0 / 5 % (-) / 0 %, - | 0 / 12 % (-) / 0 %, - | 0 / 11 % (-) / 0 %, - |
| 20 deg | 60 / 0 % (-) / 0 %, - | 80 / 0 % (-) / 33 %, - | 10 / 5 % (-) / 0 %, - | 10 / 1 % (-) / 0 %, - |
| 25 deg | 100 / - (-) / -, - | 100 / - (-) / -, - | 100 / - (-) / 100 %, - | 30 / 0 % (-) / 12 %, - |
| 30 deg | 100 / - (-) / -, - | 100 / - (-) / -, - | 100 / - (-) / -, - | 100 / - (-) / -, - |
| 35 deg | 100 / - (-) / -, - | 100 / - (-) / -, - | 100 / - (-) / -, - | 100 / - (-) / -, - |
| 40 deg | 100 / - (-) / -, - | 100 / - (-) / -, - | 100 / - (-) / -, - | 100 / - (-) / -, - |
| 45 deg | 100 / - (-) / -, - | 100 / - (-) / -, - | 100 / - (-) / -, - | 100 / - (-) / -, - |

### zero_s2, standing 12 s: fell % / still % (settle s)

| tilt | nose down | diagonal | sideways | nose up |
|---|---|---|---|---|
| 0 deg | 0 / 6 % (-) | 0 / 6 % (-) | 0 / 6 % (-) | 0 / 8 % (-) |
| 5 deg | 0 / 2 % (-) | 0 / 1 % (-) | 0 / 23 % (-) | 0 / 26 % (-) |
| 10 deg | 0 / 14 % (-) | 0 / 17 % (-) | 0 / 19 % (-) | 0 / 22 % (-) |
| 15 deg | 0 / 6 % (-) | 0 / 5 % (-) | 0 / 17 % (-) | 0 / 15 % (-) |
| 20 deg | 30 / 1 % (-) | 60 / 1 % (-) | 0 / 12 % (-) | 30 / 0 % (-) |
| 25 deg | 100 / - (-) | 100 / - (-) | 30 / 4 % (-) | 20 / 2 % (-) |
| 30 deg | 100 / - (-) | 100 / - (-) | 100 / - (-) | 90 / 0 % (-) |
| 35 deg | 100 / - (-) | 100 / - (-) | 100 / - (-) | 100 / - (-) |
| 40 deg | 100 / - (-) | 100 / - (-) | 100 / - (-) | 100 / - (-) |
| 45 deg | 100 / - (-) | 100 / - (-) | 100 / - (-) | 100 / - (-) |

### zero_s2, shoved 0.3 m/s at 6 s: fell % / still % (settle s) / after the shove: fell %, resettle s

| tilt | nose down | diagonal | sideways | nose up |
|---|---|---|---|---|
| 0 deg | 0 / 9 % (-) / 0 %, - | 0 / 9 % (-) / 0 %, - | 0 / 10 % (-) / 0 %, - | 0 / 14 % (-) / 0 %, - |
| 5 deg | 0 / 4 % (-) / 0 %, - | 0 / 4 % (-) / 0 %, - | 0 / 25 % (-) / 0 %, - | 0 / 25 % (-) / 0 %, - |
| 10 deg | 0 / 11 % (-) / 0 %, - | 0 / 19 % (-) / 0 %, - | 0 / 20 % (-) / 0 %, - | 0 / 22 % (-) / 0 %, - |
| 15 deg | 0 / 4 % (-) / 0 %, - | 0 / 7 % (-) / 0 %, - | 0 / 19 % (-) / 0 %, - | 0 / 13 % (-) / 0 %, - |
| 20 deg | 50 / 0 % (-) / 0 %, - | 60 / 0 % (-) / 20 %, - | 10 / 10 % (-) / 0 %, - | 10 / 1 % (-) / 0 %, - |
| 25 deg | 100 / - (-) / -, - | 90 / 0 % (-) / 0 %, - | 30 / 4 % (-) / 0 %, - | 60 / 2 % (-) / 0 %, - |
| 30 deg | 100 / - (-) / -, - | 100 / - (-) / -, - | 100 / - (-) / -, - | 90 / 0 % (-) / 0 %, - |
| 35 deg | 100 / - (-) / -, - | 100 / - (-) / -, - | 100 / - (-) / -, - | 100 / - (-) / -, - |
| 40 deg | 100 / - (-) / -, - | 100 / - (-) / -, - | 100 / - (-) / -, - | 100 / - (-) / -, - |
| 45 deg | 100 / - (-) / -, - | 100 / - (-) / -, - | 100 / - (-) / -, - | 100 / - (-) / -, - |

## Stairs goal test (clean = reached without any fall, open sides)

| dog | mean clean | up | down | limits up (treads 25-9) | limits down |
|---|---|---|---|---|---|
| free_s2 | 0.378 | 0.439 | 0.317 | 5 / 4 / 4 / 3 / 2 | 3 / 3 / 2 / 1 / 1 |
| still_s1 | 0.378 | 0.433 | 0.322 | 5 / 4 / 4 / 3 / 2 | 3 / 2 / 2 / 1 / 1 |
| still_s2 | 0.359 | 0.434 | 0.283 | 5 / 4 / 4 / 3 / 3 | 3 / 3 / 2 / 1 / 1 |
| hold_s1 | 0.376 | 0.422 | 0.330 | 4 / 4 / 4 / 3 / 2 | 3 / 2 / 2 / 1 / 1 |
| hold_s2 | 0.363 | 0.414 | 0.312 | 4 / 4 / 3 / 3 / 2 | 3 / 2 / 2 / 1 / 1 |
| zero_s1 | 0.380 | 0.427 | 0.332 | 5 / 4 / 4 / 3 / 2 | 3 / 2 / 2 / 1 / 1 |
| zero_s2 | 0.375 | 0.428 | 0.322 | 4 / 4 / 3 / 2 / 2 | 3 / 2 / 2 / 2 / 1 |

## Walking (falls, walk score)

| dog | forward | course | stairs straight | power |
|---|---|---|---|---|
| free_s2 | 1.0 % (0.46) | 0.7 % (0.43) | 1.8 % (0.45) | 12.9 W |
| still_s1 | 0.8 % (0.44) | 1.2 % (0.43) | 2.1 % (0.43) | 12.9 W |
| still_s2 | 1.6 % (0.44) | 0.7 % (0.42) | 1.9 % (0.44) | 12.9 W |
| hold_s1 | 1.0 % (0.45) | 1.3 % (0.43) | 2.3 % (0.43) | 12.7 W |
| hold_s2 | 1.1 % (0.45) | 1.4 % (0.43) | 0.9 % (0.44) | 12.6 W |
| zero_s1 | 0.8 % (0.45) | 0.8 % (0.43) | 1.1 % (0.44) | 12.9 W |
| zero_s2 | 0.6 % (0.44) | 0.6 % (0.43) | 1.0 % (0.44) | 12.3 W |

One shove while walking (stays up / gets up / stays down):

| dog | 0.3 m/s | 0.5 m/s | 0.7 m/s | 0.9 m/s | 1.1 m/s | 1.3 m/s | 1.5 m/s |
|---|---|---|---|---|---|---|---|
| free_s2 | 99 / 1 / 0 % | 77 / 23 / 0 % | 69 / 31 / 0 % | 64 / 36 / 0 % | 39 / 61 / 0 % | 20 / 80 / 0 % | 2 / 97 / 1 % |
| still_s1 | 100 / 0 / 0 % | 80 / 20 / 0 % | 64 / 36 / 0 % | 44 / 56 / 0 % | 40 / 60 / 1 % | 23 / 75 / 2 % | 5 / 93 / 2 % |
| still_s2 | 98 / 2 / 0 % | 84 / 16 / 0 % | 68 / 32 / 0 % | 64 / 36 / 0 % | 42 / 57 / 1 % | 22 / 75 / 3 % | 3 / 92 / 5 % |
| hold_s1 | 100 / 0 / 0 % | 83 / 17 / 0 % | 64 / 36 / 0 % | 47 / 53 / 0 % | 36 / 63 / 1 % | 3 / 93 / 3 % | 1 / 93 / 6 % |
| hold_s2 | 100 / 0 / 0 % | 93 / 7 / 0 % | 64 / 36 / 0 % | 50 / 49 / 1 % | 35 / 62 / 3 % | 3 / 93 / 4 % | 0 / 91 / 9 % |
| zero_s1 | 100 / 0 / 0 % | 90 / 10 / 0 % | 66 / 34 / 0 % | 60 / 40 / 0 % | 34 / 66 / 1 % | 4 / 94 / 1 % | 0 / 97 / 3 % |
| zero_s2 | 100 / 0 / 0 % | 85 / 15 / 0 % | 73 / 27 / 0 % | 55 / 45 / 0 % | 36 / 64 / 0 % | 6 / 90 / 3 % | 0 / 95 / 5 % |

Getting up within 8 s:

| dog | standing | dropped upright | on its side | on its back |
|---|---|---|---|---|
| free_s2 | 100 % | 100 % | 100 % | 100 % |
| still_s1 | 100 % | 100 % | 100 % | 100 % |
| still_s2 | 100 % | 100 % | 100 % | 100 % |
| hold_s1 | 100 % | 100 % | 100 % | 100 % |
| hold_s2 | 99 % | 94 % | 100 % | 99 % |
| zero_s1 | 100 % | 100 % | 100 % | 100 % |
| zero_s2 | 100 % | 100 % | 100 % | 100 % |
| free_s2 (gait_clock_idle=hold) | 100 % | 100 % | 100 % | 100 % |

Best per variant: {"hold": ["hold_s2", 0.195], "zero": ["zero_s1", 0.197], "start free_s2": -1.0}

Videos: `videos/compare_down_r4_t15.mp4`, `videos/compare_stand_flat.mp4`, `videos/compare_stop_go.mp4`, `videos/compare_tilt15_nose_down.mp4`, `videos/compare_tilt15_sideways.mp4`
