ossehaas/Robot-Evolution-Lab/runs/exp2_dog/23_stairs_expert/results.md

# One model, many skills: the stairs-up expert on the frozen base zero_s1 (step 45)

## Weight shift, crawl and gate (lunge test, stairs up, cells with a plan)

Shift = body x minus the paws' centre while exactly one paw is up (plan: behind the paws with a front paw up, ahead with a rear paw up). Gate: before the zone (floor), in it, after it (landing / the way down), and the share of steps with the gate open on the walking course.

| dog | climbed | shift front cm (plan) | shift rear cm (plan) | 3 paws down | nose up | gate before / zone / after | gate open on course |
|---|---|---|---|---|---|---|---|
| zero_s1 | 0.86 | -1.5 (-4.8) | -0.3 (3.0) | 0.20 | 9 deg | - | - |
| plan_s1 | 0.86 | -1.4 (-4.8) | -0.2 (3.0) | 0.21 | 8 deg | 0.05 / 0.98 / 0.01 | 0.2 % |
| plan_s2 | 0.87 | -1.6 (-4.8) | -0.4 (3.0) | 0.20 | 9 deg | 0.04 / 0.99 / 0.02 | 0.2 % |
| own_s1 | 0.88 | -1.3 (-4.8) | -0.2 (3.0) | 0.20 | 8 deg | 0.03 / 0.97 / 0.02 | 0.2 % |
| own_s2 | 0.86 | -1.2 (-4.8) | -0.2 (3.0) | 0.22 | 9 deg | 0.05 / 0.98 / 0.02 | 0.3 % |

### zero_s1: per stairs (rise / tread cm): climbed, shift front / rear cm (plan), 3 paws down, gate in the zone

| rise | tread | climbed | shift front | shift rear | 3 down | gate zone |
|---|---|---|---|---|---|---|
| 1 | 25 | 1.00 | 0.4 (-5.1) | 1.0 (3.3) | 0.07 | - |
| 1 | 20 | 1.00 | 0.3 (-4.7) | 1.1 (3.2) | 0.11 | - |
| 1 | 15 | 1.00 | 0.4 (-4.8) | 0.7 (3.4) | 0.18 | - |
| 1 | 12 | 1.00 | 0.0 (-4.6) | 0.7 (3.2) | 0.17 | - |
| 1 | 9 | 1.00 | -0.5 (-5.2) | 0.5 (3.6) | 0.13 | - |
| 2 | 25 | 1.00 | -0.2 (-5.3) | 0.5 (3.3) | 0.20 | - |
| 2 | 20 | 1.00 | -0.3 (-4.7) | 0.5 (3.2) | 0.22 | - |
| 2 | 15 | 1.00 | -0.6 (-4.8) | 0.2 (3.4) | 0.15 | - |
| 2 | 12 | 1.00 | -0.8 (-4.5) | -0.1 (3.3) | 0.14 | - |
| 2 | 9 | 1.00 | -1.3 (-5.1) | -0.2 (3.6) | 0.12 | - |
| 3 | 25 | 1.00 | -0.9 (-5.0) | 0.1 (3.3) | 0.21 | - |
| 3 | 20 | 1.00 | -1.0 (-4.7) | -0.2 (3.1) | 0.19 | - |
| 3 | 15 | 1.00 | -1.8 (-4.4) | -0.7 (3.3) | 0.16 | - |
| 3 | 12 | 1.00 | -2.0 (-4.5) | -0.8 (3.3) | 0.13 | - |
| 3 | 9 | 1.00 | -2.3 (-5.3) | -0.9 (3.0) | 0.14 | - |
| 4 | 25 | 1.00 | -1.6 (-4.8) | -0.5 (3.3) | 0.18 | - |
| 4 | 20 | 0.90 | -1.4 (-4.7) | -1.1 (3.0) | 0.23 | - |
| 4 | 15 | 1.00 | -2.4 (-5.0) | -0.7 (2.8) | 0.18 | - |
| 4 | 12 | 1.00 | -2.8 (-5.0) | -0.9 (2.9) | 0.20 | - |
| 4 | 9 | 0.00 | -4.2 (-4.5) | -1.6 (2.8) | 0.40 | - |
| 5 | 25 | 0.60 | -2.0 (-5.1) | -0.9 (2.7) | 0.27 | - |
| 5 | 20 | 1.00 | -2.8 (-4.9) | -1.1 (2.5) | 0.24 | - |
| 5 | 15 | 1.00 | -3.4 (-5.2) | -1.1 (2.4) | 0.12 | - |
| 5 | 12 | 0.00 | -3.7 (-4.8) | -0.9 (2.1) | 0.41 | - |
| 5 | 9 | 0.00 | -2.6 (-4.7) | -2.1 (1.9) | 0.39 | - |

### plan_s1: per stairs (rise / tread cm): climbed, shift front / rear cm (plan), 3 paws down, gate in the zone

| rise | tread | climbed | shift front | shift rear | 3 down | gate zone |
|---|---|---|---|---|---|---|
| 1 | 25 | 1.00 | 0.7 (-5.1) | 1.3 (3.3) | 0.08 | 0.98 |
| 1 | 20 | 1.00 | 0.5 (-4.7) | 1.3 (3.2) | 0.14 | 0.99 |
| 1 | 15 | 1.00 | 0.7 (-4.8) | 1.1 (3.4) | 0.17 | 0.97 |
| 1 | 12 | 1.00 | 0.2 (-4.6) | 0.9 (3.2) | 0.17 | 0.98 |
| 1 | 9 | 1.00 | -0.0 (-5.2) | 0.7 (3.6) | 0.16 | 0.97 |
| 2 | 25 | 1.00 | 0.1 (-5.3) | 0.7 (3.3) | 0.20 | 0.98 |
| 2 | 20 | 1.00 | -0.3 (-4.7) | 0.5 (3.2) | 0.23 | 1.00 |
| 2 | 15 | 1.00 | -0.8 (-4.8) | 0.3 (3.4) | 0.16 | 0.98 |
| 2 | 12 | 1.00 | -0.8 (-4.5) | 0.1 (3.3) | 0.12 | 0.99 |
| 2 | 9 | 1.00 | -1.3 (-5.1) | -0.1 (3.6) | 0.16 | 0.99 |
| 3 | 25 | 1.00 | -0.8 (-5.0) | 0.3 (3.3) | 0.19 | 1.00 |
| 3 | 20 | 1.00 | -1.3 (-4.7) | -0.1 (3.1) | 0.19 | 1.00 |
| 3 | 15 | 1.00 | -1.6 (-4.4) | -0.3 (3.3) | 0.16 | 0.97 |
| 3 | 12 | 1.00 | -1.7 (-4.5) | -0.5 (3.3) | 0.16 | 1.00 |
| 3 | 9 | 1.00 | -1.6 (-5.3) | -0.8 (3.0) | 0.13 | 0.98 |
| 4 | 25 | 0.90 | -1.8 (-4.8) | -0.4 (3.3) | 0.19 | 0.98 |
| 4 | 20 | 1.00 | -1.6 (-4.7) | -0.4 (3.0) | 0.25 | 1.00 |
| 4 | 15 | 1.00 | -2.2 (-5.0) | -0.8 (2.8) | 0.18 | 0.99 |
| 4 | 12 | 0.80 | -2.8 (-5.0) | -1.8 (2.9) | 0.27 | 1.00 |
| 4 | 9 | 0.10 | -3.6 (-4.5) | -2.1 (2.8) | 0.57 | 0.89 |
| 5 | 25 | 0.80 | -1.6 (-5.1) | -0.1 (2.7) | 0.16 | 0.99 |
| 5 | 20 | 0.90 | -2.8 (-4.9) | -1.0 (2.5) | 0.28 | 1.00 |
| 5 | 15 | 0.90 | -3.0 (-5.2) | -1.2 (2.4) | 0.24 | 0.97 |
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
| plan_s1 | 0.7 % (0.45) | 0.4 % (0.43) | 13.0 W |
| plan_s2 | 0.9 % (0.45) | 0.9 % (0.43) | 12.9 W |
| own_s1 | 1.1 % (0.45) | 0.6 % (0.43) | 12.9 W |
| own_s2 | 1.4 % (0.45) | 0.8 % (0.43) | 12.9 W |

One shove while walking (stays up / gets up / stays down):

| dog | 0.3 m/s | 0.5 m/s | 0.7 m/s | 0.9 m/s | 1.1 m/s | 1.3 m/s | 1.5 m/s |
|---|---|---|---|---|---|---|---|
| zero_s1 | 100 / 0 / 0 % | 90 / 10 / 0 % | 66 / 34 / 0 % | 60 / 40 / 0 % | 34 / 66 / 1 % | 4 / 94 / 1 % | 0 / 97 / 3 % |
| plan_s1 | 100 / 0 / 0 % | 84 / 16 / 0 % | 76 / 24 / 0 % | 56 / 44 / 0 % | 24 / 75 / 1 % | 6 / 92 / 2 % | 0 / 95 / 5 % |
| plan_s2 | 100 / 0 / 0 % | 88 / 12 / 0 % | 67 / 33 / 0 % | 55 / 45 / 0 % | 36 / 62 / 1 % | 3 / 92 / 4 % | 0 / 99 / 1 % |
| own_s1 | 100 / 0 / 0 % | 85 / 15 / 0 % | 66 / 34 / 0 % | 57 / 42 / 0 % | 36 / 63 / 1 % | 8 / 91 / 1 % | 0 / 94 / 6 % |
| own_s2 | 100 / 0 / 0 % | 85 / 15 / 0 % | 64 / 36 / 0 % | 56 / 44 / 0 % | 32 / 67 / 1 % | 4 / 95 / 1 % | 0 / 95 / 5 % |

Getting up within 8 s:

| dog | standing | dropped upright | on its side | on its back |
|---|---|---|---|---|
| zero_s1 | 100 % | 100 % | 100 % | 100 % |
| plan_s1 | 100 % | 100 % | 100 % | 100 % |
| plan_s2 | 100 % | 100 % | 100 % | 100 % |
| own_s1 | 100 % | 100 % | 100 % | 100 % |
| own_s2 | 100 % | 100 % | 100 % | 100 % |

Standing (tilt test, calm, plates up to 15 deg): share of the time still, falls:

| dog | still | fell |
|---|---|---|
| zero_s1 | 19 % | 0 % |
| plan_s1 | 19 % | 0 % |
| plan_s2 | 19 % | 0 % |
| own_s1 | 19 % | 0 % |
| own_s2 | 20 % | 0 % |

Best per variant (clean share up, treads 15 / 9 cm): {"plan": ["plan_s2", 0.378], "own": ["own_s2", 0.374], "base": ["zero_s1", 0.385]}

Videos: `videos/compare_up_r3_t15.mp4`, `videos/compare_up_r4_t9.mp4`, `videos/compare_up_r5_t15.mp4`
