ossehaas/Robot-Evolution-Lab/runs/exp2_dog/25_hard_paw/results.md

# Hard paw front: four paws on the same policies (step 46, run 2)

Paws: tpu = the old model (one TPU sphere); tpu_shaped = the printed shape all TPU; ring = PLA shell on a low TPU base ring; pla = all PLA. Same policies, no training; only the paws differ. Stumble = share of paw-steps on the way up with a paw pushed sideways more than twice as hard as it is pressed down (a toe against a riser); stuck = such a stumble lasting more than 0.3 s, per climb.

## Stairs up (lunge test, rises 1-5 cm, all treads)

| dog | climbed | stumble | stuck per climb | shift front cm | shift rear cm | nose up |
|---|---|---|---|---|---|---|
| hold_s2_tpu | 0.82 | 0.0223 | 0.38 | -1.4 | -0.2 | 8 deg |
| hold_s2_tpu_shaped | 0.69 | 0.0211 | 0.04 | -1.7 | -0.5 | 9 deg |
| hold_s2_ring | 0.72 | 0.0200 | 0.06 | -1.7 | -0.5 | 8 deg |
| hold_s2_pla | 0.73 | 0.0087 | 0.00 | -2.0 | -0.5 | 10 deg |
| zero_s1_tpu | 0.86 | 0.0167 | 0.10 | -1.6 | -0.3 | 9 deg |
| zero_s1_tpu_shaped | 0.72 | 0.0193 | 0.06 | -1.8 | -0.5 | 9 deg |
| zero_s1_ring | 0.78 | 0.0177 | 0.04 | -1.8 | -0.5 | 9 deg |
| zero_s1_pla | 0.79 | 0.0082 | 0.00 | -2.0 | -0.5 | 10 deg |

Per stairs (rise / tread cm): climbed / stuck per climb, per paw

| dog | rise | tread | tpu | tpu_shaped | ring | pla |
|---|---|---|---|---|---|---|
| hold_s2 | 1 | 25 | 1.00 / 0.00 | 1.00 / 0.00 | 1.00 / 0.00 | 1.00 / 0.00 |
| hold_s2 | 1 | 20 | 1.00 / 0.00 | 1.00 / 0.00 | 1.00 / 0.00 | 1.00 / 0.00 |
| hold_s2 | 1 | 15 | 1.00 / 0.00 | 1.00 / 0.00 | 1.00 / 0.00 | 1.00 / 0.00 |
| hold_s2 | 1 | 12 | 1.00 / 0.00 | 1.00 / 0.00 | 1.00 / 0.00 | 1.00 / 0.00 |
| hold_s2 | 1 | 9 | 1.00 / 0.00 | 1.00 / 0.00 | 1.00 / 0.00 | 1.00 / 0.00 |
| hold_s2 | 2 | 25 | 1.00 / 0.10 | 1.00 / 0.00 | 0.90 / 0.10 | 1.00 / 0.00 |
| hold_s2 | 2 | 20 | 1.00 / 0.00 | 1.00 / 0.00 | 1.00 / 0.00 | 1.00 / 0.00 |
| hold_s2 | 2 | 15 | 1.00 / 0.00 | 1.00 / 0.00 | 1.00 / 0.10 | 1.00 / 0.00 |
| hold_s2 | 2 | 12 | 1.00 / 0.00 | 1.00 / 0.00 | 1.00 / 0.00 | 1.00 / 0.00 |
| hold_s2 | 2 | 9 | 1.00 / 0.00 | 1.00 / 0.00 | 1.00 / 0.00 | 1.00 / 0.00 |
| hold_s2 | 3 | 25 | 1.00 / 0.00 | 0.90 / 0.00 | 0.90 / 0.00 | 0.90 / 0.00 |
| hold_s2 | 3 | 20 | 1.00 / 0.00 | 0.90 / 0.00 | 1.00 / 0.00 | 1.00 / 0.00 |
| hold_s2 | 3 | 15 | 1.00 / 0.00 | 1.00 / 0.00 | 1.00 / 0.10 | 1.00 / 0.00 |
| hold_s2 | 3 | 12 | 1.00 / 0.00 | 1.00 / 0.00 | 1.00 / 0.00 | 1.00 / 0.00 |
| hold_s2 | 3 | 9 | 1.00 / 0.00 | 1.00 / 0.10 | 1.00 / 0.10 | 1.00 / 0.00 |
| hold_s2 | 4 | 25 | 1.00 / 0.80 | 0.20 / 0.00 | 0.60 / 0.00 | 0.20 / 0.00 |
| hold_s2 | 4 | 20 | 1.00 / 0.10 | 0.70 / 0.00 | 0.90 / 0.10 | 0.90 / 0.00 |
| hold_s2 | 4 | 15 | 0.90 / 0.10 | 1.00 / 0.00 | 0.90 / 0.00 | 1.00 / 0.00 |
| hold_s2 | 4 | 12 | 0.60 / 0.50 | 0.60 / 0.00 | 0.40 / 0.00 | 0.80 / 0.00 |
| hold_s2 | 4 | 9 | 0.00 / 1.00 | 0.00 / 0.30 | 0.00 / 0.00 | 0.00 / 0.00 |
| hold_s2 | 5 | 25 | 0.70 / 0.80 | 0.00 / 0.00 | 0.00 / 0.00 | 0.00 / 0.00 |
| hold_s2 | 5 | 20 | 0.90 / 0.10 | 0.00 / 0.10 | 0.20 / 0.20 | 0.40 / 0.00 |
| hold_s2 | 5 | 15 | 0.50 / 0.80 | 0.00 / 0.30 | 0.10 / 0.40 | 0.10 / 0.00 |
| hold_s2 | 5 | 12 | 0.00 / 0.80 | 0.00 / 0.20 | 0.00 / 0.40 | 0.00 / 0.00 |
| hold_s2 | 5 | 9 | 0.00 / 4.50 | 0.00 / 0.10 | 0.00 / 0.00 | 0.00 / 0.00 |
| zero_s1 | 1 | 25 | 1.00 / 0.00 | 1.00 / 0.00 | 1.00 / 0.00 | 1.00 / 0.00 |
| zero_s1 | 1 | 20 | 1.00 / 0.00 | 1.00 / 0.00 | 1.00 / 0.00 | 1.00 / 0.00 |
| zero_s1 | 1 | 15 | 1.00 / 0.00 | 1.00 / 0.00 | 1.00 / 0.00 | 1.00 / 0.00 |
| zero_s1 | 1 | 12 | 1.00 / 0.00 | 1.00 / 0.00 | 1.00 / 0.00 | 1.00 / 0.00 |
| zero_s1 | 1 | 9 | 1.00 / 0.00 | 1.00 / 0.00 | 1.00 / 0.00 | 1.00 / 0.00 |
| zero_s1 | 2 | 25 | 1.00 / 0.00 | 1.00 / 0.00 | 1.00 / 0.10 | 1.00 / 0.00 |
| zero_s1 | 2 | 20 | 1.00 / 0.00 | 1.00 / 0.00 | 1.00 / 0.00 | 1.00 / 0.00 |
| zero_s1 | 2 | 15 | 1.00 / 0.00 | 1.00 / 0.00 | 1.00 / 0.00 | 1.00 / 0.00 |
| zero_s1 | 2 | 12 | 1.00 / 0.00 | 1.00 / 0.00 | 1.00 / 0.00 | 1.00 / 0.00 |
| zero_s1 | 2 | 9 | 1.00 / 0.00 | 1.00 / 0.00 | 1.00 / 0.00 | 1.00 / 0.00 |
| zero_s1 | 3 | 25 | 1.00 / 0.00 | 1.00 / 0.00 | 1.00 / 0.00 | 1.00 / 0.00 |
| zero_s1 | 3 | 20 | 1.00 / 0.00 | 1.00 / 0.00 | 1.00 / 0.00 | 1.00 / 0.00 |
| zero_s1 | 3 | 15 | 1.00 / 0.00 | 1.00 / 0.00 | 1.00 / 0.00 | 1.00 / 0.00 |
| zero_s1 | 3 | 12 | 1.00 / 0.00 | 1.00 / 0.00 | 1.00 / 0.00 | 1.00 / 0.00 |
| zero_s1 | 3 | 9 | 1.00 / 0.10 | 1.00 / 0.00 | 1.00 / 0.00 | 1.00 / 0.00 |
| zero_s1 | 4 | 25 | 1.00 / 0.00 | 0.30 / 0.00 | 0.70 / 0.10 | 0.60 / 0.00 |
| zero_s1 | 4 | 20 | 1.00 / 0.00 | 0.60 / 0.20 | 1.00 / 0.00 | 1.00 / 0.00 |
| zero_s1 | 4 | 15 | 1.00 / 0.00 | 0.90 / 0.20 | 1.00 / 0.00 | 1.00 / 0.00 |
| zero_s1 | 4 | 12 | 0.80 / 0.00 | 0.70 / 0.10 | 0.90 / 0.10 | 0.90 / 0.00 |
| zero_s1 | 4 | 9 | 0.00 / 0.80 | 0.00 / 0.20 | 0.00 / 0.10 | 0.00 / 0.00 |
| zero_s1 | 5 | 25 | 1.00 / 0.10 | 0.00 / 0.00 | 0.00 / 0.00 | 0.00 / 0.00 |
| zero_s1 | 5 | 20 | 1.00 / 0.20 | 0.00 / 0.20 | 0.30 / 0.10 | 1.00 / 0.00 |
| zero_s1 | 5 | 15 | 0.80 / 0.00 | 0.50 / 0.10 | 0.60 / 0.20 | 0.20 / 0.00 |
| zero_s1 | 5 | 12 | 0.00 / 0.10 | 0.00 / 0.30 | 0.00 / 0.20 | 0.00 / 0.00 |
| zero_s1 | 5 | 9 | 0.00 / 1.10 | 0.00 / 0.10 | 0.00 / 0.00 | 0.00 / 0.00 |

## Stairs goal test (clean = reached without any fall, open sides)

| dog | mean clean | up | down | limits up (treads 25-9) | limits down |
|---|---|---|---|---|---|
| hold_s2_tpu | 0.361 | 0.415 | 0.308 | 4 / 4 / 3 / 3 / 2 | 3 / 2 / 2 / 1 / 1 |
| hold_s2_tpu_shaped | 0.329 | 0.387 | 0.271 | 4 / 4 / 3 / 3 / 2 | 3 / 3 / 2 / 1 / 1 |
| hold_s2_ring | 0.327 | 0.394 | 0.260 | 4 / 4 / 4 / 3 / 2 | 3 / 3 / 2 / 1 / 1 |
| hold_s2_pla | 0.300 | 0.387 | 0.214 | 4 / 4 / 3 / 3 / 2 | 3 / 2 / 1 / 1 / 1 |
| zero_s1_tpu | 0.382 | 0.430 | 0.334 | 5 / 5 / 3 / 3 / 3 | 3 / 2 / 2 / 1 / 1 |
| zero_s1_tpu_shaped | 0.350 | 0.390 | 0.309 | 4 / 4 / 3 / 3 / 2 | 4 / 3 / 2 / 1 / 1 |
| zero_s1_ring | 0.362 | 0.407 | 0.318 | 4 / 4 / 4 / 3 / 2 | 4 / 3 / 2 / 1 / 1 |
| zero_s1_pla | 0.331 | 0.404 | 0.259 | 4 / 5 / 4 / 3 / 3 | 3 / 2 / 1 / 1 / 1 |

## Walking, getting up, shoves, standing on tilted plates

| dog | forward falls (score) | course falls (score) | power |
|---|---|---|---|
| hold_s2_tpu | 1.0 % (0.45) | 0.9 % (0.43) | 12.7 W |
| hold_s2_tpu_shaped | 0.5 % (0.30) | 0.7 % (0.34) | 13.5 W |
| hold_s2_ring | 0.4 % (0.30) | 0.8 % (0.34) | 13.5 W |
| hold_s2_pla | 0.2 % (0.31) | 1.0 % (0.35) | 10.6 W |
| zero_s1_tpu | 0.8 % (0.45) | 0.7 % (0.43) | 13.0 W |
| zero_s1_tpu_shaped | 0.3 % (0.31) | 0.5 % (0.35) | 14.1 W |
| zero_s1_ring | 0.5 % (0.31) | 0.4 % (0.34) | 13.8 W |
| zero_s1_pla | 0.3 % (0.32) | 1.1 % (0.35) | 10.8 W |

Getting up within 8 s:

| dog | standing | dropped upright | on its side | on its back |
|---|---|---|---|---|
| hold_s2_tpu | 99 % | 92 % | 100 % | 100 % |
| hold_s2_tpu_shaped | 83 % | 82 % | 100 % | 99 % |
| hold_s2_ring | 80 % | 84 % | 100 % | 99 % |
| hold_s2_pla | 85 % | 84 % | 100 % | 100 % |
| zero_s1_tpu | 100 % | 100 % | 100 % | 100 % |
| zero_s1_tpu_shaped | 100 % | 99 % | 100 % | 100 % |
| zero_s1_ring | 100 % | 99 % | 100 % | 100 % |
| zero_s1_pla | 100 % | 100 % | 100 % | 100 % |

One shove while walking (stays up / gets up / stays down):

| dog | 0.3 m/s | 0.5 m/s | 0.7 m/s | 0.9 m/s | 1.1 m/s | 1.3 m/s | 1.5 m/s |
|---|---|---|---|---|---|---|---|
| hold_s2_tpu | 100 / 0 / 0 % | 97 / 3 / 0 % | 67 / 33 / 0 % | 58 / 42 / 0 % | 27 / 68 / 4 % | 3 / 92 / 6 % | 0 / 93 / 7 % |
| hold_s2_tpu_shaped | 100 / 0 / 0 % | 100 / 0 / 0 % | 94 / 6 / 0 % | 70 / 30 / 0 % | 44 / 56 / 0 % | 21 / 75 / 4 % | 10 / 90 / 0 % |
| hold_s2_ring | 100 / 0 / 0 % | 100 / 0 / 0 % | 94 / 6 / 0 % | 75 / 25 / 0 % | 52 / 48 / 0 % | 18 / 79 / 3 % | 3 / 94 / 3 % |
| hold_s2_pla | 100 / 0 / 0 % | 100 / 0 / 0 % | 99 / 1 / 0 % | 86 / 14 / 0 % | 65 / 35 / 0 % | 51 / 49 / 0 % | 35 / 64 / 1 % |
| zero_s1_tpu | 100 / 0 / 0 % | 86 / 14 / 0 % | 66 / 34 / 0 % | 55 / 45 / 0 % | 30 / 69 / 1 % | 3 / 92 / 5 % | 0 / 95 / 5 % |
| zero_s1_tpu_shaped | 100 / 0 / 0 % | 100 / 0 / 0 % | 97 / 3 / 0 % | 76 / 24 / 0 % | 44 / 56 / 0 % | 30 / 68 / 1 % | 10 / 88 / 1 % |
| zero_s1_ring | 100 / 0 / 0 % | 100 / 0 / 0 % | 97 / 3 / 0 % | 67 / 33 / 0 % | 45 / 55 / 0 % | 27 / 73 / 0 % | 11 / 86 / 3 % |
| zero_s1_pla | 100 / 0 / 0 % | 100 / 0 / 0 % | 100 / 0 / 0 % | 90 / 10 / 0 % | 73 / 27 / 0 % | 57 / 42 / 0 % | 49 / 51 / 0 % |

Standing on tilted plates (calm / shoved 0.3 m/s): still % up to 15 deg, falls up to 15 deg, falls at 20 deg:

| dog | calm still | calm falls <= 15 | calm falls 20 | shoved falls <= 15 | shoved falls 20 |
|---|---|---|---|---|---|
| hold_s2_tpu | 20 % | 0 % | 35 % | 0 % | 43 % |
| hold_s2_tpu_shaped | 14 % | 0 % | 22 % | 0 % | 35 % |
| hold_s2_ring | 12 % | 0 % | 32 % | 0 % | 22 % |
| hold_s2_pla | 19 % | 2 % | 100 % | 2 % | 100 % |
| zero_s1_tpu | 19 % | 0 % | 18 % | 0 % | 8 % |
| zero_s1_tpu_shaped | 17 % | 0 % | 8 % | 0 % | 0 % |
| zero_s1_ring | 16 % | 0 % | 5 % | 0 % | 0 % |
| zero_s1_pla | 26 % | 0 % | 100 % | 0 % | 100 % |

Videos: `videos/compare_down_r4_t15.mp4`, `videos/compare_up_r3_t15.mp4`, `videos/compare_up_r4_t9.mp4`
