ossehaas/Robot-Evolution-Lab/runs/exp2_dog/31_copy_plans/results.md

# The standing legs copy the plans (step 51)

teach_s1 = step 49's dog, the others trained on from it. Lunge test against the capped plans, on the stairs that have one.

## Stairs up, mean over the stairs

| dog | climbed | nose up deg | rear paw up: body ahead cm | front paw up: body ahead cm | front paw up: body over rear paws cm | 3 paws down | stuck per climb |
|---|---|---|---|---|---|---|---|
| teach_s1 | 0.87 | 9.3 | -0.3 | -1.7 | 20.3 | 0.15 | 0.08 |
| copy_s1 | 0.00 | - | - | - | - | - | 0.00 |
| copy_s2 | 0.00 | -4.1 | -1.1 | 2.2 | 18.3 | 0.47 | 0.00 |

## Per stairs: climbed / nose up deg / rear paw up, body ahead cm

| rise / tread | plan's shift | teach_s1 | copy_s1 | copy_s2 |
|---|---|---|---|---|
| 2 / 25 | 3.1 | 1.00 / 3 / 0.8 | 0.00 / - / - | 0.00 / -6 / - |
| 2 / 20 | 3.4 | 1.00 / 4 / 0.6 | 0.00 / - / - | 0.00 / - / - |
| 2 / 15 | 2.9 | 1.00 / 5 / 0.3 | 0.00 / - / - | 0.00 / -2 / -1.1 |
| 2 / 12 | 2.9 | 1.00 / 6 / 0.2 | 0.00 / - / - | 0.00 / - / - |
| 2 / 9 | 3.9 | 1.00 / 7 / -0.3 | 0.00 / - / - | 0.00 / - / - |
| 3 / 25 | 3.2 | 1.00 / 6 / 0.3 | 0.00 / - / - | 0.00 / - / - |
| 3 / 20 | 3.3 | 1.00 / 6 / 0.2 | 0.00 / - / - | 0.00 / - / - |
| 3 / 15 | 3.0 | 1.00 / 9 / -0.4 | 0.00 / - / - | 0.00 / - / - |
| 3 / 12 | 3.0 | 1.00 / 11 / -0.4 | 0.00 / - / - | 0.00 / - / - |
| 3 / 9 | 3.2 | 1.00 / 13 / -1.2 | 0.00 / - / - | 0.00 / - / - |
| 4 / 25 | 3.1 | 1.00 / 8 / 0.2 | 0.00 / - / - | 0.00 / - / - |
| 4 / 20 | 3.0 | 1.00 / 10 / -0.3 | 0.00 / - / - | 0.00 / - / - |
| 4 / 15 | 3.0 | 1.00 / 13 / -0.9 | 0.00 / - / - | 0.00 / - / - |
| 4 / 12 | 2.8 | 0.90 / 15 / -1.6 | 0.00 / - / - | 0.00 / - / - |
| 4 / 9 | 3.1 | 0.10 / 15 / 0.1 | 0.00 / - / - | 0.00 / - / - |
| 5 / 25 | 2.7 | 0.60 / 10 / 0.2 | 0.00 / - / - | 0.00 / - / - |
| 5 / 20 | 2.5 | 0.50 / 13 / -0.8 | 0.00 / - / - | 0.00 / - / - |
| 5 / 15 | 2.6 | 0.60 / 16 / -2.1 | 0.00 / - / - | 0.00 / - / - |

## Stairs goal test (clean = reached without any fall, open sides)

| dog | up | down | limits up (treads 25-9) |
|---|---|---|---|
| teach_s1 | 0.432 | 0.255 | 5 / 4 / 3 / 3 / 2 |
| copy_s1 | 0.000 | 0.336 | 0 / 0 / 0 / 0 / 0 |
| copy_s2 | 0.014 | 0.330 | 0 / 0 / 0 / 0 / 0 |

## Going down, per stairs: reached / any fall / steps made of 5 (refusing = few steps, no falls)

| rise / tread | teach_s1 | copy_s1 | copy_s2 |
|---|---|---|---|
| 2 / 25 | 1.00 / 0.00 / 5.0 | 1.00 / 0.00 / 5.0 | 1.00 / 0.00 / 5.0 |
| 3 / 25 | 1.00 / 0.00 / 5.0 | 0.93 / 0.05 / 5.0 | 0.95 / 0.00 / 5.0 |
| 4 / 25 | 0.65 / 0.00 / 3.8 | 0.88 / 0.12 / 4.9 | 0.82 / 0.07 / 4.9 |
| 5 / 25 | 0.40 / 0.00 / 2.6 | 0.45 / 0.57 / 4.9 | 0.82 / 0.25 / 5.0 |
| 2 / 20 | 1.00 / 0.00 / 5.0 | 1.00 / 0.00 / 5.0 | 0.95 / 0.03 / 5.0 |
| 3 / 20 | 0.65 / 0.00 / 3.5 | 0.97 / 0.00 / 5.0 | 0.85 / 0.00 / 5.0 |
| 4 / 20 | 0.33 / 0.03 / 2.0 | 0.72 / 0.28 / 5.0 | 0.72 / 0.15 / 5.0 |
| 5 / 20 | 0.07 / 0.00 / 0.7 | 0.38 / 0.80 / 4.8 | 0.65 / 0.42 / 5.0 |
| 2 / 15 | 0.97 / 0.00 / 5.0 | 0.97 / 0.00 / 4.9 | 0.88 / 0.03 / 5.0 |
| 3 / 15 | 0.30 / 0.00 / 1.8 | 0.95 / 0.07 / 4.9 | 0.80 / 0.05 / 5.0 |
| 4 / 15 | 0.03 / 0.00 / 0.5 | 0.65 / 0.47 / 5.0 | 0.47 / 0.30 / 4.9 |
| 5 / 15 | 0.00 / 0.00 / 0.0 | 0.38 / 0.97 / 4.8 | 0.35 / 0.78 / 4.7 |
| 2 / 12 | 0.62 / 0.00 / 3.3 | 0.97 / 0.03 / 5.0 | 0.75 / 0.05 / 4.8 |
| 3 / 12 | 0.17 / 0.00 / 1.2 | 0.82 / 0.17 / 4.9 | 0.57 / 0.35 / 4.8 |
| 4 / 12 | 0.00 / 0.03 / 0.1 | 0.53 / 0.70 / 4.6 | 0.55 / 0.57 / 4.6 |
| 5 / 12 | 0.00 / 0.00 / 0.0 | 0.17 / 0.93 / 4.0 | 0.30 / 0.97 / 4.6 |
| 2 / 9 | 0.42 / 0.00 / 2.8 | 1.00 / 0.00 / 5.0 | 0.70 / 0.10 / 4.9 |
| 3 / 9 | 0.00 / 0.00 / 0.1 | 0.57 / 0.50 / 4.8 | 0.47 / 0.47 / 4.8 |
| 4 / 9 | 0.00 / 0.05 / 0.0 | 0.05 / 0.97 / 4.2 | 0.30 / 0.95 / 4.5 |
| 5 / 9 | 0.00 / 0.03 / 0.0 | 0.00 / 1.00 / 3.5 | 0.00 / 0.97 / 3.8 |

## Nothing forgotten?

| dog | forward falls (score) | course falls (score) | cost of transport | get-up worst |
|---|---|---|---|---|
| teach_s1 | 0.4 % (0.38) | 0.4 % (0.39) | 3.29 | 0.99 |
| copy_s1 | 9.7 % (0.29) | 5.0 % (0.30) | 2.53 | 1.00 |
| copy_s2 | 8.6 % (0.30) | 5.1 % (0.31) | 2.70 | 0.42 |
