ossehaas/Robot-Evolution-Lab/runs/exp2_dog/32_no_stalling/results.md

# Stalling costs on a descent (step 52)

teach_s1 = step 49's dog, the others trained on from it. Lunge test against the capped plans, on the stairs that have one.

## Stairs up, mean over the stairs

| dog | climbed | nose up deg | rear paw up: body ahead cm | front paw up: body ahead cm | front paw up: body over rear paws cm | 3 paws down | stuck per climb |
|---|---|---|---|---|---|---|---|
| teach_s1 | 0.88 | 9.7 | -0.4 | -1.8 | 20.4 | 0.14 | 0.06 |
| nostall_s1 | 0.83 | 10.4 | -0.7 | -2.2 | 20.6 | 0.12 | 0.02 |
| nostall_s2 | 0.87 | 10.3 | -0.6 | -2.1 | 20.5 | 0.11 | 0.02 |

## Per stairs: climbed / nose up deg / rear paw up, body ahead cm

| rise / tread | plan's shift | teach_s1 | nostall_s1 | nostall_s2 |
|---|---|---|---|---|
| 2 / 25 | 3.1 | 1.00 / 3 / 0.8 | 1.00 / 4 / 0.5 | 1.00 / 4 / 0.5 |
| 2 / 20 | 3.4 | 1.00 / 4 / 0.6 | 1.00 / 4 / 0.4 | 1.00 / 4 / 0.3 |
| 2 / 15 | 2.9 | 1.00 / 5 / 0.3 | 1.00 / 6 / -0.0 | 1.00 / 6 / 0.1 |
| 2 / 12 | 2.9 | 1.00 / 6 / 0.1 | 1.00 / 6 / -0.4 | 1.00 / 7 / -0.1 |
| 2 / 9 | 3.9 | 1.00 / 7 / -0.4 | 1.00 / 7 / -0.3 | 1.00 / 8 / -0.4 |
| 3 / 25 | 3.2 | 1.00 / 6 / 0.6 | 1.00 / 7 / -0.1 | 1.00 / 7 / 0.1 |
| 3 / 20 | 3.3 | 1.00 / 7 / 0.2 | 1.00 / 7 / -0.3 | 1.00 / 7 / -0.4 |
| 3 / 15 | 3.0 | 1.00 / 9 / -0.3 | 1.00 / 9 / -0.6 | 1.00 / 9 / -0.6 |
| 3 / 12 | 3.0 | 1.00 / 11 / -0.6 | 1.00 / 11 / -0.7 | 1.00 / 11 / -0.7 |
| 3 / 9 | 3.2 | 1.00 / 13 / -1.1 | 1.00 / 14 / -0.8 | 1.00 / 14 / -0.9 |
| 4 / 25 | 3.1 | 1.00 / 8 / 0.4 | 1.00 / 8 / -0.1 | 1.00 / 9 / -0.3 |
| 4 / 20 | 3.0 | 1.00 / 10 / -0.3 | 1.00 / 10 / -0.9 | 1.00 / 10 / -0.9 |
| 4 / 15 | 3.0 | 1.00 / 12 / -0.8 | 1.00 / 13 / -1.0 | 1.00 / 13 / -0.7 |
| 4 / 12 | 2.8 | 1.00 / 15 / -1.1 | 0.50 / 18 / -1.6 | 1.00 / 17 / -1.7 |
| 4 / 9 | 3.1 | 0.10 / 20 / -2.4 | 0.00 / 20 / -3.0 | 0.10 / 16 / -1.8 |
| 5 / 25 | 2.7 | 0.50 / 9 / 0.1 | 0.30 / 10 / -0.4 | 0.20 / 9 / -0.4 |
| 5 / 20 | 2.5 | 0.50 / 13 / -0.8 | 0.70 / 14 / -1.4 | 0.90 / 14 / -1.4 |
| 5 / 15 | 2.6 | 0.70 / 17 / -1.7 | 0.50 / 19 / -1.7 | 0.40 / 20 / -1.8 |

## Stairs goal test (clean = reached without any fall, open sides)

| dog | up | down | limits up (treads 25-9) |
|---|---|---|---|
| teach_s1 | 0.432 | 0.255 | 5 / 4 / 3 / 3 / 2 |
| nostall_s1 | 0.407 | 0.260 | 4 / 4 / 3 / 3 / 3 |
| nostall_s2 | 0.416 | 0.257 | 4 / 4 / 4 / 3 / 2 |

## Going down, per stairs: reached / any fall / steps made of 5 (refusing = few steps, no falls)

| rise / tread | teach_s1 | nostall_s1 | nostall_s2 |
|---|---|---|---|
| 2 / 25 | 1.00 / 0.00 / 5.0 | 1.00 / 0.00 / 5.0 | 1.00 / 0.00 / 5.0 |
| 3 / 25 | 1.00 / 0.00 / 5.0 | 0.97 / 0.00 / 4.9 | 0.95 / 0.00 / 4.8 |
| 4 / 25 | 0.65 / 0.00 / 3.8 | 0.65 / 0.00 / 3.4 | 0.72 / 0.00 / 4.1 |
| 5 / 25 | 0.40 / 0.00 / 2.6 | 0.38 / 0.00 / 2.9 | 0.28 / 0.00 / 2.6 |
| 2 / 20 | 1.00 / 0.00 / 5.0 | 1.00 / 0.00 / 5.0 | 1.00 / 0.00 / 5.0 |
| 3 / 20 | 0.65 / 0.00 / 3.5 | 0.78 / 0.00 / 4.0 | 0.70 / 0.00 / 3.7 |
| 4 / 20 | 0.33 / 0.03 / 2.0 | 0.25 / 0.00 / 2.1 | 0.35 / 0.00 / 2.0 |
| 5 / 20 | 0.07 / 0.00 / 0.7 | 0.05 / 0.03 / 0.8 | 0.00 / 0.00 / 0.2 |
| 2 / 15 | 0.97 / 0.00 / 5.0 | 1.00 / 0.00 / 5.0 | 0.93 / 0.03 / 4.7 |
| 3 / 15 | 0.30 / 0.00 / 1.8 | 0.42 / 0.00 / 2.4 | 0.47 / 0.00 / 2.6 |
| 4 / 15 | 0.03 / 0.00 / 0.5 | 0.03 / 0.00 / 0.5 | 0.07 / 0.00 / 0.5 |
| 5 / 15 | 0.00 / 0.00 / 0.0 | 0.00 / 0.00 / 0.1 | 0.00 / 0.03 / 0.1 |
| 2 / 12 | 0.62 / 0.00 / 3.3 | 0.78 / 0.00 / 4.3 | 0.62 / 0.00 / 3.5 |
| 3 / 12 | 0.17 / 0.00 / 1.2 | 0.20 / 0.03 / 1.7 | 0.12 / 0.00 / 0.9 |
| 4 / 12 | 0.00 / 0.03 / 0.1 | 0.00 / 0.00 / 0.0 | 0.00 / 0.00 / 0.0 |
| 5 / 12 | 0.00 / 0.00 / 0.0 | 0.00 / 0.00 / 0.0 | 0.00 / 0.03 / 0.1 |
| 2 / 9 | 0.42 / 0.00 / 2.8 | 0.45 / 0.00 / 2.7 | 0.60 / 0.00 / 3.2 |
| 3 / 9 | 0.00 / 0.00 / 0.1 | 0.00 / 0.00 / 0.1 | 0.00 / 0.00 / 0.1 |
| 4 / 9 | 0.00 / 0.05 / 0.0 | 0.00 / 0.00 / 0.0 | 0.00 / 0.03 / 0.1 |
| 5 / 9 | 0.00 / 0.03 / 0.0 | 0.00 / 0.03 / 0.1 | 0.00 / 0.00 / 0.0 |

## Nothing forgotten?

| dog | forward falls (score) | course falls (score) | cost of transport | get-up worst |
|---|---|---|---|---|
| teach_s1 | 0.4 % (0.38) | 0.4 % (0.39) | 3.29 | 0.99 |
| nostall_s1 | 0.3 % (0.37) | 0.2 % (0.39) | 3.56 | 0.99 |
| nostall_s2 | 1.0 % (0.36) | 0.6 % (0.39) | 3.49 | 1.00 |
