ossehaas/Robot-Evolution-Lab/runs/exp2_dog/33_one_model/results.md

# One model, many skills (step 53)

teach_s1 = step 49's dog, the others trained on from it. Lunge test against the capped plans, on the stairs that have one.

## Stairs up, mean over the stairs

| dog | climbed | nose up deg | rear paw up: body ahead cm | front paw up: body ahead cm | front paw up: body over rear paws cm | 3 paws down | stuck per climb |
|---|---|---|---|---|---|---|---|
| teach_s1 | 0.88 | 9.4 | -0.4 | -1.8 | 20.3 | 0.16 | 0.09 |
| copy_s1 | 0.00 | - | - | - | - | - | 0.00 |
| heads_s1 | 0.82 | 9.5 | -0.4 | -1.8 | 20.4 | 0.15 | 0.08 |
| heads_s2 | 0.91 | 9.3 | -0.4 | -1.7 | 20.4 | 0.16 | 0.12 |
| input_s1 | 0.90 | 9.9 | -0.5 | -1.8 | 20.5 | 0.14 | 0.04 |
| input_s2 | 0.87 | 9.7 | -0.5 | -1.8 | 20.5 | 0.15 | 0.05 |
| none_s1 | 0.89 | 9.6 | -0.3 | -1.7 | 20.4 | 0.14 | 0.03 |
| none_s2 | 0.88 | 9.6 | -0.5 | -1.9 | 20.4 | 0.15 | 0.07 |

## Per stairs: climbed / nose up deg / rear paw up, body ahead cm

| rise / tread | plan's shift | teach_s1 | copy_s1 | heads_s1 | heads_s2 | input_s1 | input_s2 | none_s1 | none_s2 |
|---|---|---|---|---|---|---|---|---|---|
| 2 / 25 | 3.1 | 1.00 / 3 / 0.8 | 0.00 / - / - | 1.00 / 3 / 0.7 | 1.00 / 3 / 0.7 | 1.00 / 3 / 0.8 | 1.00 / 3 / 0.6 | 1.00 / 3 / 0.7 | 1.00 / 3 / 0.6 |
| 2 / 20 | 3.4 | 1.00 / 3 / 0.5 | 0.00 / - / - | 1.00 / 4 / 0.6 | 1.00 / 4 / 0.6 | 1.00 / 4 / 0.6 | 1.00 / 3 / 0.5 | 1.00 / 3 / 0.5 | 1.00 / 3 / 0.3 |
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
| heads_s2 | 0.9 % (0.38) | 0.3 % (0.38) | 3.12 | 0.00 |
| input_s1 | 0.5 % (0.38) | 0.8 % (0.38) | 3.31 | 0.00 |
| input_s2 | 0.9 % (0.38) | 1.1 % (0.38) | 3.09 | 0.00 |
| none_s1 | 2.6 % (0.39) | 0.9 % (0.39) | 3.01 | 0.00 |
| none_s2 | 3.5 % (0.39) | 0.7 % (0.39) | 2.99 | 0.00 |
