ossehaas/Robot-Evolution-Lab/runs/exp2_dog/11_imitation/benchmark.md

| dog | flat | course | slippery | grippy | pushes |
|---|---|---|---|---|---|
| now: D_print_s2 | 0.0% / 0.62 | 0.1% / 0.48 | 0.5% / 0.47 | 0.4% / 0.46 | 0.4% / 0.45 |
| imitation (style 6) | 0.0% / 0.59 | 1.1% / 0.43 | 2.1% / 0.42 | 1.9% / 0.41 | 11.2% / 0.39 |
| imitation + slow, seed 1 | 0.0% / 0.56 | 0.5% / 0.41 | 1.5% / 0.40 | 0.5% / 0.40 | 2.4% / 0.38 |
| imitation + slow, seed 2 | 0.0% / 0.54 | 1.2% / 0.41 | 2.3% / 0.41 | 1.8% / 0.40 | 6.0% / 0.38 |

Cells: falls / walk score. Rubble (blocks) falls per scenario:
- now: D_print_s2: course 0.0%, slippery 0.0%, grippy 1.2%, pushes 1.2%
- imitation (style 6): course 4.1%, slippery 7.1%, grippy 5.9%, pushes 17.6%
- imitation + slow, seed 1: course 1.8%, slippery 4.7%, grippy 1.2%, pushes 6.5%
- imitation + slow, seed 2: course 5.9%, slippery 8.8%, grippy 8.2%, pushes 11.8%
