ossehaas/Robot-Evolution-Lab/runs/exp2_dog/14_getup/results.md

# Getting up, being pushed, climbing (step 36)

## Stairs, walking straight on: falls and steps actually climbed (rows 6-9 = the hardest)

| dog | falls | up: steps climbed (rows 6-9) | up: falls (rows 6-9) | down: steps (rows 6-9) | down: falls (rows 6-9) |
|---|---|---|---|---|---|
| amp_w6m_slow_s1 | 1.2 % | 3.4 | 9 % | 0.4 | 1 % |
| map_depth | 9.2 % | 3.7 | 54 % | 1.3 | 27 % |
| base_s1 | 1.9 % | 0.6 | 0 % | 0.4 | 0 % |
| base_s2 | 2.7 % | 0.5 | 6 % | 0.6 | 5 % |
| stairs_s1 | 0.8 % | 0.5 | 0 % | 0.5 | 0 % |
| stairs_s2 | 0.1 % | 0.7 | 0 % | 0.5 | 0 % |
| support_s1 | 0.6 % | 0.6 | 0 % | 0.5 | 0 % |
| support_s2 | 0.2 % | 0.7 | 0 % | 0.4 | 0 % |
| student | 0.7 % | 0.7 | 3 % | 0.5 | 1 % |

## Balance: falls after one shove while walking at 20 cm/s

| dog | 0.2 m/s | 0.3 m/s | 0.4 m/s | 0.5 m/s | 0.6 m/s | 0.8 m/s | 1.0 m/s |
|---|---|---|---|---|---|---|---|
| amp_w6m_slow_s1 | 0 % | 1 % | 3 % | 9 % | 20 % | 40 % | 59 % |
| base_s1 | 0 % | 0 % | 7 % | 15 % | 23 % | 41 % | 64 % |
| stairs_s2 | 0 % | 0 % | 1 % | 0 % | 8 % | 10 % | 18 % |
| support_s2 | 1 % | 4 % | 10 % | 14 % | 20 % | 25 % | 39 % |
| student | 0 % | 0 % | 1 % | 1 % | 6 % | 8 % | 23 % |

## Getting up: share standing within 8 s (median time)

| dog | standing | dropped upright | on its side | on its back |
|---|---|---|---|---|
| amp_w6m_slow_s1 | 100 % (1.54 s) | 97 % (1.1 s) | 0 % | 0 % |
| stairs_s2 | 100 % (0.52 s) | 97 % (0.58 s) | 0 % | 0 % |
| getup_s1 | 100 % (0.12 s) | 100 % (0.26 s) | 0 % | 0 % |
| getup_s2 | 100 % (0.1 s) | 100 % (0.22 s) | 0 % | 0 % |

Video: videos/getup_<best run>.mp4
