ossehaas/Robot-Evolution-Lab/runs/exp2_dog/25_hard_paw/run1_full_pla/results.md

# Hard paw front: the soft TPU paw against a PLA housing with a TPU sole (step 46)

Same policies, no training; only the paws differ. Stumble = share of paw-steps on the way up with a paw pushed sideways more than twice as hard as it is pressed down (a toe against a riser); stuck = such a stumble lasting more than 0.3 s, per climb.

## Stairs up (lunge test, rises 1-5 cm, all treads)

| dog | climbed | stumble | stuck per climb | shift front cm | shift rear cm | nose up |
|---|---|---|---|---|---|---|
| hold_s2_tpu | 0.80 | 0.0238 | 0.40 | -1.5 | -0.3 | 8 deg |
| hold_s2_pla | 0.86 | 0.0139 | 0.00 | -1.7 | -0.1 | 7 deg |
| zero_s1_tpu | 0.86 | 0.0171 | 0.12 | -1.4 | -0.3 | 9 deg |
| zero_s1_pla | 0.86 | 0.0133 | 0.00 | -1.4 | -0.1 | 7 deg |

Per stairs (rise / tread cm): climbed, stumble, stuck per climb, TPU -> PLA

| dog | rise | tread | climbed | stumble | stuck |
|---|---|---|---|---|---|
| hold_s2 | 1 | 25 | 1.00 -> 1.00 | 0.002 -> 0.002 | 0.00 -> 0.00 |
| hold_s2 | 1 | 20 | 1.00 -> 1.00 | 0.002 -> 0.002 | 0.00 -> 0.00 |
| hold_s2 | 1 | 15 | 1.00 -> 1.00 | 0.002 -> 0.003 | 0.00 -> 0.00 |
| hold_s2 | 1 | 12 | 1.00 -> 1.00 | 0.002 -> 0.004 | 0.00 -> 0.00 |
| hold_s2 | 1 | 9 | 1.00 -> 1.00 | 0.002 -> 0.005 | 0.00 -> 0.00 |
| hold_s2 | 2 | 25 | 0.90 -> 1.00 | 0.022 -> 0.008 | 0.10 -> 0.00 |
| hold_s2 | 2 | 20 | 1.00 -> 1.00 | 0.013 -> 0.011 | 0.00 -> 0.00 |
| hold_s2 | 2 | 15 | 1.00 -> 1.00 | 0.010 -> 0.009 | 0.00 -> 0.00 |
| hold_s2 | 2 | 12 | 1.00 -> 1.00 | 0.014 -> 0.010 | 0.00 -> 0.00 |
| hold_s2 | 2 | 9 | 1.00 -> 1.00 | 0.011 -> 0.012 | 0.00 -> 0.00 |
| hold_s2 | 3 | 25 | 0.80 -> 1.00 | 0.031 -> 0.015 | 0.10 -> 0.00 |
| hold_s2 | 3 | 20 | 1.00 -> 1.00 | 0.019 -> 0.019 | 0.20 -> 0.00 |
| hold_s2 | 3 | 15 | 1.00 -> 1.00 | 0.016 -> 0.011 | 0.00 -> 0.00 |
| hold_s2 | 3 | 12 | 1.00 -> 1.00 | 0.019 -> 0.013 | 0.00 -> 0.00 |
| hold_s2 | 3 | 9 | 1.00 -> 1.00 | 0.026 -> 0.012 | 0.20 -> 0.00 |
| hold_s2 | 4 | 25 | 0.90 -> 1.00 | 0.036 -> 0.021 | 1.50 -> 0.00 |
| hold_s2 | 4 | 20 | 1.00 -> 1.00 | 0.029 -> 0.024 | 0.10 -> 0.00 |
| hold_s2 | 4 | 15 | 1.00 -> 1.00 | 0.019 -> 0.009 | 0.10 -> 0.00 |
| hold_s2 | 4 | 12 | 0.60 -> 1.00 | 0.053 -> 0.012 | 2.30 -> 0.00 |
| hold_s2 | 4 | 9 | 0.00 -> 0.10 | 0.040 -> 0.015 | 0.70 -> 0.10 |
| hold_s2 | 5 | 25 | 0.70 -> 0.60 | 0.033 -> 0.030 | 0.30 -> 0.00 |
| hold_s2 | 5 | 20 | 0.60 -> 0.90 | 0.040 -> 0.036 | 0.40 -> 0.00 |
| hold_s2 | 5 | 15 | 0.50 -> 0.80 | 0.029 -> 0.020 | 0.30 -> 0.00 |
| hold_s2 | 5 | 12 | 0.00 -> 0.00 | 0.053 -> 0.019 | 0.70 -> 0.00 |
| hold_s2 | 5 | 9 | 0.00 -> 0.00 | 0.072 -> 0.026 | 2.90 -> 0.00 |
| zero_s1 | 1 | 25 | 1.00 -> 1.00 | 0.002 -> 0.003 | 0.00 -> 0.00 |
| zero_s1 | 1 | 20 | 1.00 -> 1.00 | 0.002 -> 0.002 | 0.00 -> 0.00 |
| zero_s1 | 1 | 15 | 1.00 -> 1.00 | 0.002 -> 0.004 | 0.00 -> 0.00 |
| zero_s1 | 1 | 12 | 1.00 -> 1.00 | 0.001 -> 0.004 | 0.00 -> 0.00 |
| zero_s1 | 1 | 9 | 1.00 -> 1.00 | 0.002 -> 0.005 | 0.00 -> 0.00 |
| zero_s1 | 2 | 25 | 1.00 -> 1.00 | 0.015 -> 0.009 | 0.00 -> 0.00 |
| zero_s1 | 2 | 20 | 1.00 -> 1.00 | 0.015 -> 0.013 | 0.00 -> 0.00 |
| zero_s1 | 2 | 15 | 1.00 -> 1.00 | 0.010 -> 0.011 | 0.00 -> 0.00 |
| zero_s1 | 2 | 12 | 1.00 -> 1.00 | 0.010 -> 0.011 | 0.00 -> 0.00 |
| zero_s1 | 2 | 9 | 1.00 -> 1.00 | 0.010 -> 0.013 | 0.00 -> 0.00 |
| zero_s1 | 3 | 25 | 1.00 -> 1.00 | 0.018 -> 0.013 | 0.00 -> 0.00 |
| zero_s1 | 3 | 20 | 1.00 -> 1.00 | 0.013 -> 0.019 | 0.00 -> 0.00 |
| zero_s1 | 3 | 15 | 1.00 -> 1.00 | 0.016 -> 0.010 | 0.00 -> 0.00 |
| zero_s1 | 3 | 12 | 1.00 -> 1.00 | 0.013 -> 0.011 | 0.00 -> 0.00 |
| zero_s1 | 3 | 9 | 1.00 -> 0.90 | 0.019 -> 0.010 | 0.10 -> 0.00 |
| zero_s1 | 4 | 25 | 0.90 -> 1.00 | 0.025 -> 0.018 | 0.60 -> 0.00 |
| zero_s1 | 4 | 20 | 1.00 -> 1.00 | 0.025 -> 0.031 | 0.00 -> 0.00 |
| zero_s1 | 4 | 15 | 1.00 -> 1.00 | 0.019 -> 0.010 | 0.20 -> 0.00 |
| zero_s1 | 4 | 12 | 1.00 -> 1.00 | 0.024 -> 0.017 | 0.20 -> 0.00 |
| zero_s1 | 4 | 9 | 0.10 -> 0.20 | 0.028 -> 0.016 | 0.90 -> 0.00 |
| zero_s1 | 5 | 25 | 0.80 -> 0.80 | 0.029 -> 0.024 | 0.10 -> 0.00 |
| zero_s1 | 5 | 20 | 1.00 -> 1.00 | 0.032 -> 0.032 | 0.00 -> 0.00 |
| zero_s1 | 5 | 15 | 0.80 -> 0.60 | 0.028 -> 0.015 | 0.10 -> 0.00 |
| zero_s1 | 5 | 12 | 0.00 -> 0.00 | 0.031 -> 0.020 | 0.30 -> 0.00 |
| zero_s1 | 5 | 9 | 0.00 -> 0.00 | 0.042 -> 0.014 | 0.60 -> 0.00 |

## Stairs goal test (clean = reached without any fall, open sides)

| dog | mean clean | up | down | limits up (treads 25-9) | limits down |
|---|---|---|---|---|---|
| hold_s2_tpu | 0.359 | 0.409 | 0.309 | 4 / 4 / 3 / 3 / 2 | 3 / 2 / 2 / 1 / 1 |
| hold_s2_pla | 0.331 | 0.425 | 0.237 | 4 / 4 / 3 / 3 / 2 | 2 / 2 / 1 / 1 / 1 |
| zero_s1_tpu | 0.380 | 0.431 | 0.328 | 5 / 4 / 4 / 3 / 2 | 3 / 2 / 2 / 1 / 1 |
| zero_s1_pla | 0.356 | 0.435 | 0.279 | 5 / 4 / 4 / 3 / 2 | 2 / 2 / 1 / 1 / 1 |

## Walking, getting up, shoves, standing on tilted plates

| dog | forward falls (score) | course falls (score) | power |
|---|---|---|---|
| hold_s2_tpu | 1.0 % (0.45) | 0.2 % (0.43) | 12.7 W |
| hold_s2_pla | 1.0 % (0.36) | 1.0 % (0.38) | 10.8 W |
| zero_s1_tpu | 0.7 % (0.45) | 0.7 % (0.43) | 13.0 W |
| zero_s1_pla | 0.3 % (0.37) | 0.9 % (0.38) | 11.1 W |

Getting up within 8 s:

| dog | standing | dropped upright | on its side | on its back |
|---|---|---|---|---|
| hold_s2_tpu | 100 % | 91 % | 100 % | 100 % |
| hold_s2_pla | 91 % | 79 % | 100 % | 100 % |
| zero_s1_tpu | 100 % | 100 % | 100 % | 100 % |
| zero_s1_pla | 100 % | 100 % | 100 % | 100 % |

One shove while walking (stays up / gets up / stays down):

| dog | 0.3 m/s | 0.5 m/s | 0.7 m/s | 0.9 m/s | 1.1 m/s | 1.3 m/s | 1.5 m/s |
|---|---|---|---|---|---|---|---|
| hold_s2_tpu | 100 / 0 / 0 % | 95 / 5 / 0 % | 64 / 36 / 0 % | 52 / 47 / 1 % | 32 / 66 / 3 % | 2 / 92 / 6 % | 0 / 92 / 8 % |
| hold_s2_pla | 100 / 0 / 0 % | 100 / 0 / 0 % | 97 / 3 / 0 % | 74 / 26 / 0 % | 44 / 54 / 1 % | 21 / 79 / 0 % | 8 / 91 / 1 % |
| zero_s1_tpu | 100 / 0 / 0 % | 86 / 14 / 0 % | 68 / 32 / 0 % | 53 / 47 / 0 % | 34 / 66 / 1 % | 8 / 90 / 2 % | 1 / 96 / 3 % |
| zero_s1_pla | 100 / 0 / 0 % | 100 / 0 / 0 % | 100 / 0 / 0 % | 86 / 14 / 0 % | 47 / 53 / 0 % | 28 / 70 / 1 % | 18 / 82 / 0 % |

Standing on tilted plates (calm / shoved 0.3 m/s): still % up to 15 deg, falls up to 15 deg, falls at 20 deg:

| dog | calm still | calm falls <= 15 | calm falls 20 | shoved falls <= 15 | shoved falls 20 |
|---|---|---|---|---|---|
| hold_s2_tpu | 20 % | 0 % | 48 % | 0 % | 48 % |
| hold_s2_pla | 20 % | 0 % | 50 % | 0 % | 65 % |
| zero_s1_tpu | 20 % | 0 % | 22 % | 0 % | 15 % |
| zero_s1_pla | 31 % | 0 % | 30 % | 0 % | 32 % |

Videos: `videos/compare_down_r4_t15.mp4`, `videos/compare_up_r3_t15.mp4`, `videos/compare_up_r4_t9.mp4`
