ossehaas/Robot-Evolution-Lab/runs/exp2_dog/28_part_tests/level2/results.md

# Longer soles on the trained dogs (step 48, level 2)

Paws: tpu = the old ball (from step 46); ring = the current paw, sole out 1.5 mm; p3, p45 = sole out 3 and 4.5 mm. Same policies, no training; only the paws differ. Stumble = share of paw-steps on the way up with a paw pushed sideways more than twice as hard as it is pressed down (a toe against a riser); stuck = such a stumble lasting more than 0.3 s, per climb.

## Stairs up (lunge test, rises 1-5 cm, all treads)

| dog | climbed | stumble | stuck per climb | shift front cm | shift rear cm | nose up |
|---|---|---|---|---|---|---|
| hold_s2_tpu | 0.82 | 0.0223 | 0.38 | -1.4 | -0.2 | 8 deg |
| hold_s2_ring | 0.73 | 0.0200 | 0.04 | -1.8 | -0.6 | 9 deg |
| hold_s2_p3 | 0.78 | 0.0213 | 0.04 | -1.6 | -0.5 | 8 deg |
| hold_s2_p45 | 0.81 | 0.0226 | 0.07 | -1.6 | -0.4 | 8 deg |
| zero_s1_tpu | 0.86 | 0.0167 | 0.10 | -1.6 | -0.3 | 9 deg |
| zero_s1_ring | 0.77 | 0.0184 | 0.04 | -1.8 | -0.5 | 9 deg |
| zero_s1_p3 | 0.78 | 0.0201 | 0.07 | -1.7 | -0.4 | 8 deg |
| zero_s1_p45 | 0.84 | 0.0200 | 0.07 | -1.5 | -0.4 | 8 deg |

Per stairs (rise / tread cm): climbed / stuck per climb, per paw

| dog | rise | tread | tpu | ring | p3 | p45 |
|---|---|---|---|---|---|---|
| hold_s2 | 1 | 25 | 1.00 / 0.00 | 1.00 / 0.00 | 1.00 / 0.00 | 1.00 / 0.00 |
| hold_s2 | 1 | 20 | 1.00 / 0.00 | 1.00 / 0.00 | 1.00 / 0.00 | 1.00 / 0.00 |
| hold_s2 | 1 | 15 | 1.00 / 0.00 | 1.00 / 0.00 | 1.00 / 0.00 | 1.00 / 0.00 |
| hold_s2 | 1 | 12 | 1.00 / 0.00 | 1.00 / 0.00 | 1.00 / 0.00 | 1.00 / 0.00 |
| hold_s2 | 1 | 9 | 1.00 / 0.00 | 1.00 / 0.00 | 1.00 / 0.00 | 1.00 / 0.00 |
| hold_s2 | 2 | 25 | 1.00 / 0.10 | 1.00 / 0.00 | 1.00 / 0.00 | 1.00 / 0.00 |
| hold_s2 | 2 | 20 | 1.00 / 0.00 | 1.00 / 0.00 | 1.00 / 0.00 | 1.00 / 0.10 |
| hold_s2 | 2 | 15 | 1.00 / 0.00 | 1.00 / 0.00 | 1.00 / 0.00 | 1.00 / 0.00 |
| hold_s2 | 2 | 12 | 1.00 / 0.00 | 1.00 / 0.00 | 1.00 / 0.00 | 1.00 / 0.00 |
| hold_s2 | 2 | 9 | 1.00 / 0.00 | 1.00 / 0.00 | 1.00 / 0.00 | 1.00 / 0.00 |
| hold_s2 | 3 | 25 | 1.00 / 0.00 | 1.00 / 0.00 | 1.00 / 0.10 | 1.00 / 0.00 |
| hold_s2 | 3 | 20 | 1.00 / 0.00 | 1.00 / 0.00 | 1.00 / 0.00 | 1.00 / 0.10 |
| hold_s2 | 3 | 15 | 1.00 / 0.00 | 1.00 / 0.20 | 1.00 / 0.00 | 1.00 / 0.00 |
| hold_s2 | 3 | 12 | 1.00 / 0.00 | 1.00 / 0.00 | 1.00 / 0.00 | 1.00 / 0.00 |
| hold_s2 | 3 | 9 | 1.00 / 0.00 | 1.00 / 0.00 | 1.00 / 0.00 | 1.00 / 0.00 |
| hold_s2 | 4 | 25 | 1.00 / 0.80 | 0.60 / 0.00 | 0.80 / 0.00 | 1.00 / 0.00 |
| hold_s2 | 4 | 20 | 1.00 / 0.10 | 1.00 / 0.00 | 0.90 / 0.00 | 1.00 / 0.00 |
| hold_s2 | 4 | 15 | 0.90 / 0.10 | 1.00 / 0.00 | 1.00 / 0.00 | 1.00 / 0.10 |
| hold_s2 | 4 | 12 | 0.60 / 0.50 | 0.50 / 0.00 | 0.90 / 0.10 | 0.90 / 0.20 |
| hold_s2 | 4 | 9 | 0.00 / 1.00 | 0.00 / 0.20 | 0.00 / 0.00 | 0.20 / 0.20 |
| hold_s2 | 5 | 25 | 0.70 / 0.80 | 0.00 / 0.00 | 0.00 / 0.00 | 0.00 / 0.00 |
| hold_s2 | 5 | 20 | 0.90 / 0.10 | 0.00 / 0.00 | 0.60 / 0.00 | 0.70 / 0.10 |
| hold_s2 | 5 | 15 | 0.50 / 0.80 | 0.10 / 0.20 | 0.40 / 0.30 | 0.50 / 0.20 |
| hold_s2 | 5 | 12 | 0.00 / 0.80 | 0.00 / 0.30 | 0.00 / 0.40 | 0.00 / 0.30 |
| hold_s2 | 5 | 9 | 0.00 / 4.50 | 0.00 / 0.00 | 0.00 / 0.10 | 0.00 / 0.40 |
| zero_s1 | 1 | 25 | 1.00 / 0.00 | 1.00 / 0.00 | 1.00 / 0.00 | 1.00 / 0.00 |
| zero_s1 | 1 | 20 | 1.00 / 0.00 | 1.00 / 0.00 | 1.00 / 0.00 | 1.00 / 0.00 |
| zero_s1 | 1 | 15 | 1.00 / 0.00 | 1.00 / 0.00 | 1.00 / 0.00 | 1.00 / 0.00 |
| zero_s1 | 1 | 12 | 1.00 / 0.00 | 1.00 / 0.00 | 1.00 / 0.00 | 1.00 / 0.00 |
| zero_s1 | 1 | 9 | 1.00 / 0.00 | 1.00 / 0.00 | 1.00 / 0.00 | 1.00 / 0.00 |
| zero_s1 | 2 | 25 | 1.00 / 0.00 | 1.00 / 0.00 | 1.00 / 0.00 | 1.00 / 0.00 |
| zero_s1 | 2 | 20 | 1.00 / 0.00 | 1.00 / 0.20 | 1.00 / 0.00 | 1.00 / 0.00 |
| zero_s1 | 2 | 15 | 1.00 / 0.00 | 1.00 / 0.00 | 1.00 / 0.10 | 1.00 / 0.00 |
| zero_s1 | 2 | 12 | 1.00 / 0.00 | 1.00 / 0.00 | 1.00 / 0.00 | 1.00 / 0.00 |
| zero_s1 | 2 | 9 | 1.00 / 0.00 | 1.00 / 0.00 | 1.00 / 0.00 | 1.00 / 0.00 |
| zero_s1 | 3 | 25 | 1.00 / 0.00 | 1.00 / 0.00 | 0.90 / 0.10 | 0.90 / 0.70 |
| zero_s1 | 3 | 20 | 1.00 / 0.00 | 1.00 / 0.10 | 1.00 / 0.00 | 1.00 / 0.10 |
| zero_s1 | 3 | 15 | 1.00 / 0.00 | 1.00 / 0.00 | 1.00 / 0.00 | 1.00 / 0.10 |
| zero_s1 | 3 | 12 | 1.00 / 0.00 | 1.00 / 0.00 | 1.00 / 0.00 | 1.00 / 0.00 |
| zero_s1 | 3 | 9 | 1.00 / 0.10 | 1.00 / 0.00 | 1.00 / 0.00 | 1.00 / 0.00 |
| zero_s1 | 4 | 25 | 1.00 / 0.00 | 0.90 / 0.00 | 0.80 / 0.00 | 1.00 / 0.00 |
| zero_s1 | 4 | 20 | 1.00 / 0.00 | 1.00 / 0.00 | 0.90 / 0.40 | 1.00 / 0.00 |
| zero_s1 | 4 | 15 | 1.00 / 0.00 | 1.00 / 0.00 | 1.00 / 0.00 | 1.00 / 0.20 |
| zero_s1 | 4 | 12 | 0.80 / 0.00 | 0.70 / 0.00 | 1.00 / 0.00 | 1.00 / 0.00 |
| zero_s1 | 4 | 9 | 0.00 / 0.80 | 0.10 / 0.10 | 0.00 / 0.00 | 0.30 / 0.20 |
| zero_s1 | 5 | 25 | 1.00 / 0.10 | 0.00 / 0.00 | 0.10 / 0.00 | 0.40 / 0.00 |
| zero_s1 | 5 | 20 | 1.00 / 0.20 | 0.20 / 0.40 | 0.40 / 0.40 | 0.60 / 0.20 |
| zero_s1 | 5 | 15 | 0.80 / 0.00 | 0.30 / 0.00 | 0.50 / 0.30 | 0.70 / 0.00 |
| zero_s1 | 5 | 12 | 0.00 / 0.10 | 0.00 / 0.10 | 0.00 / 0.30 | 0.10 / 0.10 |
| zero_s1 | 5 | 9 | 0.00 / 1.10 | 0.00 / 0.10 | 0.00 / 0.10 | 0.00 / 0.10 |

## Stairs goal test (clean = reached without any fall, open sides)

| dog | mean clean | up | down | limits up (treads 25-9) | limits down |
|---|---|---|---|---|---|
| hold_s2_tpu | 0.361 | 0.415 | 0.308 | 4 / 4 / 3 / 3 / 2 | 3 / 2 / 2 / 1 / 1 |
| hold_s2_ring | 0.330 | 0.394 | 0.266 | 4 / 4 / 4 / 3 / 2 | 3 / 3 / 2 / 1 / 1 |
| hold_s2_p3 | 0.343 | 0.403 | 0.282 | 4 / 4 / 3 / 3 / 2 | 4 / 2 / 2 / 1 / 1 |
| hold_s2_p45 | 0.360 | 0.415 | 0.305 | 4 / 4 / 3 / 3 / 2 | 3 / 2 / 2 / 1 / 1 |
| zero_s1_tpu | 0.382 | 0.430 | 0.334 | 5 / 5 / 3 / 3 / 3 | 3 / 2 / 2 / 1 / 1 |
| zero_s1_ring | 0.362 | 0.405 | 0.319 | 4 / 4 / 4 / 3 / 2 | 4 / 2 / 2 / 1 / 1 |
| zero_s1_p3 | 0.368 | 0.416 | 0.320 | 4 / 4 / 4 / 3 / 3 | 4 / 3 / 2 / 1 / 1 |
| zero_s1_p45 | 0.388 | 0.423 | 0.352 | 5 / 4 / 4 / 3 / 2 | 4 / 3 / 2 / 1 / 1 |

## Walking, getting up, shoves, standing on tilted plates

| dog | forward falls (score) | course falls (score) | power | cost of transport |
|---|---|---|---|---|
| hold_s2_tpu | 1.0 % (0.45) | 0.9 % (0.43) | 12.7 W | 2.61 |
| hold_s2_ring | 0.2 % (0.30) | 0.9 % (0.34) | 13.5 W | 3.83 |
| hold_s2_p3 | 0.1 % (0.33) | 0.6 % (0.36) | 13.5 W | 3.60 |
| hold_s2_p45 | 0.3 % (0.36) | 0.9 % (0.39) | 13.7 W | 3.45 |
| zero_s1_tpu | 0.8 % (0.45) | 0.7 % (0.43) | 13.0 W | 2.69 |
| zero_s1_ring | 0.1 % (0.31) | 0.4 % (0.34) | 13.9 W | 3.88 |
| zero_s1_p3 | 0.2 % (0.34) | 0.8 % (0.36) | 14.0 W | 3.68 |
| zero_s1_p45 | 0.6 % (0.37) | 0.2 % (0.39) | 14.0 W | 3.49 |

Getting up within 8 s:

| dog | standing | dropped upright | on its side | on its back |
|---|---|---|---|---|
| hold_s2_tpu | 99 % | 92 % | 100 % | 100 % |
| hold_s2_ring | 85 % | 84 % | 100 % | 99 % |
| hold_s2_p3 | 94 % | 88 % | 99 % | 100 % |
| hold_s2_p45 | 96 % | 92 % | 100 % | 100 % |
| zero_s1_tpu | 100 % | 100 % | 100 % | 100 % |
| zero_s1_ring | 100 % | 100 % | 100 % | 99 % |
| zero_s1_p3 | 100 % | 100 % | 100 % | 100 % |
| zero_s1_p45 | 100 % | 98 % | 100 % | 100 % |

One shove while walking (stays up / gets up / stays down):

| dog | 0.3 m/s | 0.5 m/s | 0.7 m/s | 0.9 m/s | 1.1 m/s | 1.3 m/s | 1.5 m/s |
|---|---|---|---|---|---|---|---|
| hold_s2_tpu | 100 / 0 / 0 % | 97 / 3 / 0 % | 67 / 33 / 0 % | 58 / 42 / 0 % | 27 / 68 / 4 % | 3 / 92 / 6 % | 0 / 93 / 7 % |
| hold_s2_ring | 100 / 0 / 0 % | 100 / 0 / 0 % | 94 / 6 / 0 % | 68 / 32 / 0 % | 44 / 56 / 0 % | 24 / 75 / 1 % | 8 / 90 / 2 % |
| hold_s2_p3 | 100 / 0 / 0 % | 100 / 0 / 0 % | 90 / 10 / 0 % | 71 / 29 / 0 % | 38 / 60 / 1 % | 16 / 83 / 1 % | 5 / 91 / 4 % |
| hold_s2_p45 | 100 / 0 / 0 % | 99 / 1 / 0 % | 89 / 11 / 0 % | 67 / 33 / 0 % | 47 / 53 / 0 % | 17 / 82 / 1 % | 4 / 92 / 3 % |
| zero_s1_tpu | 100 / 0 / 0 % | 86 / 14 / 0 % | 66 / 34 / 0 % | 55 / 45 / 0 % | 30 / 69 / 1 % | 3 / 92 / 5 % | 0 / 95 / 5 % |
| zero_s1_ring | 100 / 0 / 0 % | 99 / 1 / 0 % | 97 / 3 / 0 % | 71 / 29 / 0 % | 43 / 57 / 0 % | 20 / 80 / 0 % | 16 / 84 / 1 % |
| zero_s1_p3 | 100 / 0 / 0 % | 100 / 0 / 0 % | 92 / 8 / 0 % | 75 / 25 / 0 % | 46 / 53 / 1 % | 26 / 73 / 1 % | 10 / 89 / 1 % |
| zero_s1_p45 | 100 / 0 / 0 % | 100 / 0 / 0 % | 94 / 6 / 0 % | 72 / 28 / 0 % | 42 / 58 / 0 % | 22 / 77 / 1 % | 6 / 92 / 3 % |

Standing on tilted plates (calm / shoved 0.3 m/s): still % up to 15 deg, falls up to 15 deg, falls at 20 deg:

| dog | calm still | calm falls <= 15 | calm falls 20 | shoved falls <= 15 | shoved falls 20 |
|---|---|---|---|---|---|
| hold_s2_tpu | 20 % | 0 % | 35 % | 0 % | 43 % |
| hold_s2_ring | 13 % | 0 % | 18 % | 0 % | 22 % |
| hold_s2_p3 | 16 % | 0 % | 25 % | 0 % | 20 % |
| hold_s2_p45 | 18 % | 0 % | 30 % | 0 % | 18 % |
| zero_s1_tpu | 19 % | 0 % | 18 % | 0 % | 8 % |
| zero_s1_ring | 16 % | 0 % | 2 % | 0 % | 0 % |
| zero_s1_p3 | 21 % | 0 % | 0 % | 0 % | 0 % |
| zero_s1_p45 | 21 % | 0 % | 2 % | 0 % | 10 % |

Videos: `videos/compare_down_r4_t15.mp4`, `videos/compare_stop_go.mp4`, `videos/compare_up_r4_t9.mp4`

Control: the ring dogs against step 46 (walk score forward / course, must match):

- hold_s2_ring: now 0.30 / 0.34, step 46 0.30 / 0.34
- zero_s1_ring: now 0.31 / 0.34, step 46 0.31 / 0.34
