ossehaas/Robot-Evolution-Lab/runs/exp2_dog/15_getup_design/results.md

# Getting up: design variants (step 37)

Share standing within 8 s (median time). Abduction = sideways leg range; head = neck/head/tail driven by the policy. Step 37 runs have self-collision on.

| run | standing | dropped upright | on its side | on its back |
|---|---|---|---|---|
| getup_s1 | 100 % (0.12 s) | 100 % (0.26 s) | 0 % | 0 % |
| getup_s2 | 100 % (0.1 s) | 100 % (0.22 s) | 0 % | 0 % |
| getup_abd29_head | 100 % (0.02 s) | 100 % (0.26 s) | 100 % (1.12 s) | 100 % (1.1 s) |
| getup_abd50 | 100 % (0.12 s) | 97 % (0.42 s) | 0 % | 0 % |
| getup_abd50_head | 100 % (0.08 s) | 100 % (0.36 s) | 0 % | 0 % |
| getup_abd80 | 100 % (0.14 s) | 100 % (0.6 s) | 100 % (1.28 s) | 100 % (1.24 s) |
| getup_abd80_head | 100 % (0.12 s) | 100 % (0.4 s) | 100 % (0.78 s) | 100 % (0.88 s) |

Videos: videos/<run>.mp4 (the four starts side by side).
