ossehaas/Robot-Evolution-Lab/(commit log)

2026-10-25 Robot Evolution Lab: code, experiments and key models
    Generate, train and evolve small 3D-printable walking robots in simulation (NVIDIA Isaac Lab, PPO).
    - core/: robot generator (genome -> printable parts, bill of materials, physics model), simulation tasks,
    training, distillation, memory students, gated behaviour cloning
    - tools/: diagnostics, benchmarks, test and video tools
    - prototypes/: the crawler and the printable puppy
    - runs/: every experiment of the crawler and the robot dog (batch scripts, settings, results), with the final
    models of the key runs; checkpoints, videos and generated files are left out
    - .documentation/: project journal and roadmap; .env_init/: how to rebuild th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
    [L0_s0_color0.stl, L0_s1_color0.stl, L0_s2_color0.stl, L0_s2_color2.stl, L0_s3_color2.stl, L1_s0_color0.stl, L1_s1_color0.stl, L1_s2_color0.stl]
2026-11-06 Steps 48-53: part tests, the 4.5 mm sole, stairs balance attempts, one model for walking, up and down
    - Part funnel (tools/parts/): paw geometry, a paw test stand, trained dogs on new paws; 4.5 mm sole with a stop pin
    - Base retrained on the new sole (29_long_sole/teach_s1)
    - Level body, copying the plan's legs, a cost for stalling on a descent (steps 50-52)
    - distill_skills.py: one model copying the walking/climbing and the descending dog, with and without a skill signal
    and per-skill output sections (step 53); key models kept
    - Isaac Lab 3.0.0 GA next to EA (lab3.cmd / lab3.sh), journal and next steps
    [components.py]
